AndreaGiulianini/lira/production/images/case-back.jpg

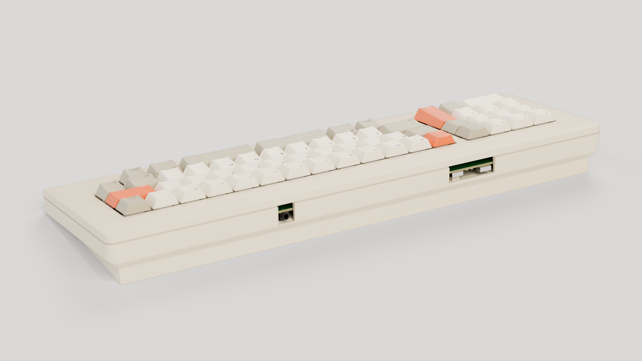
production/images/case-back.jpg
