AndreaGiulianini/lira/production/images/case-bottom.jpg

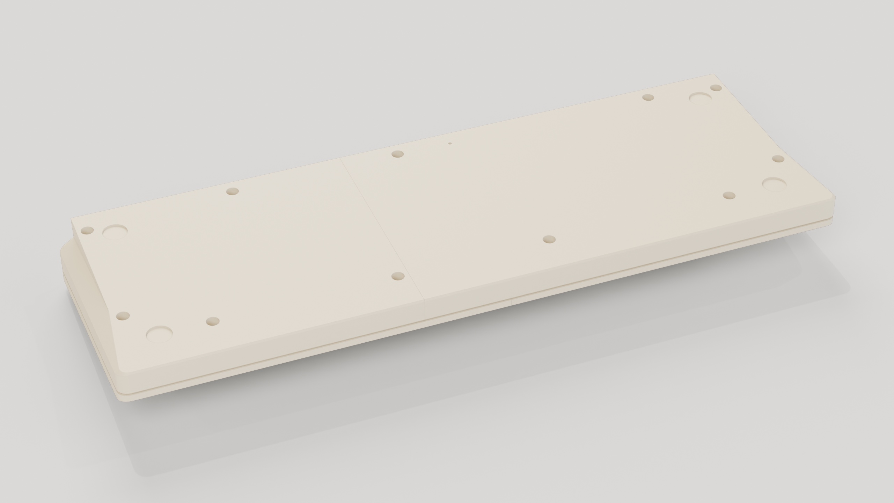
production/images/case-bottom.jpg
