AndreaGiulianini/lira/production/images/case-exploded.jpg

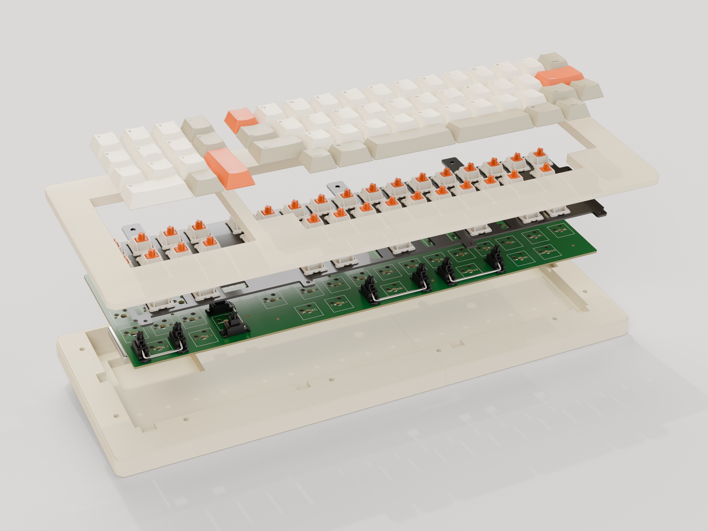
production/images/case-exploded.jpg
