AndreaGiulianini/lira/production/images/case-front.jpg

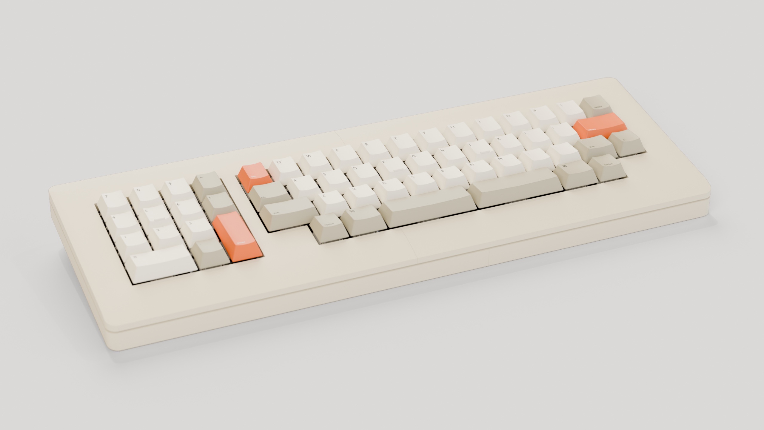
production/images/case-front.jpg
