AndreaGiulianini/lira/production/images/case-side.jpg

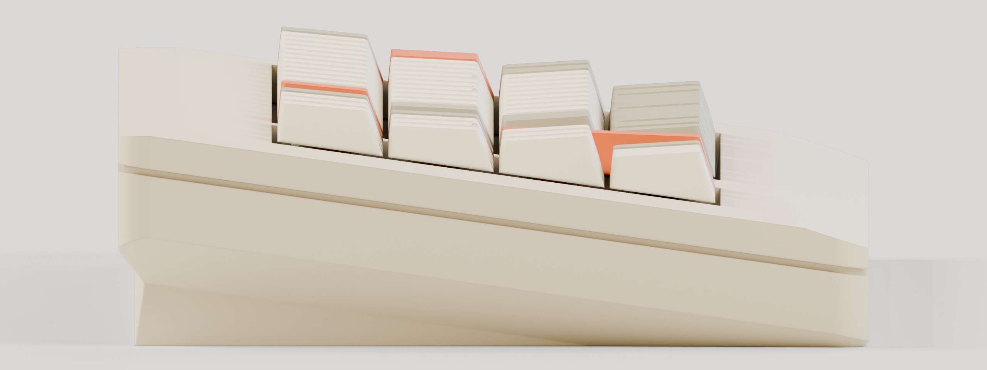
production/images/case-side.jpg
