AndreaGiulianini/lira/production/images/case-top.jpg

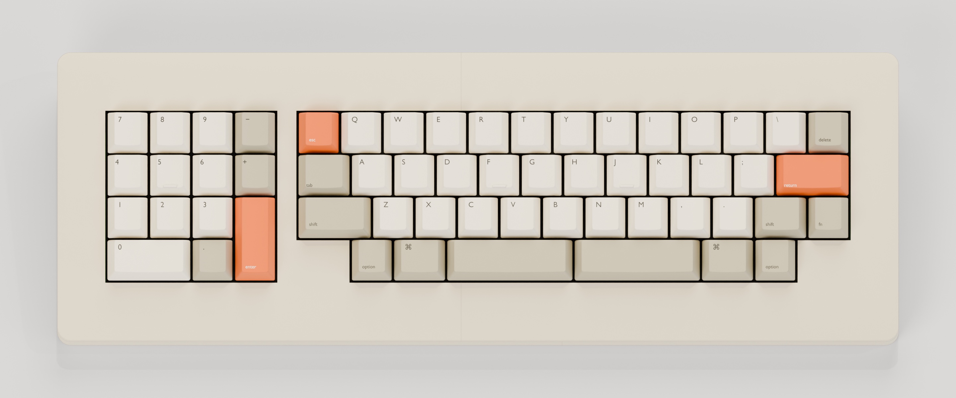
production/images/case-top.jpg
