AndreaGiulianini/lira/production/images/layout.png

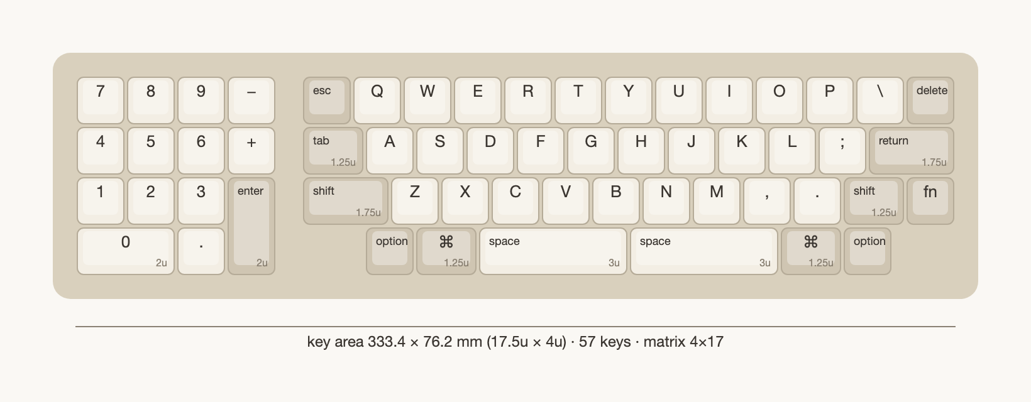
production/images/layout.png
