AndreaGiulianini/lira/production/images/pcb-bottom.jpg

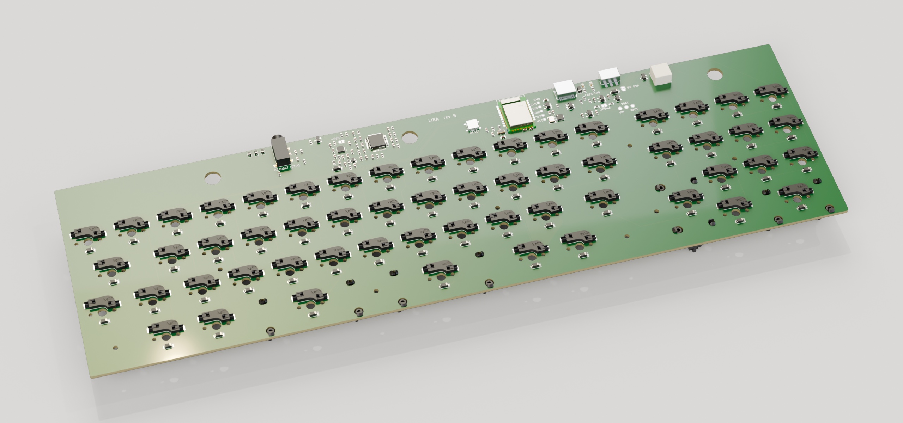
production/images/pcb-bottom.jpg
