AndreaGiulianini/lira/production/images/pcb-top.jpg

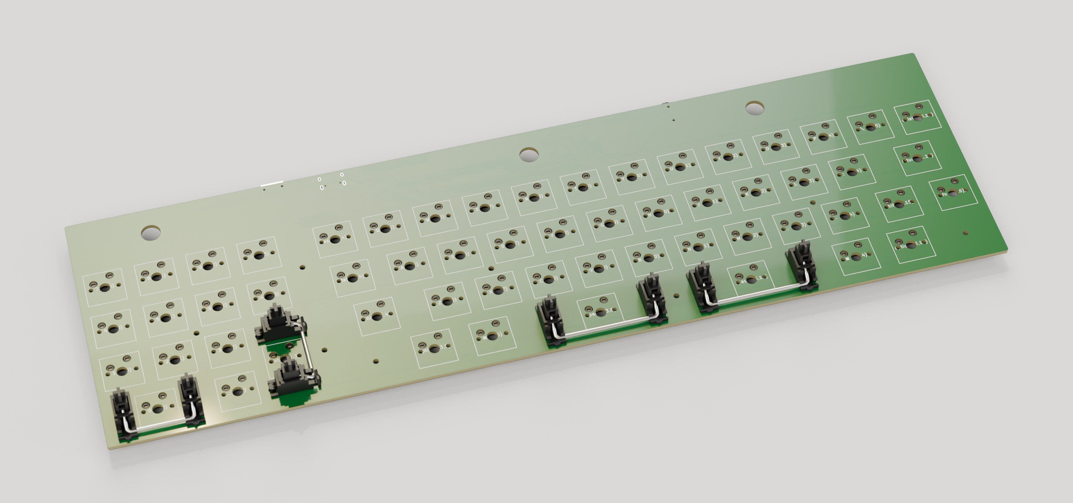
production/images/pcb-top.jpg
