AndreaGiulianini/lira/production/1-pcb-jlcpcb/bom.csv

Comment | Designator | Footprint | LCSC Part #
10uF | C101,C111,C113,C120,C121,C122 | C_0603_1608Metric | C19702
1uF | C102,C108,C110,C118,C123,C126,C129,C130,C135,C136 | C_0603_1608Metric | C15849
4.7uF | C103,C107,C116,C127 | C_0603_1608Metric | C19666
10nF | C104,C138,C139 | C_0603_1608Metric | C57112
18pF | C105,C106 | C_0603_1608Metric | C53084486
100nF | C109,C112,C114,C115,C117,C119,C137 | C_0603_1608Metric | C14663
100pF | C124,C125,C128 | C_0603_1608Metric | C14858
2.2uF | C133,C134 | C_0603_1608Metric | C23630
1N4148W | D1,D10,D11,D12,D13,D14,D15,D16,D17,D18,D19,D2,D20,D21,D22,D23,D24,D25,D26,D27,D28,D29,D3,D30,D31,D32,D33,D34,D35,D36,D37,D38,D39,D4,D40,D41,D42,D43,D44,D45,D46,D47,D48,D49,D5,D50,D51,D52,D53,D54,D55,D56,D57,D6,D7,D8,D9 | D_SOD-123 | C81598
B5819W | D101,D104 | D_SOD-123 | C8598
LED white | D102 | LED_0603_1608Metric | C2290
LED red | D103 | LED_0603_1608Metric | C2286
PESD5V0 | D105,D106,D107 | D_SOD-323 | C19224
SMF5.0A | D108 | D_SOD-123F | C193402
USB-C | J1 | USB_C_Receptacle_HRO_TYPE-C-31-M-12 | C165948
battery JST-PH | J2 | JST_PH_S2B-PH-SM4-TB_1x02-1MP_P2.00mm_Horizontal | C295747
PJ-320D-4A | J3 | Jack_3.5mm_KoreanHropartsElec_PJ-320D-4A_Horizontal | C95562
600R@100MHz | L101,L102,L103,L104 | L_0603_1608Metric | C1002
SI2301CDS | Q1,Q2 | SOT-23 | C10487
2N7002 | Q3 | SOT-23 | C8545
100k | R101,R112,R117,R125 | R_0603_1608Metric | C25803
1k | R102,R107,R116,R118 | R_0603_1608Metric | C21190
10k | R103,R104,R120,R121,R122,R123 | R_0603_1608Metric | C25804
10M | R105,R106 | R_0603_1608Metric | C7250
5.1k | R108,R109 | R_0603_1608Metric | C23186
22 | R110,R111 | R_0603_1608Metric | C23345
1M | R113 | R_0603_1608Metric | C22935
1.2k | R114 | R_0603_1608Metric | C22765
2.2k | R115 | R_0603_1608Metric | C4190
33k | R124 | R_0603_1608Metric | C4216
1 | R126 | R_0603_1608Metric | C22936
MX hot-swap socket (Kailh CPG151101S11 type) | S1,S10,S11,S12,S13,S14,S15,S16,S17,S18,S19,S2,S20,S21,S22,S23,S24,S25,S26,S27,S28,S29,S3,S30,S31,S32,S33,S34,S35,S36,S37,S38,S39,S4,S40,S41,S42,S43,S44,S45,S46,S47,S48,S49,S5,S50,S51,S52,S53,S54,S55,S56,S57,S6,S7,S8,S9 | Kailh_MX_Hotswap | C41430893
JS102011SAQN | SW101 | SW_SPDT_CK_JS102011SAQN | C221660
reset | SW102 | SW-SMD_4P-L5.1-W5.1-P3.70-LS6.5-TL_H1.5 | C318884
E73-2G4M08S1C | U1 | WIRELM-SMD_E73-2G4M08S1C | C356849
MCP73831 | U2 | SOT-23-5 | C424093
TPS7A0233 | U3,U9 | SOT-23-5 | C2887324
USBLC6-2SC6 | U4 | SOT-23-6 | C7519
CH334P | U5 | WCH_QFN-16-1EP_3x3mm_P0.5mm_EP1.8x1.8mm | C5373042
CM108B | U6 | LQFP-48_7x7mm_P0.5mm | C371347
TPA6132A2 | U7 | WQFN-16-1EP_3x3mm_P0.5mm_EP1.68x1.68mm | C69901
TPS22919 | U8 | SOT-363_SC-70-6 | C2149796
32.768kHz | Y1 | Crystal_SMD_3215-2Pin_3.2x1.5mm | C32346
12MHz | Y2 | Crystal_SMD_3225-4Pin_3.2x2.5mm | C9002
