AndreaGiulianini/lira/production/2-plate/3d-print/step/plate-left.step

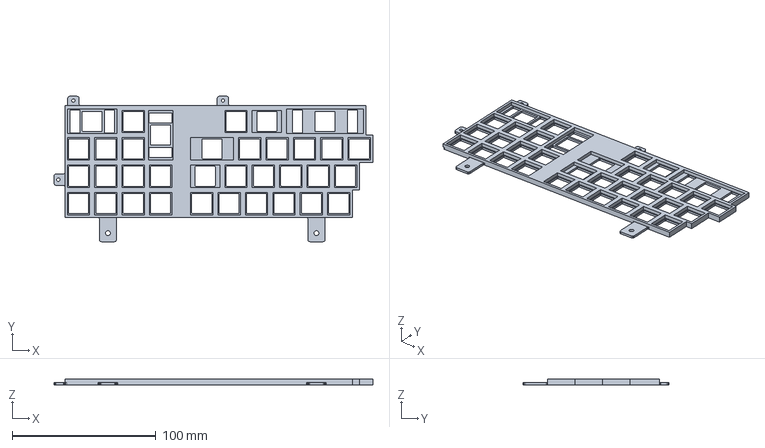
[picture p11: CAD file, 2026-10-17]
production/2-plate/3d-print/step/plate-left.step
221.8 x 101.2 x 4.00 mm
