AndreaGiulianini/lira/production/2-plate/laser-cut/plate.dxf

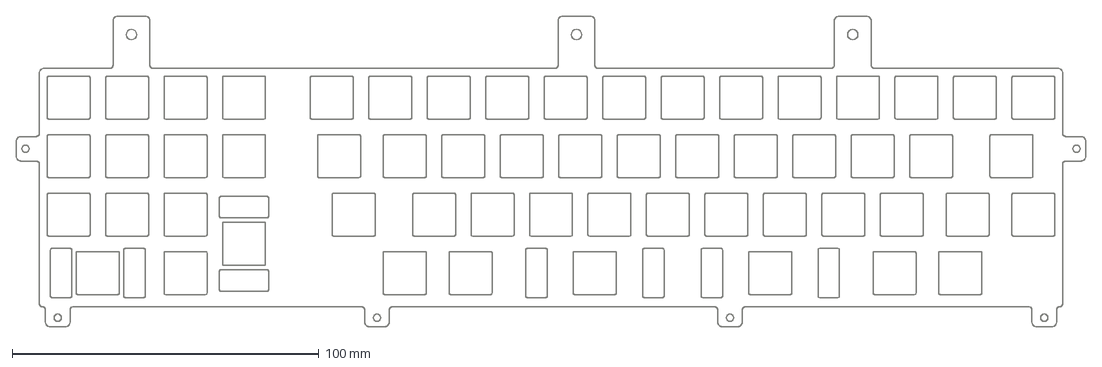
[picture p12: CAD file, 2026-10-17]
production/2-plate/laser-cut/plate.dxf
348.4 x 101.2 mm
