AndreaGiulianini/lira/production/3-case-3d-print/step/bottom-left.step

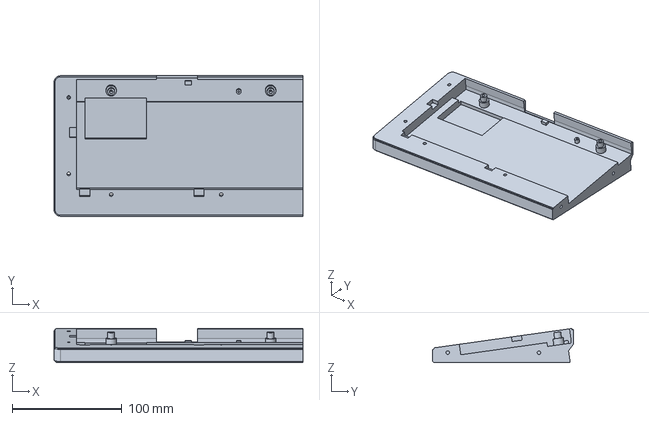
[picture p13: CAD file, 2026-10-17]
production/3-case-3d-print/step/bottom-left.step
226.4 x 127.8 x 31.0 mm
