AndreaGiulianini/lira/production/2-plate/3d-print/step/plate-right.step

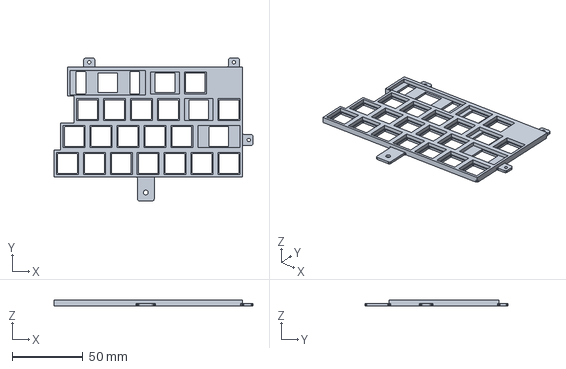
[picture p14: CAD file, 2026-10-17]
production/2-plate/3d-print/step/plate-right.step
140.8 x 101.2 x 4.00 mm
