AndreaGiulianini/lira/production/3-case-3d-print/step/top-right.step

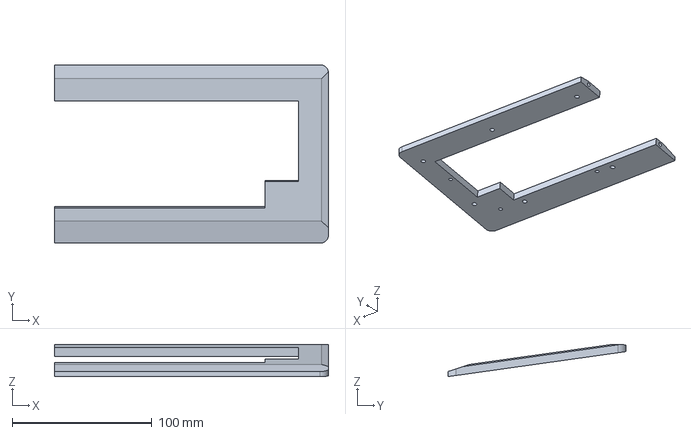
[picture p15: CAD file, 2026-10-17]
production/3-case-3d-print/step/top-right.step
196.2 x 127.8 x 23.1 mm
