AndreaGiulianini/lira/production/3-case-3d-print/step/bottom-right.step

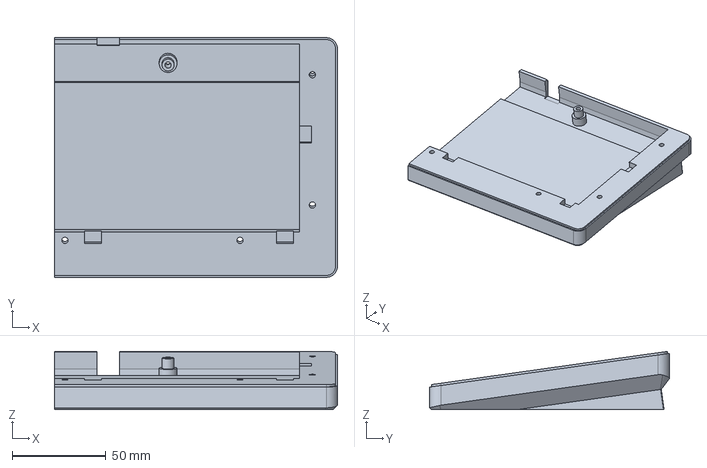
[picture p16: CAD file, 2026-10-17]
production/3-case-3d-print/step/bottom-right.step
150.9 x 127.8 x 31.0 mm
