AndreaGiulianini/lira/production/3-case-3d-print/step/top-left.step

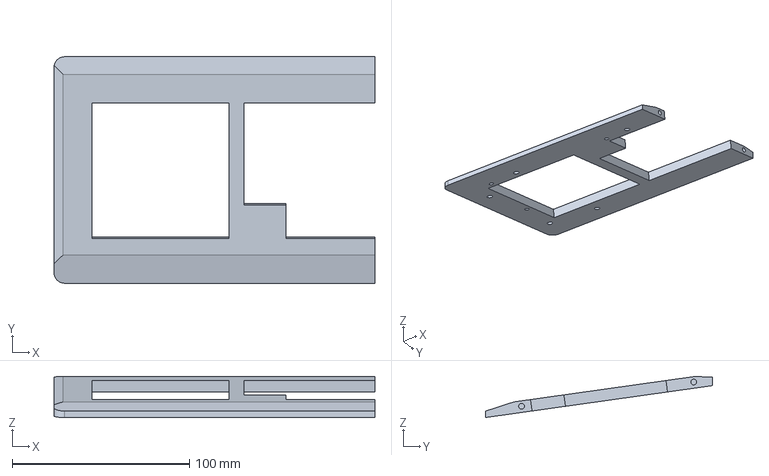
[picture p17: CAD file, 2026-10-17]
production/3-case-3d-print/step/top-left.step
181.1 x 127.8 x 23.1 mm
