AndreaGiulianini/lira/(list of files, cad)

Other CAD files:
production/2-plate/3d-print/plate-left.stl
production/2-plate/3d-print/plate-right.stl
production/3-case-3d-print/bottom-left.stl
production/3-case-3d-print/bottom-right.stl
production/3-case-3d-print/top-left.stl
production/3-case-3d-print/top-right.stl
