AndreaGiulianini/lira/production/kicad/lira.kicad_pcb

## KiCad design production/kicad/lira.kicad_pcb (2026-10-17)

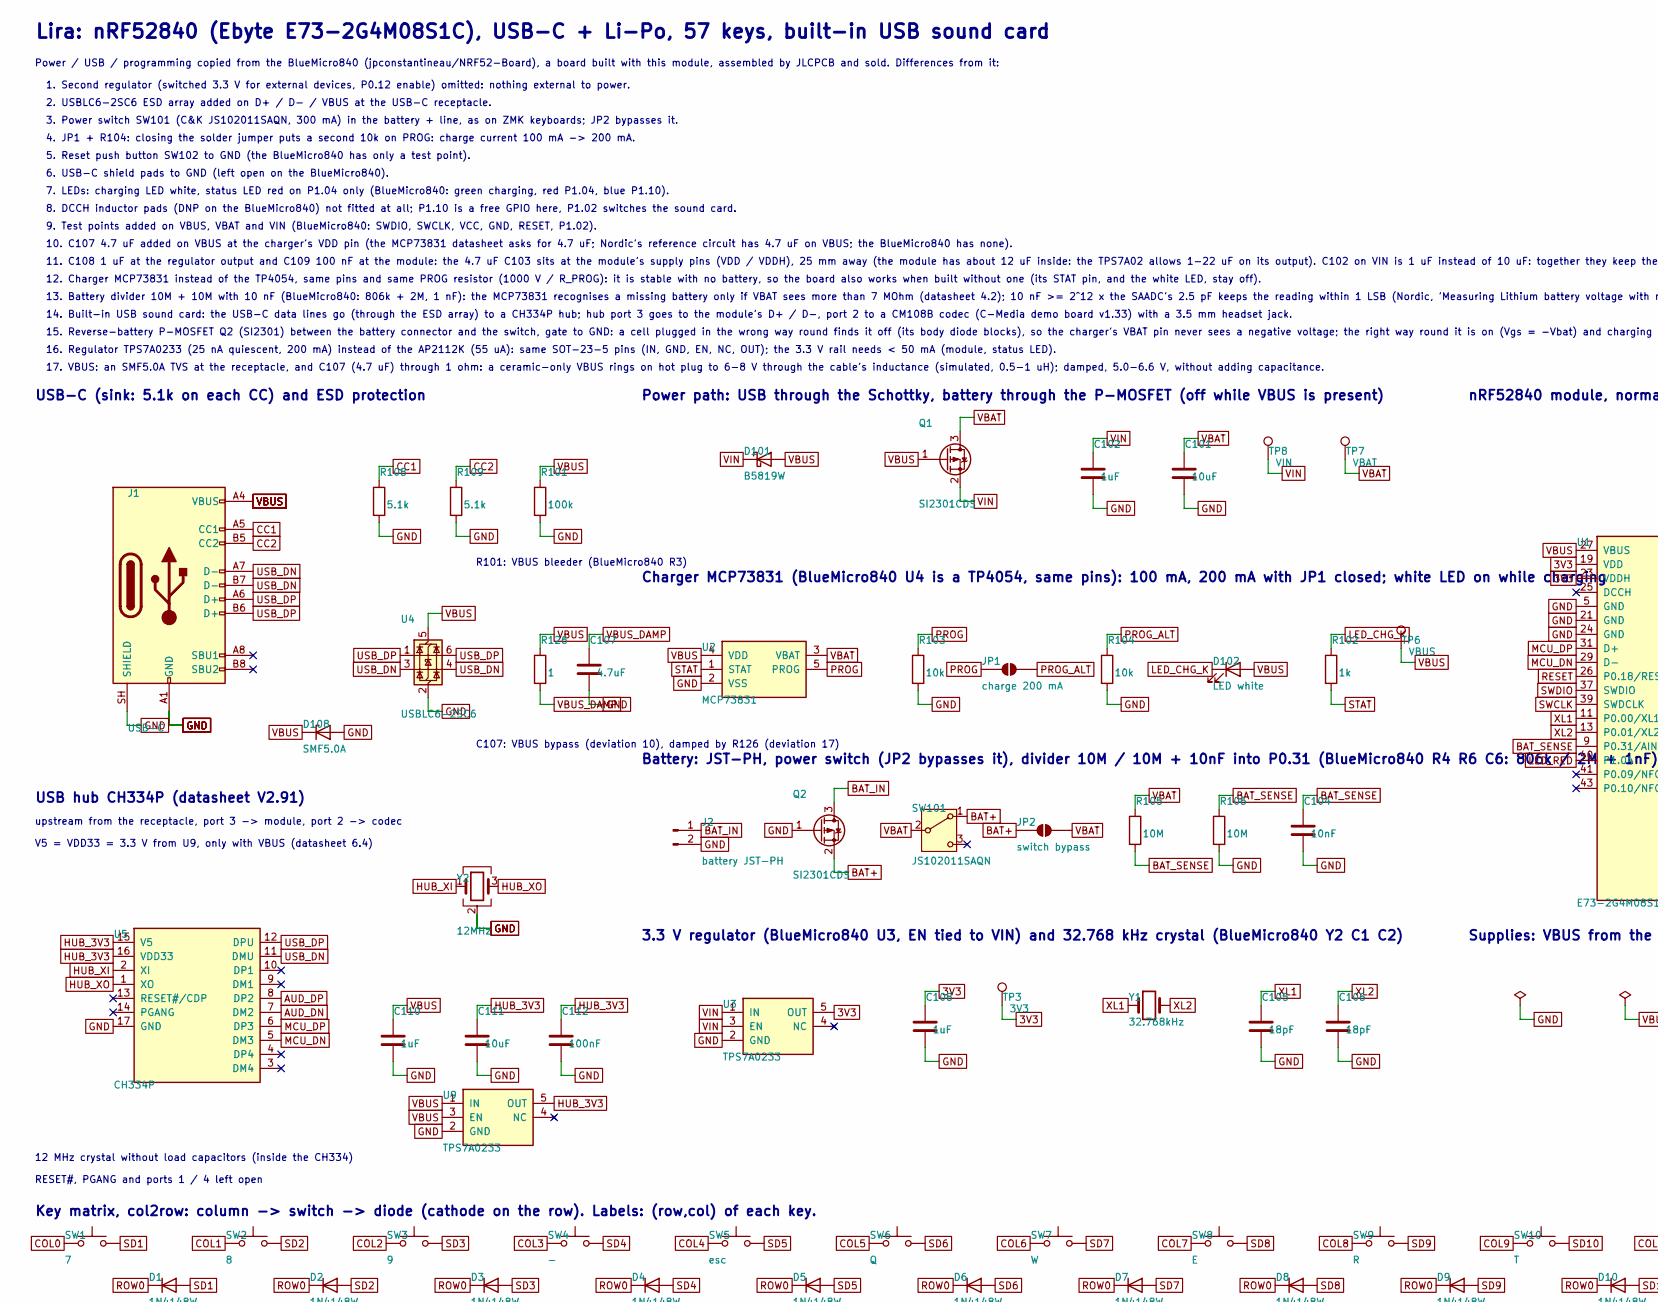
[picture p19: schematic lira.kicad_sch, part in row 1, column 1]

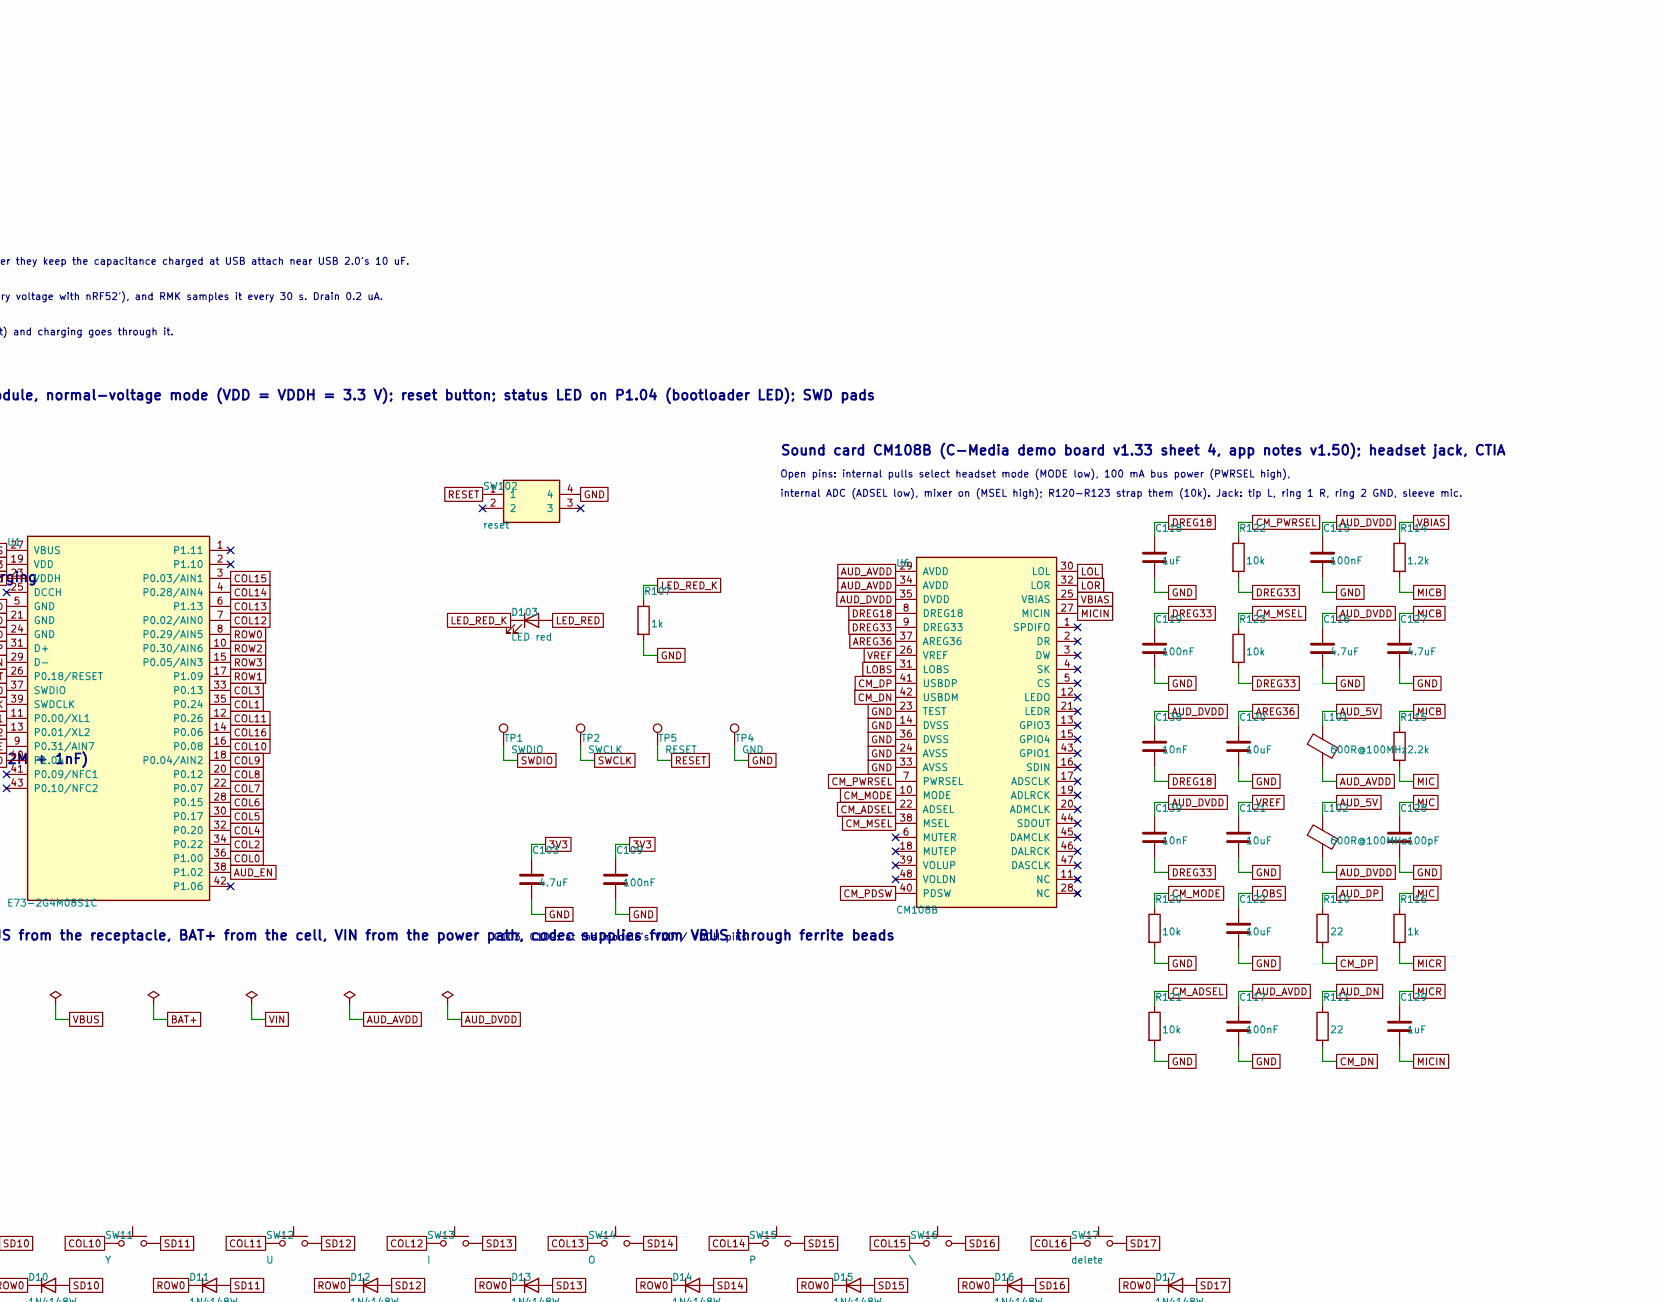
[picture p20: schematic lira.kicad_sch, part in row 1, column 2]

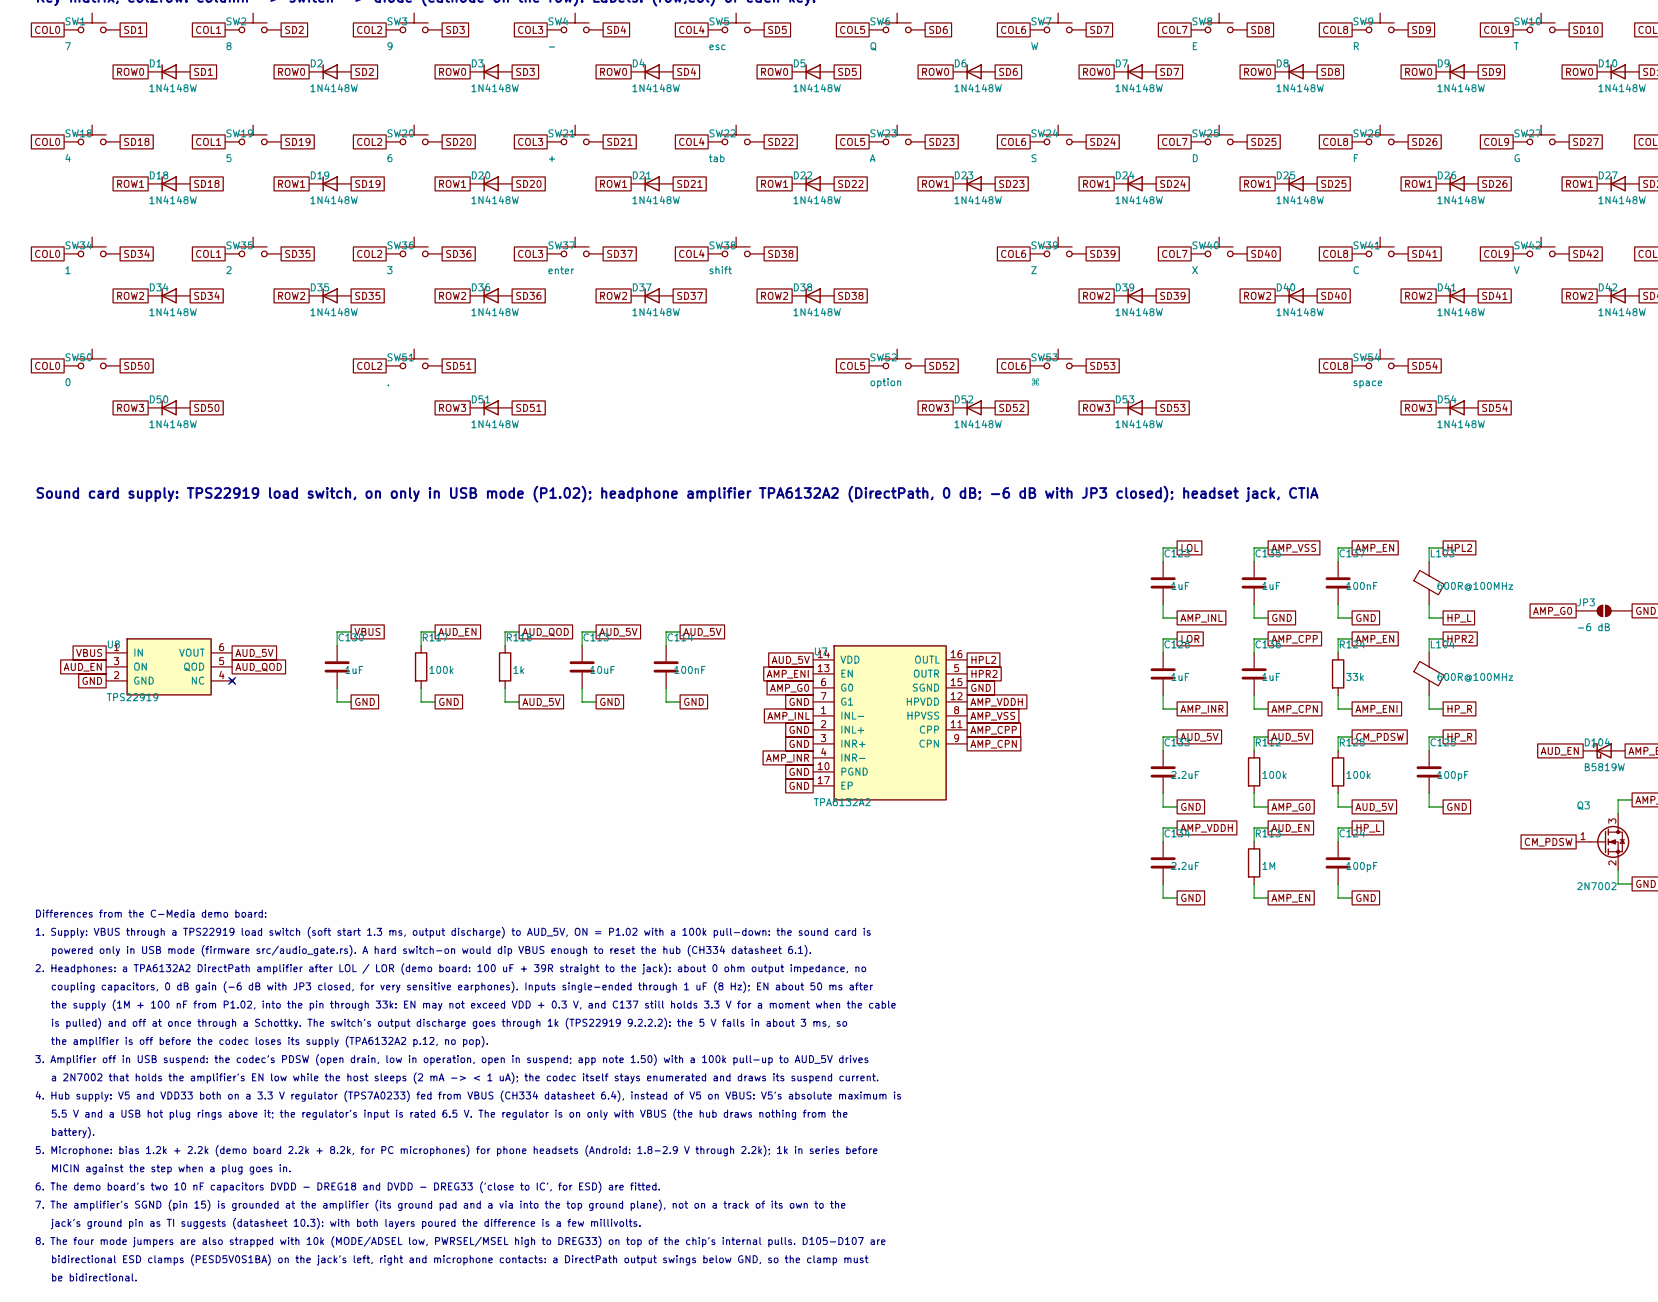
[picture p21: schematic lira.kicad_sch, part in row 2, column 1]

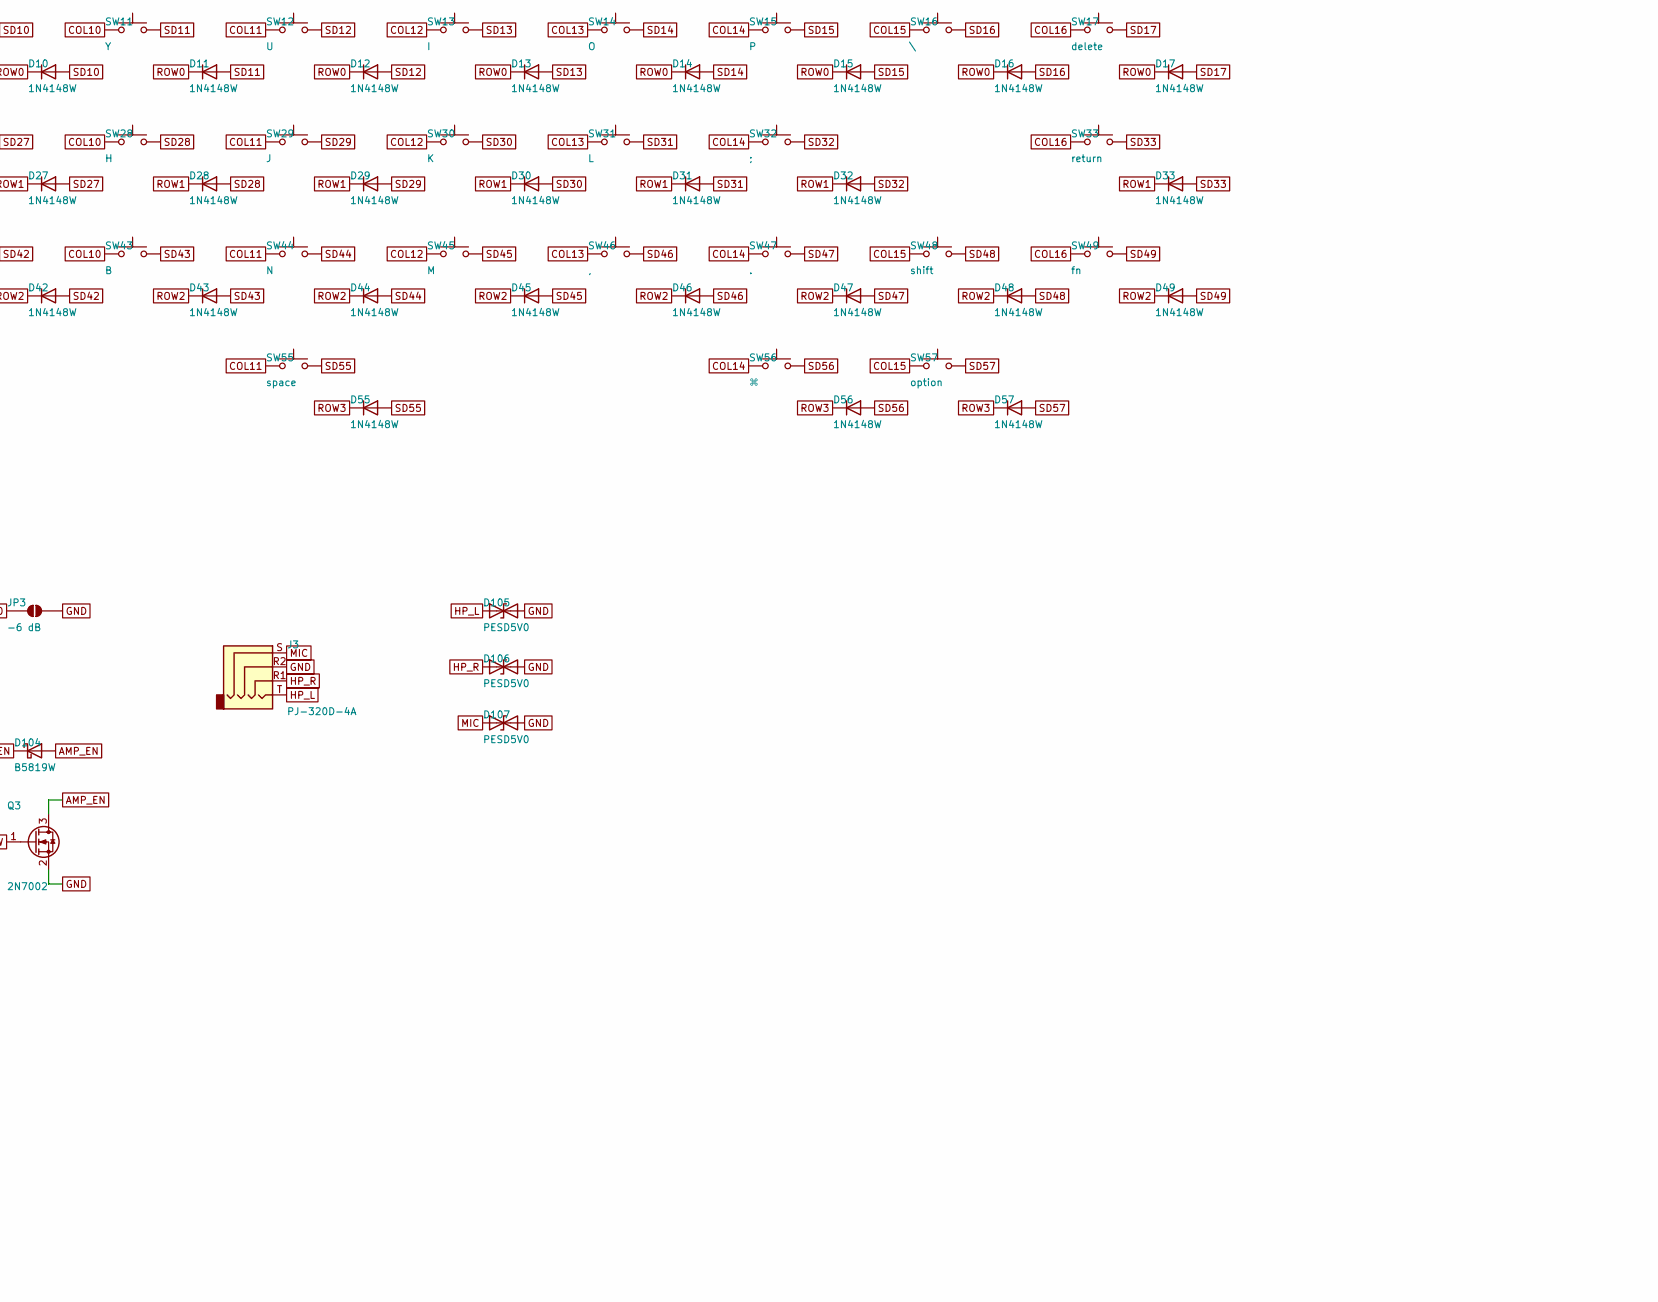
[picture p22: schematic lira.kicad_sch, part in row 2, column 2]

Parts:
C101, C111, C113, C120, C121, C122: 10uF; C_0603_1608Metric; LCSC C19702
C102, C108, C110, C118, C123, C126, C129, C130, C135, C136: 1uF; C_0603_1608Metric; LCSC C15849
C103, C107, C116, C127: 4.7uF; C_0603_1608Metric; LCSC C19666
C104, C138, C139: 10nF; C_0603_1608Metric; LCSC C57112
C105, C106: 18pF; C_0603_1608Metric; LCSC C53084486
C109, C112, C114, C115, C117, C119, C137: 100nF; C_0603_1608Metric; LCSC C14663
C124, C125, C128: 100pF; C_0603_1608Metric; LCSC C14858
C133, C134: 2.2uF; C_0603_1608Metric; LCSC C23630
D1, D2, D3, D4, D5, D6, D7, D8, D9, D10, D11, D12, D13, D14, D15, D16, D17, D18, D19, D20, D21, D22, D23, D24, D25, D26, D27, D28, D29, D30, D31, D32, D33, D34, D35, D36, D37, D38, D39, D40, D41, D42, D43, D44, D45, D46, D47, D48, D49, D50, D51, D52, D53, D54, D55, D56, D57: 1N4148W; D_SOD-123; LCSC C81598
D101, D104: B5819W; D_SOD-123; LCSC C8598
D102: LED white; LED_0603_1608Metric; LCSC C2290
D103: LED red; LED_0603_1608Metric; LCSC C2286
D105, D106, D107: PESD5V0; D_SOD-323; LCSC C19224
D108: SMF5.0A; D_SOD-123F; LCSC C193402
J1: USB-C; USB_C_Receptacle_HRO_TYPE-C-31-M-12; LCSC C165948
J2: battery JST-PH; JST_PH_S2B-PH-SM4-TB_1x02-1MP_P2.00mm_Horizontal; LCSC C295747
J3: PJ-320D-4A; Jack_3.5mm_KoreanHropartsElec_PJ-320D-4A_Horizontal; LCSC C95562
JP1: charge 200 mA; SolderJumper-2_P1.3mm_Open_RoundedPad1.0x1.5mm
JP2: switch bypass; SolderJumper-2_P1.3mm_Open_RoundedPad1.0x1.5mm
JP3: -6 dB; SolderJumper-2_P1.3mm_Open_RoundedPad1.0x1.5mm
L101, L102, L103, L104: 600R@100MHz; L_0603_1608Metric; LCSC C1002
Q1, Q2: SI2301CDS; SOT-23; LCSC C10487
Q3: 2N7002; SOT-23; LCSC C8545
R101, R112, R117, R125: 100k; R_0603_1608Metric; LCSC C25803
R102, R107, R116, R118: 1k; R_0603_1608Metric; LCSC C21190
R103, R104, R120, R121, R122, R123: 10k; R_0603_1608Metric; LCSC C25804
R105, R106: 10M; R_0603_1608Metric; LCSC C7250
R108, R109: 5.1k; R_0603_1608Metric; LCSC C23186
R110, R111: 22; R_0603_1608Metric; LCSC C23345
R113: 1M; R_0603_1608Metric; LCSC C22935
R114: 1.2k; R_0603_1608Metric; LCSC C22765
R115: 2.2k; R_0603_1608Metric; LCSC C4190
R124: 33k; R_0603_1608Metric; LCSC C4216
R126: 1; R_0603_1608Metric; LCSC C22936
SW1: 7; SW_Hotswap_Kailh_MX_1.00u; LCSC C41430893
SW2: 8; SW_Hotswap_Kailh_MX_1.00u; LCSC C41430893
SW3: 9; SW_Hotswap_Kailh_MX_1.00u; LCSC C41430893
SW4: −; SW_Hotswap_Kailh_MX_1.00u; LCSC C41430893
SW5: esc; SW_Hotswap_Kailh_MX_1.00u; LCSC C41430893
SW6: Q; SW_Hotswap_Kailh_MX_1.00u; LCSC C41430893
SW7: W; SW_Hotswap_Kailh_MX_1.00u; LCSC C41430893
SW8: E; SW_Hotswap_Kailh_MX_1.00u; LCSC C41430893
SW9: R; SW_Hotswap_Kailh_MX_1.00u; LCSC C41430893
SW10: T; SW_Hotswap_Kailh_MX_1.00u; LCSC C41430893
SW11: Y; SW_Hotswap_Kailh_MX_1.00u; LCSC C41430893
SW12: U; SW_Hotswap_Kailh_MX_1.00u; LCSC C41430893
SW13: I; SW_Hotswap_Kailh_MX_1.00u; LCSC C41430893
SW14: O; SW_Hotswap_Kailh_MX_1.00u; LCSC C41430893
SW15: P; SW_Hotswap_Kailh_MX_1.00u; LCSC C41430893
SW16: \; SW_Hotswap_Kailh_MX_1.00u; LCSC C41430893
SW17: delete; SW_Hotswap_Kailh_MX_1.00u; LCSC C41430893
SW18: 4; SW_Hotswap_Kailh_MX_1.00u; LCSC C41430893
SW19: 5; SW_Hotswap_Kailh_MX_1.00u; LCSC C41430893
SW20: 6; SW_Hotswap_Kailh_MX_1.00u; LCSC C41430893
SW21: +; SW_Hotswap_Kailh_MX_1.00u; LCSC C41430893
SW22: tab; SW_Hotswap_Kailh_MX_1.25u; LCSC C41430893
SW23: A; SW_Hotswap_Kailh_MX_1.00u; LCSC C41430893
SW24: S; SW_Hotswap_Kailh_MX_1.00u; LCSC C41430893
SW25: D; SW_Hotswap_Kailh_MX_1.00u; LCSC C41430893
SW26: F; SW_Hotswap_Kailh_MX_1.00u; LCSC C41430893
SW27: G; SW_Hotswap_Kailh_MX_1.00u; LCSC C41430893
SW28: H; SW_Hotswap_Kailh_MX_1.00u; LCSC C41430893
SW29: J; SW_Hotswap_Kailh_MX_1.00u; LCSC C41430893
SW30: K; SW_Hotswap_Kailh_MX_1.00u; LCSC C41430893
SW31: L; SW_Hotswap_Kailh_MX_1.00u; LCSC C41430893
SW32: ;; SW_Hotswap_Kailh_MX_1.00u; LCSC C41430893
SW33: return; SW_Hotswap_Kailh_MX_1.75u; LCSC C41430893
SW34: 1; SW_Hotswap_Kailh_MX_1.00u; LCSC C41430893
SW35: 2; SW_Hotswap_Kailh_MX_1.00u; LCSC C41430893
SW36: 3; SW_Hotswap_Kailh_MX_1.00u; LCSC C41430893
SW37: enter; SW_Hotswap_Kailh_MX_2.00u_90deg; LCSC C41430893
SW38: shift; SW_Hotswap_Kailh_MX_1.75u; LCSC C41430893
SW39: Z; SW_Hotswap_Kailh_MX_1.00u; LCSC C41430893
SW40: X; SW_Hotswap_Kailh_MX_1.00u; LCSC C41430893
SW41: C; SW_Hotswap_Kailh_MX_1.00u; LCSC C41430893
SW42: V; SW_Hotswap_Kailh_MX_1.00u; LCSC C41430893
SW43: B; SW_Hotswap_Kailh_MX_1.00u; LCSC C41430893
SW44: N; SW_Hotswap_Kailh_MX_1.00u; LCSC C41430893
SW45: M; SW_Hotswap_Kailh_MX_1.00u; LCSC C41430893
SW46: ,; SW_Hotswap_Kailh_MX_1.00u; LCSC C41430893
SW47, SW51: .; SW_Hotswap_Kailh_MX_1.00u; LCSC C41430893
SW48: shift; SW_Hotswap_Kailh_MX_1.25u; LCSC C41430893
SW49: fn; SW_Hotswap_Kailh_MX_1.00u; LCSC C41430893
SW50: 0; SW_Hotswap_Kailh_MX_2.00u; LCSC C41430893
SW52, SW57: option; SW_Hotswap_Kailh_MX_1.00u; LCSC C41430893
SW53, SW56: ⌘; SW_Hotswap_Kailh_MX_1.25u; LCSC C41430893
SW54, SW55: space; SW_Hotswap_Kailh_MX_3.00u; LCSC C41430893
SW101: JS102011SAQN; SW_SPDT_CK_JS102011SAQN; LCSC C221660
SW102: reset; SW-SMD_4P-L5.1-W5.1-P3.70-LS6.5-TL_H1.5; LCSC C318884
TP1: SWDIO; TestPoint_Pad_D1.0mm
TP2: SWCLK; TestPoint_Pad_D1.0mm
TP3: 3V3; TestPoint_Pad_D1.0mm
TP4: GND; TestPoint_Pad_D1.0mm
TP5: RESET; TestPoint_Pad_D1.0mm
TP6: VBUS; TestPoint_Pad_D1.5mm
TP7: VBAT; TestPoint_Pad_D1.5mm
TP8: VIN; TestPoint_Pad_D1.5mm
U1: E73-2G4M08S1C; WIRELM-SMD_E73-2G4M08S1C; LCSC C356849
U2: MCP73831; SOT-23-5; LCSC C424093
U3, U9: TPS7A0233; SOT-23-5; LCSC C2887324
U4: USBLC6-2SC6; SOT-23-6; LCSC C7519
U5: CH334P; WCH_QFN-16-1EP_3x3mm_P0.5mm_EP1.8x1.8mm; LCSC C5373042
U6: CM108B; LQFP-48_7x7mm_P0.5mm; LCSC C371347
U7: TPA6132A2; WQFN-16-1EP_3x3mm_P0.5mm_EP1.68x1.68mm; LCSC C69901
U8: TPS22919; SOT-363_SC-70-6; LCSC C2149796
Y1: 32.768kHz; Crystal_SMD_3215-2Pin_3.2x1.5mm; LCSC C32346
Y2: 12MHz; Crystal_SMD_3225-4Pin_3.2x2.5mm; LCSC C9002

Connections:
3V3: C103.1, C108.1, C109.1, TP3.1, U1.19 (VDD), U1.23 (VDDH), U3.5 (OUT)
AMP_CPN: C136.2, U7.9 (CPN)
AMP_CPP: C136.1, U7.11 (CPP)
AMP_EN: C137.1, D104.2 (A), Q3.3 (D), R113.2, R124.1
AMP_ENI: R124.2, U7.13 (EN)
AMP_G0: JP3.1 (A), R112.2, U7.6 (G0)
AMP_INL: C123.2, U7.1 (INL-)
AMP_INR: C126.2, U7.4 (INR-)
AMP_VDDH: C134.1, U7.12 (HPVDD)
AMP_VSS: C135.1, U7.8 (HPVSS)
AREG36: C120.1, U6.37 (AREG36)
AUD_5V: C113.1, C114.1, C133.1, L101.1, L102.1, R112.1, R118.2, R125.2, U7.14 (VDD), U8.6 (VOUT)
AUD_AVDD: C117.1, L101.2, U6.29 (AVDD), U6.34 (AVDD)
AUD_DN: R111.1, U5.7 (DM2)
AUD_DP: R110.1, U5.8 (DP2)
AUD_DVDD: C115.1, C116.1, C138.1, C139.1, L102.2, U6.35 (DVDD)
AUD_EN: D104.1 (K), R113.1, R117.1, U1.38 (P1.02), U8.3 (ON)
AUD_QOD: R118.1, U8.5 (QOD)
BAT+: JP2.1 (A), Q2.2 (S), SW101.1 (A)
BAT_IN: J2.1, Q2.3 (D)
BAT_SENSE: C104.1, R105.2, R106.1, U1.9 (P0.31/AIN7)
CC1: J1.A5 (CC1), R108.1
CC2: J1.B5 (CC2), R109.1
CM_ADSEL: R121.1, U6.22 (ADSEL)
CM_DN: R111.2, U6.42 (USBDM)
CM_DP: R110.2, U6.41 (USBDP)
CM_MODE: R120.1, U6.10 (MODE)
CM_MSEL: R123.1, U6.38 (MSEL)
CM_PDSW: Q3.1 (G), R125.1, U6.40 (PDSW)
CM_PWRSEL: R122.1, U6.7 (PWRSEL)
COL0: SW1.1, SW18.1, SW34.1, SW50.1, U1.36 (P1.00)
COL1: SW2.1, SW19.1, SW35.1, U1.35 (P0.24)
COL2: SW3.1, SW20.1, SW36.1, SW51.1, U1.34 (P0.22)
COL3: SW4.1, SW21.1, SW37.1, U1.33 (P0.13)
COL4: SW5.1, SW22.1, SW38.1, U1.32 (P0.20)
COL5: SW6.1, SW23.1, SW52.1, U1.30 (P0.17)
COL6: SW7.1, SW24.1, SW39.1, SW53.1, U1.28 (P0.15)
COL7: SW8.1, SW25.1, SW40.1, U1.22 (P0.07)
COL8: SW9.1, SW26.1, SW41.1, SW54.1, U1.20 (P0.12)
COL9: SW10.1, SW27.1, SW42.1, U1.18 (P0.04/AIN2)
COL10: SW11.1, SW28.1, SW43.1, U1.16 (P0.08)
COL11: SW12.1, SW29.1, SW44.1, SW55.1, U1.12 (P0.26)
COL12: SW13.1, SW30.1, SW45.1, U1.7 (P0.02/AIN0)
COL13: SW14.1, SW31.1, SW46.1, U1.6 (P1.13)
COL14: SW15.1, SW32.1, SW47.1, SW56.1, U1.4 (P0.28/AIN4)
COL15: SW16.1, SW48.1, SW57.1, U1.3 (P0.03/AIN1)
COL16: SW17.1, SW33.1, SW49.1, U1.14 (P0.06)
DREG18: C118.1, C138.2, U6.8 (DREG18)
DREG33: C119.1, C139.2, R122.2, R123.2, U6.9 (DREG33)
GND: C101.2, C102.2, C103.2, C104.2, C105.2, C106.2, C107.2, C108.2, C109.2, C110.2, C111.2, C112.2, C113.2, C114.2, C115.2, C116.2, C117.2, C118.2, C119.2, C120.2, C121.2, C122.2, C124.2, C125.2, C127.2, C128.2, C130.2, C133.2, C134.2, C135.2, C137.2, D105.2 (A2), D106.2 (A2), D107.2 (A2), D108.2 (A), J1.A1 (GND), J1.A12 (GND), J1.B1 (GND), J1.B12 (GND), J1.SH (SHIELD), J2.2, J3.R2, JP3.2 (B), Q2.1 (G), Q3.2 (S), R101.2, R103.2, R104.2, R106.2, R107.2, R108.2, R109.2, R117.2, R120.2, R121.2, SW102.4, TP4.1, U1.5 (GND), U1.21 (GND), U1.24 (GND), U2.2 (VSS), U3.2 (GND), U4.2 (GND), U5.17 (GND), U6.14 (DVSS), U6.23 (TEST), U6.24 (AVSS), U6.33 (AVSS), U6.36 (DVSS), U7.2 (INL+), U7.3 (INR+), U7.7 (G1), U7.10 (PGND), U7.15 (SGND), U7.17 (EP), U8.2 (GND), U9.2 (GND), Y2.2 (G), Y2.4 (G)
HPL2: L103.1, U7.16 (OUTL)
HPR2: L104.1, U7.5 (OUTR)
HP_L: C124.1, D105.1 (A1), J3.T, L103.2
HP_R: C125.1, D106.1 (A1), J3.R1, L104.2
HUB_3V3: C111.1, C112.1, U5.15 (V5), U5.16 (VDD33), U9.5 (OUT)
HUB_XI: U5.2 (XI), Y2.1
HUB_XO: U5.1 (XO), Y2.3
LED_CHG_K: D102.1 (K), R102.1
LED_RED: D103.2 (A), U1.40 (P1.04)
LED_RED_K: D103.1 (K), R107.1
LOBS: C122.1, U6.31 (LOBS)
LOL: C123.1, U6.30 (LOL)
LOR: C126.1, U6.32 (LOR)
MCU_DN: U1.29 (D-), U5.5 (DM3)
MCU_DP: U1.31 (D+), U5.6 (DP3)
MIC: C128.1, D107.1 (A1), J3.S, R115.2, R116.1
MICB: C127.1, R114.2, R115.1
MICIN: C129.2, U6.27 (MICIN)
MICR: C129.1, R116.2
PROG: JP1.1 (A), R103.1, U2.5 (PROG)
PROG_ALT: JP1.2 (B), R104.1
RESET: SW102.1, TP5.1, U1.26 (P0.18/RESET)
ROW0: D1.1 (K), D2.1 (K), D3.1 (K), D4.1 (K), D5.1 (K), D6.1 (K), D7.1 (K), D8.1 (K), D9.1 (K), D10.1 (K), D11.1 (K), D12.1 (K), D13.1 (K), D14.1 (K), D15.1 (K), D16.1 (K), D17.1 (K), U1.8 (P0.29/AIN5)
ROW1: D18.1 (K), D19.1 (K), D20.1 (K), D21.1 (K), D22.1 (K), D23.1 (K), D24.1 (K), D25.1 (K), D26.1 (K), D27.1 (K), D28.1 (K), D29.1 (K), D30.1 (K), D31.1 (K), D32.1 (K), D33.1 (K), U1.17 (P1.09)
ROW2: D34.1 (K), D35.1 (K), D36.1 (K), D37.1 (K), D38.1 (K), D39.1 (K), D40.1 (K), D41.1 (K), D42.1 (K), D43.1 (K), D44.1 (K), D45.1 (K), D46.1 (K), D47.1 (K), D48.1 (K), D49.1 (K), U1.10 (P0.30/AIN6)
ROW3: D50.1 (K), D51.1 (K), D52.1 (K), D53.1 (K), D54.1 (K), D55.1 (K), D56.1 (K), D57.1 (K), U1.15 (P0.05/AIN3)
SD1: D1.2 (A), SW1.2
SD2: D2.2 (A), SW2.2
SD3: D3.2 (A), SW3.2
SD4: D4.2 (A), SW4.2
SD5: D5.2 (A), SW5.2
SD6: D6.2 (A), SW6.2
SD7: D7.2 (A), SW7.2
SD8: D8.2 (A), SW8.2
SD9: D9.2 (A), SW9.2
SD10: D10.2 (A), SW10.2
SD11: D11.2 (A), SW11.2
SD12: D12.2 (A), SW12.2
SD13: D13.2 (A), SW13.2
SD14: D14.2 (A), SW14.2
SD15: D15.2 (A), SW15.2
SD16: D16.2 (A), SW16.2
SD17: D17.2 (A), SW17.2
SD18: D18.2 (A), SW18.2
SD19: D19.2 (A), SW19.2
SD20: D20.2 (A), SW20.2
SD21: D21.2 (A), SW21.2
SD22: D22.2 (A), SW22.2
SD23: D23.2 (A), SW23.2
SD24: D24.2 (A), SW24.2
SD25: D25.2 (A), SW25.2
SD26: D26.2 (A), SW26.2
SD27: D27.2 (A), SW27.2
SD28: D28.2 (A), SW28.2
SD29: D29.2 (A), SW29.2
SD30: D30.2 (A), SW30.2
SD31: D31.2 (A), SW31.2
SD32: D32.2 (A), SW32.2
SD33: D33.2 (A), SW33.2
SD34: D34.2 (A), SW34.2
SD35: D35.2 (A), SW35.2
SD36: D36.2 (A), SW36.2
SD37: D37.2 (A), SW37.2
SD38: D38.2 (A), SW38.2
SD39: D39.2 (A), SW39.2
SD40: D40.2 (A), SW40.2
SD41: D41.2 (A), SW41.2
SD42: D42.2 (A), SW42.2
SD43: D43.2 (A), SW43.2
SD44: D44.2 (A), SW44.2
SD45: D45.2 (A), SW45.2
SD46: D46.2 (A), SW46.2
SD47: D47.2 (A), SW47.2
SD48: D48.2 (A), SW48.2
SD49: D49.2 (A), SW49.2
SD50: D50.2 (A), SW50.2
SD51: D51.2 (A), SW51.2
SD52: D52.2 (A), SW52.2
SD53: D53.2 (A), SW53.2
SD54: D54.2 (A), SW54.2
SD55: D55.2 (A), SW55.2
SD56: D56.2 (A), SW56.2
SD57: D57.2 (A), SW57.2
STAT: R102.2, U2.1 (STAT)
SWCLK: TP2.1, U1.39 (SWDCLK)
SWDIO: TP1.1, U1.37 (SWDIO)
USB_DN: J1.A7 (D-), J1.B7 (D-), U4.3 (I/O2), U4.4 (I/O2), U5.11 (DMU)
USB_DP: J1.A6 (D+), J1.B6 (D+), U4.1 (I/O1), U4.6 (I/O1), U5.12 (DPU)
VBAT: C101.1, JP2.2 (B), Q1.3 (D), R105.1, SW101.2 (B), TP7.1, U2.3 (VBAT)
VBIAS: R114.1, U6.25 (VBIAS)
VBUS: C110.1, C130.1, D101.2 (A), D102.2 (A), D108.1 (K), J1.A4 (VBUS), J1.A9 (VBUS), J1.B4 (VBUS), J1.B9 (VBUS), Q1.1 (G), R101.1, R126.1, TP6.1, U1.27 (VBUS), U2.4 (VDD), U4.5 (VBUS), U8.1 (IN), U9.1 (IN), U9.3 (EN)
VBUS_DAMP: C107.1, R126.2
VIN: C102.1, D101.1 (K), Q1.2 (S), TP8.1, U3.1 (IN), U3.3 (EN)
VREF: C121.1, U6.26 (VREF)
XL1: C105.1, U1.11 (P0.00/XL1), Y1.1
XL2: C106.1, U1.13 (P0.01/XL2), Y1.2

Notes on the sheet:
Lira: nRF52840 (Ebyte E73-2G4M08S1C), USB-C + Li-Po, 57 keys, built-in USB sound card
Power / USB / programming copied from the BlueMicro840 (jpconstantineau/NRF52-Board), a board built with this module, assembled by JLCPCB and sold. Differences from it:
1. Second regulator (switched 3.3 V for external devices, P0.12 enable) omitted: nothing external to power.
2. USBLC6-2SC6 ESD array added on D+ / D- / VBUS at the USB-C receptacle.
3. Power switch SW101 (C&K JS102011SAQN, 300 mA) in the battery + line, as on ZMK keyboards; JP2 bypasses it.
4. JP1 + R104: closing the solder jumper puts a second 10k on PROG: charge current 100 mA -> 200 mA.
5. Reset push button SW102 to GND (the BlueMicro840 has only a test point).
6. USB-C shield pads to GND (left open on the BlueMicro840).
7. LEDs: charging LED white, status LED red on P1.04 only (BlueMicro840: green charging, red P1.04, blue P1.10).
8. DCCH inductor pads (DNP on the BlueMicro840) not fitted at all; P1.10 is a free GPIO here, P1.02 switches the sound card.
9. Test points added on VBUS, VBAT and VIN (BlueMicro840: SWDIO, SWCLK, VCC, GND, RESET, P1.02).
10. C107 4.7 uF added on VBUS at the charger's VDD pin (the MCP73831 datasheet asks for 4.7 uF; Nordic's reference circuit has 4.7 uF on VBUS; the BlueMicro840 has none).
11. C108 1 uF at the regulator output and C109 100 nF at the module: the 4.7 uF C103 sits at the module's supply pins (VDD / VDDH), 25 mm away (the module has about 12 uF inside: the TPS7A02 allows 1-22 uF on its output). C102 on VIN is 1 uF instead of 10 uF: together they keep the capacitance char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
12. Charger MCP73831 instead of the TP4054, same pins and same PROG resistor (1000 V / R_PROG): it is stable with no battery, so the board also works when built without one (its STAT pin, and the white LED, stay off).
13. Battery divider 10M + 10M with 10 nF (BlueMicro840: 806k + 2M, 1 nF): the MCP73831 recognises a missing battery only if VBAT sees more than 7 MOhm (datasheet 4.2); 10 nF >= 2^12 x the SAADC's 2.5 pF keeps the reading within 1 LSB (Nordic, 'Measuring Lithium battery voltage with nRF52'), and RMK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
14. Built-in USB sound card: the USB-C data lines go (through the ESD array) to a CH334P hub; hub port 3 goes to the module's D+ / D-, port 2 to a CM108B codec (C-Media demo board v1.33) with a 3.5 mm headset jack.
15. Reverse-battery P-MOSFET Q2 (SI2301) between the battery connector and the switch, gate to GND: a cell plugged in the wrong way round finds it off (its body diode blocks), so the charger's VBAT pin never sees a negative voltage; the right way round it is on (Vgs = -Vbat) and charging goes throu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
16. Regulator TPS7A0233 (25 nA quiescent, 200 mA) instead of the AP2112K (55 uA): same SOT-23-5 pins (IN, GND, EN, NC, OUT); the 3.3 V rail needs < 50 mA (module, status LED).
17. VBUS: an SMF5.0A TVS at the receptacle, and C107 (4.7 uF) through 1 ohm: a ceramic-only VBUS rings on hot plug to 6-8 V through the cable's inductance (simulated, 0.5-1 uH); damped, 5.0-6.6 V, without adding capacitance.
USB-C (sink: 5.1k on each CC) and ESD protection
C107: VBUS bypass (deviation 10), damped by R126 (deviation 17)
R101: VBUS bleeder (BlueMicro840 R3)
Power path: USB through the Schottky, battery through the P-MOSFET (off while VBUS is present)
Charger MCP73831 (BlueMicro840 U4 is a TP4054, same pins): 100 mA, 200 mA with JP1 closed; white LED on while charging
Battery: JST-PH, power switch (JP2 bypasses it), divider 10M / 10M + 10nF into P0.31 (BlueMicro840 R4 R6 C6: 806k / 2M + 1nF)
3.3 V regulator (BlueMicro840 U3, EN tied to VIN) and 32.768 kHz crystal (BlueMicro840 Y2 C1 C2)
nRF52840 module, normal-voltage mode (VDD = VDDH = 3.3 V); reset button; status LED on P1.04 (bootloader LED); SWD pads
C103, C109: at the module's VDD / VDDH pins
Supplies: VBUS from the receptacle, BAT+ from the cell, VIN from the power path, codec supplies from VBUS through ferrite beads
USB hub CH334P (datasheet V2.91)
upstream from the receptacle, port 3 -> module, port 2 -> codec
V5 = VDD33 = 3.3 V from U9, only with VBUS (datasheet 6.4)
12 MHz crystal without load capacitors (inside the CH334)
RESET#, PGANG and ports 1 / 4 left open
Sound card CM108B (C-Media demo board v1.33 sheet 4, app notes v1.50); headset jack, CTIA
Open pins: internal pulls select headset mode (MODE low), 100 mA bus power (PWRSEL high),
internal ADC (ADSEL low), mixer on (MSEL high); R120-R123 strap them (10k). Jack: tip L, ring 1 R, ring 2 GND, sleeve mic.
Sound card supply: TPS22919 load switch, on only in USB mode (P1.02); headphone amplifier TPA6132A2 (DirectPath, 0 dB; -6 dB with JP3 closed); headset jack, CTIA
Differences from the C-Media demo board:
1. Supply: VBUS through a TPS22919 load switch (soft start 1.3 ms, output discharge) to AUD_5V, ON = P1.02 with a 100k pull-down: the sound card is
powered only in USB mode (firmware src/audio_gate.rs). A hard switch-on would dip VBUS enough to reset the hub (CH334 datasheet 6.1).
2. Headphones: a TPA6132A2 DirectPath amplifier after LOL / LOR (demo board: 100 uF + 39R straight to the jack): about 0 ohm output impedance, no
coupling capacitors, 0 dB gain (-6 dB with JP3 closed, for very sensitive earphones). Inputs single-ended through 1 uF (8 Hz); EN about 50 ms after
the supply (1M + 100 nF from P1.02, into the pin through 33k: EN may not exceed VDD + 0.3 V, and C137 still holds 3.3 V for a moment when the cable
is pulled) and off at once through a Schottky. The switch's output discharge goes through 1k (TPS22919 9.2.2.2): the 5 V falls in about 3 ms, so
the amplifier is off before the codec loses its supply (TPA6132A2 p.12, no pop).
3. Amplifier off in USB suspend: the codec's PDSW (open drain, low in operation, open in suspend; app note 1.50) with a 100k pull-up to AUD_5V drives
a 2N7002 that holds the amplifier's EN low while the host sleeps (2 mA -> < 1 uA); the codec itself stays enumerated and draws its suspend current.
4. Hub supply: V5 and VDD33 both on a 3.3 V regulator (TPS7A0233) fed from VBUS (CH334 datasheet 6.4), instead of V5 on VBUS: V5's absolute maximum is
5.5 V and a USB hot plug rings above it; the regulator's input is rated 6.5 V. The regulator is on only with VBUS (the hub draws nothing from the
battery).
5. Microphone: bias 1.2k + 2.2k (demo board 2.2k + 8.2k, for PC microphones) for phone headsets (Android: 1.8-2.9 V through 2.2k); 1k in series before
MICIN against the step when a plug goes in.
6. The demo board's two 10 nF capacitors DVDD - DREG18 and DVDD - DREG33 ('close to IC', for ESD) are fitted.
7. The amplifier's SGND (pin 15) is grounded at the amplifier (its ground pad and a via into the top ground plane), not on a track of its own to the
jack's ground pin as TI suggests (datasheet 10.3): with both layers poured the difference is a few millivolts.
8. The four mode jumpers are also strapped with 10k (MODE/ADSEL low, PWRSEL/MSEL high to DREG33) on top of the chip's internal pulls. D105-D107 are
bidirectional ESD clamps (PESD5V0S1BA) on the jack's left, right and microphone contacts: a DirectPath output swings below GND, so the clamp must
be bidirectional.
Key matrix, col2row: column -> switch -> diode (cathode on the row). Labels: (row,col) of each key.

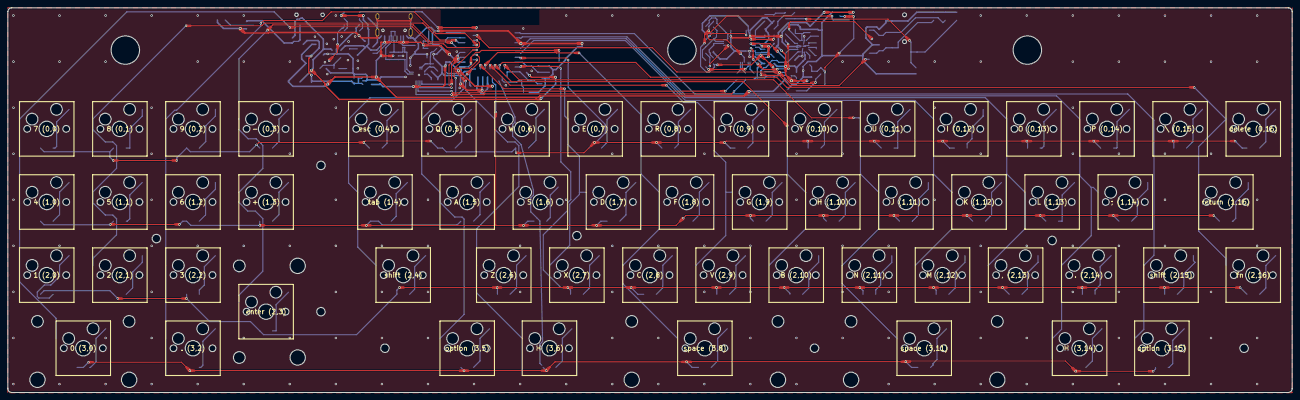
[picture p23: board lira.kicad_pcb from above]

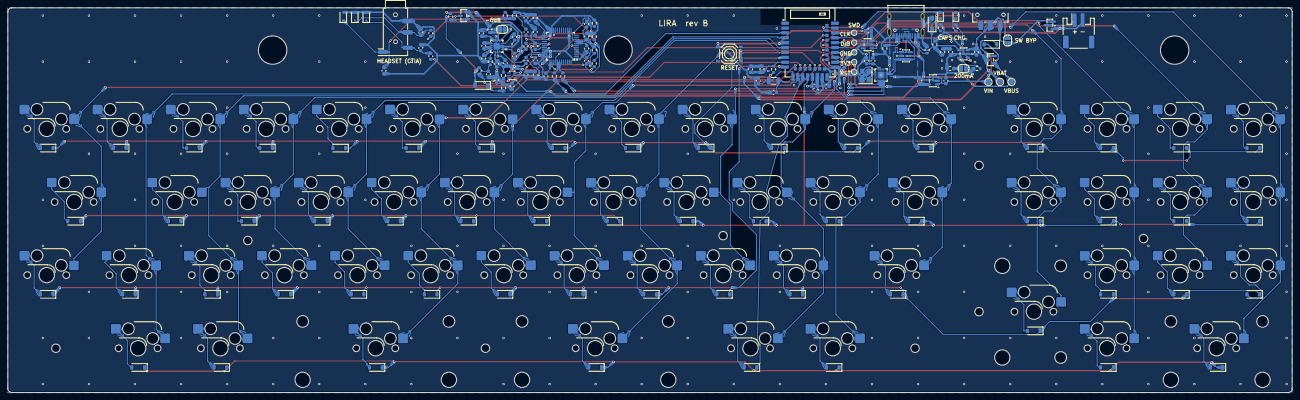
[picture p24: board lira.kicad_pcb from below]

Board: 2 copper layers, 334.6 x 100.2 mm, 233 parts (161 on the bottom side), 146 nets.

Other parts of the board:
H1, H2, H3, H4, H5, H6, H7, H8: M2; MountingHole_2.2mm_M2
HB1, HB2, HB3: case bolt; MountingHole_3.2mm_M3
ST37, ST50: stab 2u; Stabilizer_Cherry_MX_2.00u
ST54, ST55: stab 3u; Stabilizer_Cherry_MX_3.00u
