AndreaGiulianini/lira/source/pcb/check_circuit.py

#!/usr/bin/env python3
"""check_circuit.py - independent electrical rule check for the Lira netlists.

Usage:  python3 check_circuit.py netlist.json [another.json ...]
Exit status is 1 if any check FAILs (WARN and SKIP do not change the exit status).

Standard library only.  Every rule is derived from the component datasheets
(file names below refer to the datasheets/ folder of the review inputs) or from the
USB Type-C specification (CC pull-downs for a sink).  Parts are located by their
value / LCSC code / footprint / pin names, never by reference designator, so the
same checks run unchanged on the BlueMicro840 reference netlist.

Also covered: MCP73831 charger (C01-C06, replacing the TP4054 checks; the
TP4054 is still recognised for the VBAT role, D01 and P04), USB through a CH334P hub (M04, U02, U03,
H01-H03), CM108B USB codec (A01-A06), TPA6132A2 headphone amplifier (A11-A14), TPS22919 audio
load switch and its GPIO enable (S01-S03), PJ-320D-4A CTIA headset jack (J01).

Netlist format:
  {"parts": {REF: {"value", "footprint", "lcsc", "dnp", "note",
                   "pins": {PIN: {"name", "net"}}}},
   "nets": {NET: [[REF, PIN], ...]},
   "matrix": {...}, "gpio": {...}}          (matrix / gpio are optional)
A pin with "net": null is unconnected.

Result levels:
  PASS  requirement met
  FAIL  a datasheet requirement or a wiring rule is violated (exit status 1)
  WARN  a datasheet recommendation is not followed, or something that depends on
        layout / firmware / assembly and cannot be proven from the netlist
  SKIP  the check does not apply to this netlist (part not present)
"""

import json
import math
import re
import sys
from collections import defaultdict, deque

PASS, FAIL, WARN, SKIP = "PASS", "FAIL", "WARN", "SKIP"

# ----------------------------------------------------------------------------
# Datasheet sources (file in datasheets/, PDF page, section)
# ----------------------------------------------------------------------------
SRC = {
    "E73_pins": "E73-2G4M08S1C_C356849.pdf p.7 (ch.3 pin table, nRF52840 ball per pin)",
    "E73_limits": "E73-2G4M08S1C_C356849.pdf p.5 (2.1 abs max 0-5.5 V; 2.2 supply 1.7-5.5 V, "
                  ">=3.3 V for rated TX power, 3.3 V I/O level)",
    "E73_5V": "E73-2G4M08S1C_C356849.pdf p.9 (5.1: 5 V level signals need a 1k-5.1k series resistor, "
              "not recommended)",
    "PS_supply": "nrf52840_ps_a.pdf 5.3.1 p.61 (normal voltage mode = VDD shorted to VDDH), "
                 "5.3.8 p.80 (VDD 1.7-3.6 V), 9 p.612 Table 173 (VDD abs max 3.9 V)",
    "PS_dcdc": "nrf52840_ps_a.pdf 5.3.1.1 p.61-62 (LC filter needed only when a DC/DC regulator "
               "is enabled; Fig.13 normal voltage mode, LDO only), 7.3 p.583-590 (reference circuits)",
    "PS_usb": "nrf52840_ps_a.pdf 5.3.2 p.66 (5 V on VBUS for USB), 8 p.611 (VBUS 4.35-5.5 V), "
              "9 p.612 (VBUS abs max 5.8 V), 7.1 p.577 (AD2 VBUS, AD4 D-, AD6 D+), "
              "7.3 p.583 (series resistor on VBUS recommended for new designs)",
    "PS_swd": "nrf52840_ps_a.pdf 4.8.1 p.51 (SWDIO internal pull-up, SWDCLK internal pull-down), "
              "p.53 (Rpull 13 kOhm), 7.1 p.577 (AA24 SWDCLK, AC24 SWDIO)",
    "PS_reset": "nrf52840_ps_a.pdf 5.3.6.2 p.69 (pin reset), 7.1 p.577 (AC13 P0.18 configurable as "
                "nRESET), p.81 (tPINR vs capacitance on the reset pin); "
                "bluemicro_nrf52840_board.h (BUTTON_DFU = P0.18, BUTTON_PULL = PULLUP)",
    "PS_lfxo": "nrf52840_ps_a.pdf 5.4.2.4 p.86-87 (Fig.23: C1/C2 from XL1/XL2 to GND, equal values, "
               "CL per crystal datasheet), 5.4.4.3 p.97 (CL 12.5 pF, C0 <=2 pF, ESR <=100 kOhm, "
               "drive 0.5 uW, Cpin 4 pF); C32346.pdf p.1 (Epson FC-135 Q13FC13500004: CL 12.5 pF, "
               "ESR 70 kOhm max, C0 1 pF, drive level 0.5 uW max)",
    "PS_nfc": "nrf52840_ps_a.pdf 6.14.3 p.209 (NFC1/NFC2 shared with P0.09/P0.10, UICR NFCPINS "
              "selects GPIO use), 7.1 p.576 (L24 P0.09/NFC1, J24 P0.10/NFC2)",
    "PS_gpio": "nrf52840_ps_a.pdf 6.9.3.1 p.156 (IOH/IOL standard drive 1-4 mA, high drive 6-15 mA), "
               "9 p.612 (VI/O max VDD+0.3 V)",
    "PS_saadc": "nrf52840_ps_a.pdf 6.23 p.376 (inputs AIN0-AIN7), 6.23.1.1 p.377-378 Fig.147 (the SAADC connects a "
                "sample capacitor to the input for TACQ) and Table 95 (max source resistance per TACQ, 800 kOhm at 40 us, "
                "for a resistive source), 6.23.2 p.379 (gain 1/6 + 0.6 V reference = 3.6 V range, AIN <= VDD), "
                "6.23.10 p.397 (CSAMPLE 2.5 pF at maximum gain = the largest, RINPUT > 1 MOhm, tACQ table), p.398 "
                "(RLADDER 160 kOhm); Nordic DevZone blog 'Measuring Lithium battery voltage with nRF52' (O. Bauck, "
                "2016-05-23: reservoir Cext = Csample x 2^12 ~ 10 nF, R1 4M / R2 10M, TACQ 3 us, SAADC input seen "
                "as 1/(fsample Csample))",
    # TP4054 (BlueMicro840 reference only: still recognised as the charger for the VBAT role,
    # for D01's CHRG sink and for P04; its C01-C05 checks were replaced by the MCP73831 ones)
    "TP_limits": "C32574.pdf (TP4054) p.2 (abs max: VCC 10 V, BAT 7 V, CHRG 10 V, BAT pin 800 mA, "
                 "PROG pin 800 uA; BAT -> VCC reverse current blocked), p.3 (VCC 4.0-9.0 V, VFLOAT 4.2 V +-1 %)",
    "TP_chrg": "C32574.pdf (TP4054) p.6-7 (CHRG open drain: ~10 mA pull-down while charging, "
               "20 uA weak pull-down when done, Hi-Z in UVLO), p.11 (sinks up to 10 mA for a LED), "
               "p.3 (VOL 0.3 V typ, 0.5 V max at 5 mA)",
    # MCP73831T-2ACI/OT (LCSC C424093), MCP73831_C424093.pdf = Microchip DS20001984H (PDF page = printed page)
    "MCP_pins": "MCP73831_C424093.pdf p.1 (Package Types, SOT-23-5: 1 STAT, 2 VSS, 3 VBAT, 4 VDD, 5 PROG), "
                "p.11 Table 3-1 (pin functions), p.3 (abs max VDD 7.0 V, all other pins -0.3..VDD+0.3 V; "
                "VDD 3.75-6 V; VREG 4.168/4.20/4.232 V for MCP7383X-2), p.11 3.1 ([VREG+0.3 V] to 6 V "
                "recommended), p.26 (product ID: -2ACI = 4.20 V, option AC: IPREG 10 %, VPTH 66.5 %, ITERM 7.5 %, "
                "VRTH 96.5 %)",
    "MCP_vdd": "MCP73831_C424093.pdf p.11 3.1 (VDD: bypass to VSS with a minimum of 4.7 uF), p.18 6.1.1.2 "
               "(input overvoltage protection must be used with hot-pluggable sources, USB cables included: "
               "a transzorb from V+ to 0 V), p.17 Fig.6-1 (SMAJ5.0A); usblc6.pdf p.2 (VBUS-GND breakdown "
               ">= 6 V at 1 mA)",
    "MCP_prog": "MCP73831_C424093.pdf p.15 5.1.2 (IREG [mA] = 1000 V / RPROG [kOhm]), p.4 (RPROG charge "
                "range 2-67 kOhm, shutdown impedance 70-200 kOhm), p.3 (IREG 90-110 mA at 10k, 450-550 mA at 2k), "
                "p.13 4.3 / p.15 5.2.2 (PROG open = charger disabled), p.18 6.1.1.3 (P = (VDDMAX - VPTHMIN) * "
                "IREGMAX), p.5 (SOT-23-5 theta-JA 230 C/W), p.14 Fig.4-2 (thermal regulation); C221660.pdf p.1 "
                "(slide switch 0.3 A)",
    "MCP_stat": "MCP73831_C424093.pdf p.15 5.2.1 Table 5-1 (STAT: shutdown Hi-Z, no battery Hi-Z, "
                "preconditioning / fast charge / constant voltage L, charge complete H on the MCP73831), "
                "p.4 (STAT sink <= 25 mA, VOL 0.4 V typ / 1 V max at 4 mA; source <= 35 mA, VOH VDD-0.4 V typ / "
                "VDD-1 V min at 4 mA; Hi-Z leakage <= 1 uA), p.11 3.3 (LED or pull-up to a host MCU), "
                "p.13 Fig.4-1",
    "MCP_vbat": "MCP73831_C424093.pdf p.11 3.2 (VBAT: bypass to VSS with a minimum of 4.7 uF to ensure "
                "loop stability when the battery is disconnected), p.18 6.1.1.4 (stable with or without "
                "battery; 4.7 uF at the output usually sufficient up to 500 mA, any ESR)",
    "MCP_det": "MCP73831_C424093.pdf p.13 4.2 (battery detection: 6 uA typ sourced by VBAT; VBAT >= VREG + "
               "100 mV -> no battery; 'in order to correctly detect a battery insertion, the impedance seen by "
               "the VBAT pin before the battery is connected must be greater than 7 MOhm due to the minimum "
               "battery detection current of 0.6 uA'), p.4 (IBAT_DET 0.6 uA min / 6 uA typ; ZNO_BAT 7 MOhm min; "
               "charge-complete output current -5.5 uA typ), p.5 (tTERM 0.4-3.2 ms), p.15 Table 5-1 (no battery: "
               "STAT Hi-Z), p.26 (option AC: recharge at 96.5 % of VREG)",
    # WCH CH334P (LCSC C5373042), CH334_C5373042.pdf = CH334/CH335 datasheet V2.91 (Chinese)
    "CH_pins": "CH334_C5373042.pdf p.2 Fig.1-1 / CH334_C5373042-p2-pinout.png (CH334P QFN-16: 1 XO, 2 XI, "
               "3 DM4, 4 DP4, 5 DM3, 6 DP3, 7 DM2, 8 DP2, 9 DM1, 10 DP1, 11 DMU, 12 DPU, 13 RESET#/CDP, "
               "14 PGANG, 15 V5, 16 VDD33, 0 = exposed pad = GND), p.3 Table 1-1 (CH334P: no over-current / "
               "power-switch pins), p.4-5 Table 1-3 (pin functions)",
    "CH_power": "CH334_C5373042.pdf p.4 Table 1-3 (V5: 5 V or 3.3 V input, 1 uF or more; VDD33: LDO output "
                "and 3.3 V input, 0.1 uF + 10 uF or 1 uF; GND pad), p.19 4.1 (abs max V5 5.5 V, VDD33 4.0 V), "
                "p.19 4.2 (V5 4.5-5.0-5.25 V with the internal LDO, 3.15-3.5 V without; LDO external load "
                "<= 20 mA), p.26 6.1 (bus-powered application: V5 from the upstream VBUS, C1 1 uF, "
                "C2 0.1 uF + C8 10 uF on VDD33), p.28 6.4 (embedded hub: V5 = VDD33 = on-board 3.3 V suggested)",
    "CH_xtal": "CH334_C5373042.pdf p.1 (crystal oscillator with built-in capacitors), p.4 Table 1-3 (XI/XO: "
               "12 MHz crystal, 24 MHz only on the CH334X), p.26 6.1 (XI and XO have ~16 pF built in: no "
               "external load capacitors), p.27 6.2 (crystal-free option only on parts ordered with it: "
               "XO open and XI to GND)",
    "CH_cfg": "CH334_C5373042.pdf p.4 Table 1-3 (RESET#/CDP: internal pull-up, active low, leave fully "
              "floating when no reset is needed), p.10-11 3.2 (internal power-on reset; ~25 kOhm pull-up; "
              "Table 3-2: low = reset, driven high at power-up = CDP on and low-power sleep off, open = default), "
              "p.5 (PGANG: internal pull-up configuration input during reset, status output afterwards; pull-"
              "down only through a resistor)",
    "CH_usb": "CH334_C5373042.pdf p.1 (USB 2.0 hub: upstream HS/FS with a built-in 1.5 kOhm pull-up, "
              "downstream ports with built-in host pull-downs), p.4 Table 1-3 (DPU/DMU upstream D+/D-, DPn/DMn "
              "downstream port n), p.19 4.1 (USB pins -0.4..VDD33+0.4 V), p.29 6.5 (ESD protection advised on "
              "every USB signal); nrf52840_ps_a.pdf 7.3 p.585 Fig.210 (D+/D- wired straight to the USB "
              "connector, no series parts); CM108B_appnotes_v1.50.pdf p.9 3.5 (series resistors for PHY "
              "impedance matching, 39 Ohm in the figure) and C-Media demo board v1.33 sheet 4 (R4/R66 22 Ohm, "
              "C1/C2 100 pF)",
    # C-Media CM108B (LCSC C371347): CM108B_datasheet_v1.41.pdf (= CM108B_C371347.pdf), application notes v1.50,
    # demo board CM108B/CM119B v1.33 sheet 4 (reference/CM108B_CM119B_demoboard_v133_sheet4.png + .txt)
    "CM_pins": "CM108B_datasheet_v1.41.pdf p.6 4.1-4.2 (LQFP-48 pin assignment), p.7-8 4.3 (pin descriptions)",
    "CM_power": "CM108B_datasheet_v1.41.pdf p.4 (DVdd = AVdd = 5 V), p.7 (29/34 AVDD 5 V, 35 DVDD 5 V, "
                "8 DREG18 1.8 V / 9 DREG33 3.3 V (40 mA) / 37 AREG36 3.6 V regulator outputs, 14/36 DVSS, "
                "24/33 AVSS), p.20 8.1-8.2 (supplies 4.5-5.0-5.5 V, abs max 6 V; 37.25 mA; 0-70 C); "
                "CM108B_appnotes_v1.50.pdf p.8 3.4 (1 uF on DREG18, 0.1 uF on DREG33), p.25 (AVDD36: 10 uF to "
                "AGND); demo board v1.33 sheet 4 (L2/L3 beads USB5V -> DVDD/AVDD, DVDD 4.7 uF + 0.1 uF, AVDD "
                "0.1 uF, AVDD36 10 uF, C23/C24 10 nF DVDD -> REGV/DVDD18 'close to IC')",
    "CM_ref": "CM108B_datasheet_v1.41.pdf p.7-8 (26 VREF: decoupling capacitor for the bandgap, 1.75 V; "
              "31 LOBS: 1.75 V DC line-out bias; 25 VBIAS: microphone bias 3 V, 'small driving capability'), "
              "p.20 (analog pins -0.3..3.96 V); demo board v1.33 sheet 4 (VREF C14 10 uF, LOBS C10 10 uF, "
              "cap-less option L10/R18 not fitted); CM108B_appnotes_v1.50.pdf p.7 3.2 (cap-less = LOBS as "
              "the headphone return)",
    "CM_cfg": "CM108B_datasheet_v1.41.pdf p.7-8 (MODE PD: L = headset = playback + recording, H = speaker = "
              "playback only; PWRSEL PU; MSEL PU; ADSEL PD: L = internal ADC; TEST PD: L = normal operation; "
              "'H: push up to 3.3V' i.e. to REGV/DREG33; MUTER/MUTEP/VOLUP/VOLDN PU), p.15 7.2 (mode table), "
              "p.12 (headset configuration: bus powered, 100 mA)",
    "CM_usb": "CM108B_datasheet_v1.41.pdf p.8 (41 USBDP, 42 USBDM), p.20 (analog pins -0.3..3.96 V); "
              "CM108B_appnotes_v1.50.pdf p.9 3.5 (R1/R2 series resistors for PHY impedance matching; no "
              "pull-up on USBDP, it is inside the PHY), p.23 5.3; demo board v1.33 sheet 4 (R4/R66 22 Ohm "
              "in USBDP/USBDM)",
    "CM_audio": "CM108B_datasheet_v1.41.pdf p.7 (25 VBIAS 3 V 'small driving capability', 27 MICIN 10 kOhm "
                "input, 30 LOL / 32 LOR line out, 31 LOBS 1.75 V DC), p.21 (DAC output 0.94 Vrms into 10 kOhm), "
                "p.20 (analog pins -0.3..3.96 V); CM108B_appnotes_v1.50.pdf p.23 5.4 (R + C in series in the "
                "MIC path); demo board v1.33 sheet 4 (VBIAS - R13 2k2 - C15 4.7 uF - R14 8k2 - MIC; MIC - "
                "R10 0 R - C12 1 uF - MICIN; C16 100 pF on MIC; LOL/LOR via C9/C8 100 uF)",
    # TI TPA6132A2RTER (LCSC C69901), TPA6132A2_C69901.pdf = SLOS597B
    "TPA_pins": "TPA6132A2_C69901.pdf p.3 (RTE pinout and pin functions: 1 INL-, 2 INL+, 3 INR+, 4 INR-, "
                "5 OUTR, 6 G0, 7 G1, 8 HPVSS, 9 CPN, 10 PGND, 11 CPP, 12 HPVDD, 13 EN, 14 VDD, 15 SGND, "
                "16 OUTL; thermal pad to ground or floating), p.18 10.1 (pad: same ground as PGND or floating, "
                "never VDD), p.18 10.3 (SGND must go to the headphone ground pin, within +-0.3 V), p.4 "
                "(VDD 2.3-5.5 V, abs max 6 V)",
    "TPA_cp": "TPA6132A2_C69901.pdf p.3 (HPVSS: 1 uF to GND; 1 uF between CPP and CPN; HPVDD: 2.2 uF, do not "
              "connect to VDD), p.4 (HPVDD abs max 1.9 V, never an external supply), p.15 8.2.1.2.2 (HPVSS "
              "cap >= flying cap, 1-2.2 uF typical, >= 0.47 uF), p.17 9 / 9.1 (2.2 uF X5R at VDD within "
              "5 mm; HPVDD only to a 2.2 uF capacitor; boxed warning: HPVDD to VDD can damage the device)",
    "TPA_in": "TPA6132A2_C69901.pdf p.1 + p.3 (single-ended inputs: INL+ and INR+ to ground, signal into "
              "INL-/INR-), p.16 Fig.27 (1 uF in series with each single-ended input), p.15 8.2.1.2.1 (input "
              "capacitors block the DC of the source; fc = 1 / (2 pi RIN CIN)), p.5 (RIN 26.4 / 19.8 / 16.5 / "
              "13.2 kOhm at -6 / 0 / 3 / 6 dB), p.4 (input voltage 0..HPVDD+0.3 V), p.12 7.3.2",
    "TPA_ctl": "TPA6132A2_C69901.pdf p.4 (EN/G0/G1: VIH >= 1.3 V, VIL <= 0.6 V, abs max -0.3..VDD+0.3 V), "
               "p.5 (EN/G0/G1 input current <= 1 uA; gain -0.5/-1.0/-1.41/-2.0 V/V), p.13 7.4.1 (G0/G1 <= "
               "0.5 V or >= 1.3 V: -6 / 0 / 3 / 6 dB), p.12 7.3.2 (activate after the audio sources have "
               "settled, deactivate before the sources; tON 5 ms); C8598.pdf (B5819W) p.1; nrf52840_ps_a.pdf p.156 "
               "(IOL >= 1 mA standard / >= 6 mA high drive at 0.4 V); CM108B_datasheet_v1.41.pdf p.20 (37.25 mA); "
               "TPS22919_C2149796.pdf p.5 (tON, tOFF, RPD,QOD), p.13 8.3.3",
    # TI TPS22919DCKR (LCSC C2149796), TPS22919_C2149796.pdf = SLVSEN5B
    "TPS_pins": "TPS22919_C2149796.pdf p.3 (DCK SC-70-6: 1 IN, 2 GND, 3 ON 'do not leave floating', 4 NC "
                "'leave floating', 5 QOD, 6 VOUT), p.4 (abs max VIN/VOUT/VON/VQOD 6 V; VIN 1.6-5.5 V; IMAX "
                "1.5 A), p.5 (RON 89 mOhm at 5 V; tON 1.95 ms and 3.2 mV/us at 5 V), p.17 10 (CIN 1 uF usually "
                "sufficient)",
    "TPS_on": "TPS22919_C2149796.pdf p.3 (ON: active high, do not leave floating), p.4 (ON VIH >= 1 V, "
              "VIL <= 0.35 V, abs max 6 V), p.5 (ON leakage <= 100 nA; smart pull-down 530 kOhm while ON <= "
              "VIL), p.13 8.3.1 (the smart pull-down exists only once VIN is applied); nrf52840_ps_a.pdf 6.9.3.1 "
              "p.156 (GPIO drive) and 9 p.612 (VI/O max VDD + 0.3 V); reference/bluemicro_nrf52840_board.h "
              "(pins the bootloader drives)",
    "TPS_qod": "TPS22919_C2149796.pdf p.3 (QOD: resistor to VOUT, tied to VOUT, or floating = no discharge), "
               "p.13-14 8.3.3 + Table 2 (ON low: VOUT to GND through RPD,QOD (24 Ohm) + RQOD; tFALL = 2.2 * "
               "(RDIS || RL) * CL), p.5 (RPD,QOD 24 Ohm), p.6 (tFALL 0.4 ms with 10 uF)",
    # Hroparts PJ-320D-4A (LCSC C95562): drawing only
    "JACK": "PJ-320D-4A_C95562.pdf p.1 / PJ-320D-4A_C95562-p1.png (PJ-320D-A schematic: pin 1 = the long "
            "contact reaching the jack opening = sleeve; pins 4 / 3 / 2 = contacts at 3.20 / 6.20 / 10.20 mm "
            "from the front face = ring 2 / ring 1 / tip; pad 1 at 11.30 mm on the other side; 0.5 A 30 V); "
            "KiCad footprint Jack_3.5mm_KoreanHropartsElec_PJ-320D-4A_Horizontal: pads R2 / R1 / T / S sit "
            "on the drawing's pads 4 / 3 / 2 / 1; CTIA headset plug (tip L, ring 1 R, ring 2 GND, sleeve MIC) "
            "- convention, not in the datasheet set; TPA6132A2_C69901.pdf p.3 / p.18 10.3",
    "AP_pins": "C51118.pdf (AP2112) p.2 (SOT25 pins: 1 VIN, 2 GND, 3 EN, 4 NC, 5 VOUT; typical "
               "application CIN = COUT = 1 uF), p.1 (stable with 1.0 uF ceramic)",
    "AP_limits": "C51118.pdf (AP2112) p.3 (abs max VCC 6.5 V, recommended VIN 2.5-6.0 V), "
                 "p.8 (AP2112-3.3: VOUT 3.3 V +-1.5 %, dropout 250 mV typ at 600 mA, "
                 "VEN high >= 1.5 V, low <= 0.4 V, EN pull-down 3 MOhm)",
    "SI_pins": "C10487.pdf (Si2301CDS) p.1 (SOT-23: 1 G, 2 S, 3 D; VDS -20 V, VGS +-8 V), "
               "p.2 (VGS(th) -0.4..-1 V, body diode VSD -0.8 V), p.7 (AN807: pin 1 gate, "
               "pin 2 source, pin 3 drain)",
    "TPS_ldo": "tps7a02.pdf (TI SBVS277C) p.3 Table 5-1 (DBV: 1 IN, 2 GND, 3 EN, 4 NC, 5 OUT), p.4 6.1 (abs max "
               "IN 6.5 V) and 6.3 (VIN 1.5-6.0 V; CIN 1 uF; COUT 1-22 uF, >= 0.5 uF effective), p.6 (accuracy "
               "+-1.5 % for VOUT >= 1.5 V), p.7 (VEN(HI) >= 1.1 V, VEN(LOW) <= 0.3 V), p.19 7.3.2 (smart enable "
               "pull-down; active output discharge when disabled); E73-2G4M08S1C_C356849.pdf p.7 (module "
               "schematic: 4.7 uF on VDD, 4.7 uF on VDDH and 3 x 100 nF inside the module)",
    "REV_fet": "C10487.pdf (Si2301CDS) p.1 (SOT-23: 1 G, 2 S, 3 D; VDS -20 V, VGS +-8 V; PD 0.86 W at 25 C), "
               "p.2 (VGS(th) -0.4..-1 V; RDS(on) 0.112 Ohm max at VGS -4.5 V, 0.142 Ohm at -2.5 V; body diode "
               "VSD -0.8 V); MCP73831_C424093.pdf p.3 (inputs and outputs -0.3..VDD+0.3 V), p.4 (preconditioning "
               "below VPTH), p.26 (option AC: preconditioning 10 %, VPTH 66.5 %)",
    "VBUS_prot": "MCP73831_C424093.pdf p.18 6.1.1.2 and p.17 Fig.6-1 (hot-pluggable inputs: a transzorb, SMAJ5.0A, "
                 "from V+ to 0 V); SMF5.0A (LCSC C193402 listing): unidirectional, VRWM 5.0 V, VC 9.2 V at 21.7 A, "
                 "200 W 10/1000 us; nrf52840_ps_a.pdf 9 p.612 (VBUS abs max 5.8 V); TPS22919_C2149796.pdf p.4 "
                 "(VIN abs max 6 V); tps7a02.pdf p.4 (IN abs max 6.5 V); MCP73831_C424093.pdf p.3 (VDD abs max "
                 "7.0 V); USB 2.0 spec 7.2.4.1 (at most 10 uF across VBUS at attach)",
    "CM_pdsw": "CM108B_datasheet_v1.41.pdf p.8 (pin 40 PDSW: DO, 4 mA, open drain; 0 = normal operation, "
               "1 = power-down / suspend mode); CM108B_appnotes_v1.50.pdf p.8 (PDSW power control supports DC "
               "1.8-5 V; operation: drive low, suspend: open); 2N7002 (LCSC C8545 listing): VDS 60 V, VGS +-20 V, "
               "VGS(th) <= 2.5 V; TPA6132A2_C69901.pdf p.4 (EN VIL <= 0.6 V), p.1 (shutdown current < 1 uA)",
    "B58_pins": "C8598.pdf (B5819W) p.1 (marking bar = cathode; IO 1 A, VRRM 40 V, VF 0.6 V at 1 A)",
    "USBC": "C165948.pdf (HRO TYPE-C-31-M-12) p.1 pin table (A1/B1/A12/B12 GND, A4/A9/B4/B9 VBUS, "
            "A5 CC1, B5 CC2, A6/B6 DP, A7/B7 DN, A8/B8 SBU; 5 A / 20 V rating); "
            "USB Type-C specification (sink: Rd = 5.1 kOhm +-10 % on each CC) - not in the datasheet set",
    "USBLC6": "usblc6.pdf p.1 Fig.1 (SOT23-6L: 1 I/O1, 2 GND, 3 I/O2, 4 I/O2, 5 VBUS, 6 I/O1), "
              "p.2 (VBR VBUS-GND 6 V min, leakage 150 nA at 5.25 V), p.5-6 (place next to the "
              "connector, short tracks), p.9 Fig.18 (100 nF on VBUS)",
    "LED_red": "C2286.pdf (KT-0603R) p.3 (IF max 25 mA, VF 1.8-2.4 V at 20 mA, VR 5 V), "
               "p.4 (VF bins 1.9-2.0 V)",
    "LED_white": "C2290.pdf (KT-0603W) p.3 (IF max 30 mA, VF 2.6-3.1 V at 5 mA)",
    "D4148": "C81598.pdf (1N4148W) p.1 (PINNING: 1 cathode, 2 anode; VR 75 V, IF(AV) 150 mA, "
             "VF <= 0.715 V at 1 mA)",
    "TACT": "C318884.pdf (TS-1187A) p.1 (circuit diagram: A-B and C-D joined internally, contact "
            "between the two pairs; 50 mA 12 VDC)",
    "SLIDE": "C221660.pdf (C&K JS series) p.1 (contact rating 6 VDC at 0.3 A), p.4 (JS102011SAQN "
             "SPDT circuit diagram: C = common = centre terminal 2)",
    "JST": "C295747.pdf (JST PH) p.1 (2 A rating; 'Circuit No.1' marking on the SM4 footprint)",
    "EC11": "C470754.pdf (Alps EC11) p.1 (rating 10 mA 5 V DC; A/B two-phase output), "
            "p.3 (terminals A C B, C common; separate push-switch terminals)",
    "HOTSWAP": "C2803348.pdf (Kailh hotswap socket; replaced by C41430893, HanElectricity CPG151101S11-16, same drawing): two terminals, no polarity",
    "BOOT": "reference/bluemicro_nrf52840_board.h (LED_PRIMARY_PIN P1.04, LED_SECONDARY_PIN P1.10, "
            "LED_STATE_ON 1, BUTTON_DFU P0.18 = RESET, BUTTON_DFU_OTA P1.01 not on the module)",
    "NETLIST": "netlist structure (no datasheet needed)",
}

# ----------------------------------------------------------------------------
# E73-2G4M08S1C pin table (E73 datasheet p.7).  pin -> (function, nRF52840 aQFN73 ball)
# The ball names were cross-checked with nrf52840_ps_a.pdf 7.1 p.575-578.
# ----------------------------------------------------------------------------
E73_PINS = {
    1: ("P1.11", "B19"), 2: ("P1.10", "A20"), 3: ("P0.03/AIN1", "B13"), 4: ("P0.28/AIN4", "B11"),
    5: ("GND", "-"), 6: ("P1.13", "A16"), 7: ("P0.02/AIN0", "A12"), 8: ("P0.29/AIN5", "A10"),
    9: ("P0.31/AIN7", "A8"), 10: ("P0.30/AIN6", "B9"), 11: ("P0.00/XL1", "D2"), 12: ("P0.26", "G1"),
    13: ("P0.01/XL2", "F2"), 14: ("P0.06", "L1"), 15: ("P0.05/AIN3", "K2"), 16: ("P0.08", "N1"),
    17: ("P1.09", "R1"), 18: ("P0.04/AIN2", "J1"), 19: ("VDD", "-"), 20: ("P0.12", "U1"),
    21: ("GND", "-"), 22: ("P0.07", "M2"), 23: ("VDDH", "-"), 24: ("GND", "-"), 25: ("DCCH", "AB2"),
    26: ("P0.18/RESET", "AC13"), 27: ("VBUS", "AD2"), 28: ("P0.15", "AD10"), 29: ("D-", "AD4"),
    30: ("P0.17", "AD12"), 31: ("D+", "AD6"), 32: ("P0.20", "AD16"), 33: ("P0.13", "AD8"),
    34: ("P0.22", "AD18"), 35: ("P0.24", "AD20"), 36: ("P1.00", "AD22"), 37: ("SWDIO", "AC24"),
    38: ("P1.02", "-"), 39: ("SWDCLK", "AA24"), 40: ("P1.04", "U24"), 41: ("P0.09/NFC1", "L24"),
    42: ("P1.06", "R24"), 43: ("P0.10/NFC2", "J24"),
}
E73_GND = (5, 21, 24)
E73_VDD, E73_VDDH, E73_DCCH, E73_RESET, E73_VBUS = 19, 23, 25, 26, 27
E73_DN, E73_DP, E73_SWDIO, E73_SWDCLK = 29, 31, 37, 39
E73_XL1, E73_XL2, E73_NFC1, E73_NFC2 = 11, 13, 41, 43
E73_FIXED = set(E73_GND) | {E73_VDD, E73_VDDH, E73_DCCH, E73_VBUS, E73_DN, E73_DP, E73_SWDIO, E73_SWDCLK}
# Every pin that can be a GPIO (XL1/XL2, NFC and RESET included: they are P0.xx pins too)
E73_GPIO = {p for p in E73_PINS if p not in E73_FIXED}
E73_AIN = {p for p, (n, _) in E73_PINS.items() if "/AIN" in n}
E73_P1_04, E73_P1_10 = 40, 2  # bootloader LED pins


def e73_pin_by_name(name):
    """'P0_05' / 'P0.05' / 'P1.04' -> module pin number, or None."""
    n = name.strip().upper().replace("_", ".")
    for pin, (fn, _) in E73_PINS.items():
        if fn.split("/")[0].upper() == n:
            return pin
    return None


# Other fixed pinouts (datasheets)
USBC_ROLE = {"A1": "GND", "A4": "VBUS", "A5": "CC1", "A6": "D+", "A7": "D-", "A8": "SBU", "A9": "VBUS",
             "A12": "GND", "B1": "GND", "B4": "VBUS", "B5": "CC2", "B6": "D+", "B7": "D-", "B8": "SBU",
             "B9": "VBUS", "B12": "GND"}
USBLC6_ROLE = {"1": "IO1", "2": "GND", "3": "IO2", "4": "IO2", "5": "VBUS", "6": "IO1"}
AP2112_ROLE = {"1": "VIN", "2": "GND", "3": "EN", "4": "NC", "5": "VOUT"}
# the 3.3 V regulators: both SOT-23-5 with the same functions per pin (AP2112K names them VIN/VOUT, the TPS7A02
# IN/OUT); input range, enable threshold, capacitors and output accuracy per datasheet
LDO_MODELS = {
    "AP2112K": dict(names=AP2112_ROLE, vin=(2.5, 6.0), abs_max=6.5, en_hi=1.5, cout_max=None, acc=0.015,
                    src="AP_pins", iq="55 uA"),
    "TPS7A02": dict(names={"1": "IN", "2": "GND", "3": "EN", "4": "NC", "5": "OUT"}, vin=(1.5, 6.0), abs_max=6.5,
                    en_hi=1.1, cout_max=22e-6, acc=0.015, src="TPS_ldo", iq="25 nA"),
}
E73_INTERNAL_VDD_CAP = 9.7e-6  # inside the module on VDD / VDDH: 4.7 + 4.7 uF + 3 x 100 nF (Ebyte datasheet p.7)


def ldo_model(nl, ref):
    vu, lcsc = nl.value(ref).upper(), (nl.parts[ref].get("lcsc") or "").upper()
    return "TPS7A02" if ("TPS7A02" in vu or lcsc == "C2887324") else "AP2112K"


def ldo_vout(nl, ref):
    """Nominal output voltage from the part's value (AP2112K-3.3, TPS7A0233), None if unreadable."""
    vu = nl.value(ref).upper()
    m = re.search(r"-(\d)\.(\d)\b", vu) or re.search(r"TPS7A02(\d)(\d)", vu)
    return float("%s.%s" % m.groups()) if m else None
SOT23_PMOS_ROLE = {"1": "G", "2": "S", "3": "D"}

# Single-cell Li-ion chargers in SOT-23-5.  Both models put the same functions on the same pins
# (TP4054: C32574.pdf p.6; MCP73831: MCP73831_C424093.pdf p.1 / p.11 Table 3-1); the roles are generic,
# "aliases" are the names each datasheet (or a KiCad symbol) uses for the pin.
CHARGER_ROLE = {"1": "STAT", "2": "GND", "3": "BAT", "4": "VDD", "5": "PROG"}
CHARGER_ALIASES = {"STAT": {"STAT", "CHRG", "/CHRG", "STAT1"}, "GND": {"GND", "VSS"},
                   "BAT": {"BAT", "BATT", "VBAT"}, "VDD": {"VDD", "VCC", "VIN"}, "PROG": {"PROG"}}
CHARGER_MODELS = {
    # model: STAT output type, VOL typ at the LED current, sink / source limits (mA), VDD bypass minimum,
    #        VBAT capacitor minimum (None = only recommended), source key
    "TP4054": {"stat": "open-drain", "vol": 0.3, "sink_mA": 10.0, "source_mA": 0.0, "vdd_cap": 1e-6,
               "vbat_cap": None, "src": "TP_chrg", "lcsc": "C32574"},
    "MCP73831": {"stat": "tri-state", "vol": 0.4, "sink_mA": 25.0, "source_mA": 35.0, "voh_drop": 0.4,
                 "vdd_cap": 4.7e-6, "vbat_cap": 4.7e-6, "src": "MCP_stat", "lcsc": "C424093"},
    "MCP73832": {"stat": "open-drain", "vol": 0.4, "sink_mA": 25.0, "source_mA": 0.0,
                 "vdd_cap": 4.7e-6, "vbat_cap": 4.7e-6, "src": "MCP_stat", "lcsc": ""},
}
# MCP7383X-n regulation voltage (MCP73831_C424093.pdf p.3 / p.26) and the option-AC thresholds (p.26)
MCP_VREG = {"2": 4.20, "3": 4.35, "4": 4.40, "5": 4.50}
MCP_OPT_AC = {"ipreg": 0.10, "vpth": 0.665, "vpth_min": 0.64, "iterm": 0.075, "vrth": 0.965}
MCP_LCSC_PART = {"C424093": "MCP73831T-2ACI/OT"}   # PARTS.txt
MCP_THETA_JA = 230.0          # SOT-23-5, C/W (p.5)
MCP_RPROG = (2e3, 67e3)       # charge-current range (p.4)
MCP_ZNOBAT = 7e6              # minimum VBAT impedance for battery-insertion detection (p.4, p.13)
MCP_IDET_MIN = 0.6e-6         # minimum battery detection current (p.4, p.13)

# WCH CH334P QFN-16 (CH334_C5373042-p2-pinout.png); the exposed pad is "pin 0" in the drawing.
CH334P_PINS = {"1": "XO", "2": "XI", "3": "DM4", "4": "DP4", "5": "DM3", "6": "DP3", "7": "DM2", "8": "DP2",
               "9": "DM1", "10": "DP1", "11": "DMU", "12": "DPU", "13": "RESET#/CDP", "14": "PGANG",
               "15": "V5", "16": "VDD33"}
# C-Media CM108B LQFP-48 (CM108B_datasheet_v1.41.pdf p.6-8)
CM108B_PINS = {"1": "SPDIFO", "2": "DR", "3": "DW", "4": "SK", "5": "CS", "6": "MUTER", "7": "PWRSEL",
               "8": "DREG18", "9": "DREG33", "10": "MODE", "11": "NC", "12": "LEDO", "13": "GPIO3",
               "14": "DVSS", "15": "GPIO4", "16": "SDIN", "17": "ADSCLK", "18": "MUTEP", "19": "ADLRCK",
               "20": "ADMCLK", "21": "LEDR", "22": "ADSEL", "23": "TEST", "24": "AVSS", "25": "VBIAS",
               "26": "VREF", "27": "MICIN", "28": "NC", "29": "AVDD", "30": "LOL", "31": "LOBS", "32": "LOR",
               "33": "AVSS", "34": "AVDD", "35": "DVDD", "36": "DVSS", "37": "AREG36", "38": "MSEL",
               "39": "VOLUP", "40": "PDSW", "41": "USBDP", "42": "USBDM", "43": "GPIO1", "44": "SDOUT",
               "45": "DAMCLK", "46": "DALRCK", "47": "DASCLK", "48": "VOLDN"}
CM108B_FLOAT_OK = {  # pins that may stay open: internal pull-up / pull-down or outputs (p.7-8), N.C.
    "SPDIFO", "DR", "DW", "SK", "CS", "MUTER", "PWRSEL", "MODE", "NC", "LEDO", "GPIO3", "GPIO4", "SDIN",
    "ADSCLK", "MUTEP", "ADLRCK", "ADMCLK", "LEDR", "ADSEL", "TEST", "MSEL", "VOLUP", "PDSW", "GPIO1",
    "SDOUT", "DAMCLK", "DALRCK", "DASCLK", "VOLDN"}
CM108B_JUMPERS = {"PWRSEL": "PU", "MODE": "PD", "MSEL": "PU", "ADSEL": "PD", "TEST": "PD"}
# TI TPA6132A2 RTE (TPA6132A2_C69901.pdf p.3); thermal pad separate
TPA6132_PINS = {"1": "INL-", "2": "INL+", "3": "INR+", "4": "INR-", "5": "OUTR", "6": "G0", "7": "G1",
                "8": "HPVSS", "9": "CPN", "10": "PGND", "11": "CPP", "12": "HPVDD", "13": "EN", "14": "VDD",
                "15": "SGND", "16": "OUTL"}
TPA_RIN = {"-6": 26.4e3, "0": 19.8e3, "3": 16.5e3, "6": 13.2e3}   # p.5, per input pin
TPA_GAIN = {(0, 0): "-6", (1, 0): "0", (0, 1): "3", (1, 1): "6"}  # (G0, G1) -> dB, p.13
# TI TPS22919 DCK (TPS22919_C2149796.pdf p.3)
TPS22919_PINS = {"1": "IN", "2": "GND", "3": "ON", "4": "NC", "5": "QOD", "6": "VOUT"}
TPS_RQOD = 24.0               # internal quick-output-discharge resistance (p.5)
TPS_SR = 3.2e3                # turn-on slew rate at VIN = 5 V, V/s (p.5)
# Hroparts PJ-320D-4A: contact per drawing pin number and per KiCad footprint pad name (see SRC["JACK"])
JACK_CONTACT = {"1": "sleeve", "2": "tip", "3": "ring1", "4": "ring2",
                "S": "sleeve", "T": "tip", "R1": "ring1", "R2": "ring2"}
JACK_CTIA = {"tip": "left", "ring1": "right", "ring2": "ground", "sleeve": "mic"}

# Nominal / maximum voltages used for current and level estimates
V_VBUS_NOM, V_VBUS_MAX = 5.0, 5.5          # USB
V_VBAT_MAX = 4.2                           # 4.2 V Li-ion float voltage (TP4054 / MCP73831-2)
V_VDD = 3.3                                # AP2112K-3.3
V_SCHOTTKY = 0.35                          # B5819W at ~100 mA (VF 0.6 V at 1 A)
SAADC_CSAMPLE = 2.5e-12                    # nrf52840 PS p.397, at maximum gain (the largest value)
SAADC_FS_1_6 = 3.6                         # gain 1/6 with the 0.6 V internal reference (PS p.379)
SAADC_TACQ = [(10e3, 3), (40e3, 5), (100e3, 10), (200e3, 15), (400e3, 20), (800e3, 40)]   # Table 95
LED_DATA = {  # key -> (Vf typical, Vf min, IF max mA, source)
    "C2286": (2.0, 1.8, 25.0, "LED_red"),
    "C2290": (2.85, 2.6, 30.0, "LED_white"),
}
CRYSTAL_FC135 = {"CL": 12.5e-12, "ESR": 70e3, "C0": 1e-12, "drive": 0.5e-6}
NRF_LFXO = {"CL": 12.5e-12, "ESR_max": 100e3, "C0_max": 2e-12, "drive_max": 0.5e-6, "Cpin": 4e-12}


# ----------------------------------------------------------------------------
# Value parsing
# ----------------------------------------------------------------------------
_SI = {"p": 1e-12, "n": 1e-9, "u": 1e-6, "µ": 1e-6, "m": 1e-3, "k": 1e3, "K": 1e3, "M": 1e6,
       "R": 1.0, "r": 1.0, "": 1.0}


def parse_number(text, unit):
    """Parse '10k', '5k1', '4R7', '806k', '2M', '10uF', '22pF', '1nF'.  unit: 'R' or 'F'."""
    if text is None:
        return None
    s = text.strip()
    m = re.fullmatch(r"(\d+)([pnuµmkKMRr])(\d+)", s)
    if m:
        return (float(m.group(1)) + float(m.group(3)) / 10 ** len(m.group(3))) * _SI[m.group(2)]
    m = re.fullmatch(r"(\d+(?:[.,]\d+)?)\s*([pnuµmkKM]?)\s*(?:F|f|Ω|[Oo]hms?|R)?", s)
    if m:
        mult = m.group(2)
        if unit == "R" and mult == "m":
            return None  # milliohm resistors are not plausible here; refuse to guess
        return float(m.group(1).replace(",", ".")) * _SI[mult]
    return None


def fmt_r(r):
    if r is None:
        return "?"
    if r >= 1e6:
        return "%gM" % (r / 1e6)
    if r >= 1e3:
        return "%gk" % (r / 1e3)
    return "%g" % r


def fmt_c(c):
    if c is None:
        return "?"
    if c >= 1e-6:
        return "%guF" % (c / 1e-6)
    if c >= 1e-9:
        return "%gnF" % (c / 1e-9)
    return "%gpF" % (c / 1e-12)


# ----------------------------------------------------------------------------
# Part classification (never by reference designator)
# ----------------------------------------------------------------------------
def charger_model(p):
    """'TP4054' / 'MCP73831' / 'MCP73832' from LCSC code or value (never from a free-text note), else None."""
    vu = (p.get("value") or "").upper()
    lcsc = (p.get("lcsc") or "").upper()
    if "TP4054" in vu or lcsc == "C32574":
        return "TP4054"
    if lcsc in MCP_LCSC_PART or "MCP73831" in vu:
        return "MCP73831"
    if "MCP73832" in vu:
        return "MCP73832"
    return None


def mcp_vreg(p):
    """Regulation voltage of an MCP7383X from its LCSC code or ordering code in value/note, else None."""
    lcsc = (p.get("lcsc") or "").upper()
    txt = MCP_LCSC_PART.get(lcsc, "") + " " + (p.get("value") or "") + " " + (p.get("note") or "")
    m = re.search(r"MCP7383[12]T?-(\d)", txt.upper())
    return MCP_VREG.get(m.group(1)) if m else None


def norm_pin_name(s):
    """Pin-name comparison key: case, spaces, dots, underscores and '#' ignored ('N.C.' == 'NC')."""
    return re.sub(r"[\s._#~]", "", (s or "").upper())


def classify(p):
    v = (p.get("value") or "")
    vu = v.upper()
    fp = (p.get("footprint") or "").upper()
    lcsc = (p.get("lcsc") or "").upper()
    pins = p.get("pins", {})
    pin_names = {str(k): (d.get("name") or "").upper() for k, d in pins.items()}
    n = len(pins)
    if lcsc == "C356849" or "E73-2G4M08S1C" in vu or ("E73" in fp and n >= 40):
        return "module"
    if lcsc == "C165948" or "TYPE-C" in fp or "USB_C" in fp or "USB-C" in fp or "USB-C" in vu \
            or ("A5" in pins and "B5" in pins and "A4" in pins):
        return "usbc"
    if "USBLC6" in vu or lcsc == "C7519":
        return "esd"
    if charger_model(p):
        return "charger"
    if lcsc == "C5373042" or re.search(r"\bCH33[45]", vu):
        return "hub"
    if lcsc == "C371347" or re.search(r"CM10[89]B?|CM119", vu):
        return "codec"
    if lcsc == "C69901" or "TPA6132" in vu:
        return "hpamp"
    if lcsc == "C2149796" or "TPS22919" in vu:
        return "loadsw"
    if lcsc == "C95562" or "PJ-320D" in vu or "PJ-320D" in fp:
        return "jack"
    if "AP2112" in vu or lcsc == "C51118" or "TPS7A02" in vu or lcsc == "C2887324":
        return "ldo"
    if lcsc == "C8545" or re.search(r"2N7002|BSS138", vu):
        return "nmos"
    if lcsc == "C193402" or re.search(r"^SM[FAB]J?\d", vu):
        return "tvs"
    if lcsc == "C10487" or re.search(r"SI2301|AO3407|AO3401|DMG2301|DMG3415", vu):
        return "pmos"
    if lcsc == "C8598" or re.search(r"B58(17|18|19)W|1N5819|SS1[24]|MBR0520", vu):
        return "schottky"
    if lcsc == "C81598" or "1N4148" in vu:
        return "mdiode"
    if lcsc == "C32346" or "CRYSTAL" in fp or re.search(r"32[.,]?768", vu):
        return "xtal"
    if lcsc in ("C2286", "C2290", "C72043", "C72041") or "LED" in fp or "LED" in vu \
            or vu.startswith("KT-0603") or vu.startswith("19-217"):
        return "led"
    if lcsc in ("C2803348", "C41430893", "C49352235") or "HOTSWAP" in fp or "SWITCH_KEYBOARD" in fp:
        return "key"
    if lcsc == "C470754" or "EC11" in vu or "ROTARYENCODER" in fp:
        return "enc"
    if lcsc == "C221660" or "JS102011" in vu or "SW_SPDT" in fp:
        return "slide"
    if lcsc == "C318884" or "SW-SMD_4P" in fp or "SW_PUSH" in fp or "TACT" in fp or "TS-1187" in vu \
            or (vu == "RESET" and n == 4):
        return "tact"
    if "JUMPER" in fp or "SOLDERJUMPER" in vu or "JUMPER" in vu:
        return "jumper"
    if "TESTPOINT" in fp or "TESTPOINT" in vu or "TEST_POINT" in fp:
        return "tp"
    if re.search(r"RESISTOR|(^|:)R_\d{4}", fp) or (n == 2 and not fp and parse_number(v, "R") is not None
                                                   and not re.search(r"F$", v)):
        return "res"
    if re.search(r"CAPACITOR|(^|:)C_\d{4}", fp) or re.fullmatch(r"\d+(?:[.,]\d+)?\s*[pnuµ]F?", v):
        return "cap"
    if re.search(r"INDUCTOR|(^|:)L_\d{4}", fp):
        return "ind"
    if lcsc == "C295747" or "JST" in fp or "BATTERY" in vu or "CONN" in vu or "PINHEADER" in fp \
            or "CONNECTOR" in fp or "PRO_MICRO" in fp or "PROMICRO" in vu:
        return "conn"
    return "other"


def led_params(p):
    """(Vf typ, Vf min, IF max, source) for a LED part; generic assumption when unknown."""
    lcsc = (p.get("lcsc") or "").upper()
    vu = (p.get("value") or "").upper()
    if lcsc in LED_DATA:
        return LED_DATA[lcsc] + (False,)
    if "KT-0603R" in vu or "RED" in vu:
        return LED_DATA["C2286"] + (True,)
    if "KT-0603W" in vu or "WHITE" in vu:
        return LED_DATA["C2290"] + (True,)
    if "BHC" in vu or "BLUE" in vu:
        return (2.8, 2.5, 20.0, "LED_white", True)   # blue: assumed similar to white
    if "GHC" in vu or "GREEN" in vu:
        return (2.1, 1.8, 20.0, "LED_red", True)     # green: assumed ~2.1 V
    return (2.0, 1.8, 20.0, "LED_red", True)


# ----------------------------------------------------------------------------
# Netlist model
# ----------------------------------------------------------------------------
class Netlist:
    def __init__(self, data):
        self.data = data
        self.parts = data["parts"]
        self.nets = data["nets"]
        self.kind = {ref: classify(p) for ref, p in self.parts.items()}
        self.members = defaultdict(list)       # net -> [(ref, pin)] fitted parts only
        self.members_all = defaultdict(list)   # including DNP parts
        for ref, p in self.parts.items():
            for pin, pd in p["pins"].items():
                net = pd.get("net")
                if net is None:
                    continue
                self.members_all[net].append((ref, str(pin)))
                if not p.get("dnp"):
                    self.members[net].append((ref, str(pin)))
        self.module = self.first("module")
        self.labels = {}
        self._roles()

    # --- basic access ------------------------------------------------------
    def refs(self, kind):
        return [r for r, k in self.kind.items() if k == kind]

    def first(self, kind):
        lst = self.refs(kind)
        return lst[0] if lst else None

    def dnp(self, ref):
        return bool(self.parts[ref].get("dnp"))

    def value(self, ref):
        return self.parts[ref].get("value") or ""

    def net(self, ref, pin):
        pd = self.parts[ref]["pins"].get(str(pin))
        return pd.get("net") if pd else None

    def pin_name(self, ref, pin):
        pd = self.parts[ref]["pins"].get(str(pin))
        return (pd.get("name") or "") if pd else ""

    def pins_of(self, ref):
        return list(self.parts[ref]["pins"].keys())

    def modpin(self, pin):
        return self.net(self.module, pin) if self.module else None

    def desc(self, ref):
        p = self.parts[ref]
        return "%s (%s%s)" % (ref, p.get("value") or "?", ", DNP" if p.get("dnp") else "")

    def label(self, net):
        if net is None:
            return "<unconnected>"
        role = self.labels.get(net)
        return "%s[=%s]" % (net, role) if role and role != net else net

    def mems(self, net, exclude=None):
        return [(r, p) for r, p in self.members.get(net, []) if r != exclude]

    def module_pins_on(self, net):
        if not self.module:
            return []
        return [int(p) for r, p in self.members.get(net, []) if r == self.module]

    def pin_by_role(self, ref, roles, want):
        """pin number of part ref whose datasheet role is `want` (roles: pin -> role)."""
        for pin, role in roles.items():
            if role == want and pin in self.parts[ref]["pins"]:
                return pin
        return None

    def other_end(self, ref, pin):
        """For a 2-pin part: (other pin, other net)."""
        pins = self.pins_of(ref)
        if len(pins) != 2:
            return None, None
        o = pins[0] if pins[1] == str(pin) else pins[1]
        return o, self.net(ref, o)

    def two_pin_parts_on(self, net, kinds, exclude=None):
        """[(ref, pin, other_net)] for fitted 2-pin parts of the given kinds touching `net`."""
        out = []
        for ref, pin in self.members.get(net, []):
            if ref == exclude or self.kind[ref] not in kinds or len(self.pins_of(ref)) != 2:
                continue
            o, onet = self.other_end(ref, pin)
            out.append((ref, pin, onet))
        return out

    def resistors_between(self, a, b):
        return [(ref, parse_number(self.value(ref), "R"))
                for ref, pin, onet in self.two_pin_parts_on(a, ("res",)) if onet == b]

    def caps_between(self, a, b):
        return [(ref, parse_number(self.value(ref), "F"))
                for ref, pin, onet in self.two_pin_parts_on(a, ("cap",)) if onet == b]

    # --- diode / LED polarity helpers ----------------------------------------
    def diode_ak(self, ref):
        """(anode pin, cathode pin, assumed) using pin names K/A, else SOD-123/LED convention 1=K 2=A."""
        pins = self.pins_of(ref)
        names = {p: self.pin_name(ref, p).upper() for p in pins}
        a = [p for p, n in names.items() if n in ("A", "ANODE", "+")]
        k = [p for p, n in names.items() if n in ("K", "C", "CATHODE", "-")]
        if len(a) == 1 and len(k) == 1:
            return a[0], k[0], False
        if "1" in pins and "2" in pins:
            return "2", "1", True
        return None, None, True

    # --- role nets -----------------------------------------------------------
    def _roles(self):
        self.gnd = self.vbus = self.vdd = self.vddh = None
        self.vin = self.vbat = self.batp = None
        self.batin = self.revfet = None  # the connector's + before a reverse-battery P-MOSFET, and that FET
        self.revfet_swapped = False  # that FET fitted with source and drain the wrong way round
        self.ldo_main = None
        u = self.first("usbc")
        if self.module:
            self.gnd = self.modpin(E73_GND[0])
            self.vbus = self.modpin(E73_VBUS)
            self.vdd = self.modpin(E73_VDD)
            self.vddh = self.modpin(E73_VDDH)
        # the receptacle defines VBUS and GND when present (the module pins are then checked against it)
        if u:
            vbus_pads = [p for p, r in USBC_ROLE.items() if r == "VBUS" and p in self.parts[u]["pins"]]
            gnd_pads = [p for p, r in USBC_ROLE.items() if r == "GND" and p in self.parts[u]["pins"]]
            if vbus_pads and self.net(u, vbus_pads[0]) is not None:
                self.vbus = self.net(u, vbus_pads[0])
            if gnd_pads and self.net(u, gnd_pads[0]) is not None and self.gnd is None:
                self.gnd = self.net(u, gnd_pads[0])
        for ldo in self.refs("ldo"):
            if self.net(ldo, "5") == self.vdd and self.vdd is not None:
                self.ldo_main = ldo
                self.vin = self.net(ldo, "1")
        # charger (TP4054 or MCP73831/2: same SOT-23-5 functions, BAT = pin 3)
        chs = [r for r in self.refs("charger") if not self.dnp(r)]
        self.charger = chs[0] if chs else None
        self.chg_model = charger_model(self.parts[self.charger]) if self.charger else None
        if self.charger:
            self.vbat = self.net(self.charger, self.pin_by_role(self.charger, CHARGER_ROLE, "BAT"))
        # switched audio rail: output of a TPS22919 whose input is VBUS
        self.vaud = None
        for sw in self.refs("loadsw"):
            if not self.dnp(sw) and self.net(sw, "1") == self.vbus and self.vbus is not None \
                    and self.net(sw, "6") not in (None, self.vbus, self.gnd):
                self.vaud = self.net(sw, "6")
                break
        # battery connector: 2 signal pins, one on GND; the other one is BAT+
        self.batconn = None
        for ref in self.refs("conn"):
            sig = [p for p in self.pins_of(ref) if self.pin_name(ref, p).upper() not in ("MP", "SHIELD", "S1")
                   and not p.upper().startswith("MP")]
            if len(sig) != 2:
                continue
            nets = [self.net(ref, p) for p in sig]
            if self.gnd in nets and any(n and n != self.gnd for n in nets):
                other = [n for n in nets if n != self.gnd][0]
                if other == self.vbat or self._reaches_vbat(other):
                    self.batconn = ref
                    self.batp = other
                    break
                # a reverse-battery P-MOSFET between the connector and the rest: drain on the connector, gate on
                # GND, source on the battery side (BAT+)
                for q in self.refs("pmos"):
                    g, s, dr = self.net(q, "1"), self.net(q, "2"), self.net(q, "3")
                    for conn_side, load in ((dr, s), (s, dr)):  # (the second: fitted the wrong way round)
                        if conn_side == other and load and (load == self.vbat or self._reaches_vbat(load)):
                            self.batconn, self.batin, self.revfet, self.batp = ref, other, q, load
                            self.revfet_swapped = conn_side == s
                            break
                    if self.batconn:
                        break
                if self.batconn:
                    break
        for net, role in ((self.gnd, "GND"), (self.vbus, "VBUS"), (self.vdd, "VDD"), (self.vin, "VIN"),
                          (self.vbat, "VBAT"), (self.batp, "BAT+"), (self.batin, "BAT_IN"), (self.vaud, "VAUD")):
            if net is not None and net not in self.labels:
                self.labels[net] = role

    def _reaches_vbat(self, net):
        """True if `net` is tied to VBAT through a slide switch or a jumper (power switch in series)."""
        if self.vbat is None:
            return False
        for ref, pin in self.members_all.get(net, []):
            if self.kind[ref] in ("slide", "jumper"):
                for p in self.pins_of(ref):
                    if self.net(ref, p) == self.vbat:
                        return True
        return False

    def power_nets(self):
        return {n: r for n, r in ((self.gnd, "GND"), (self.vbus, "VBUS"), (self.vdd, "VDD"),
                                  (self.vin, "VIN"), (self.vbat, "VBAT"), (self.batp, "BAT+"),
                                  (self.batin, "BAT_IN"), (self.vaud, "VAUD")) if n}

    # --- helpers for the IC checks ---------------------------------------------
    def fitted(self, kind):
        return [r for r in self.refs(kind) if not self.dnp(r)]

    def extra_pins(self, ref, table):
        """Pins of `ref` that are not in the datasheet pin table (exposed pad, mounting pads)."""
        return [p for p in self.pins_of(ref) if p not in table]

    def name_mismatches(self, ref, table, aliases=None):
        """['pin p named X, datasheet Y', ...] for named pins that disagree with the datasheet table."""
        out = []
        aliases = aliases or {}
        for p, want in table.items():
            if p not in self.parts[ref]["pins"]:
                out.append("pin %s missing from the symbol (datasheet: %s)" % (p, want))
                continue
            got = self.pin_name(ref, p)
            if not got or got in ("~",):
                continue
            ok = {norm_pin_name(want)} | {norm_pin_name(a) for a in aliases.get(want, ())}
            if norm_pin_name(got) not in ok:
                out.append("pin %s is named '%s' in the netlist but the datasheet has %s" % (p, got, want))
        return out

    def cap_list(self, net, other=None):
        """[(ref, farad)] capacitors from `net` to `other` (default GND)."""
        if net is None:
            return []
        return self.caps_between(net, self.gnd if other is None else other)

    def cap_total(self, net, other=None):
        return sum(c for _, c in self.cap_list(net, other) if c)

    def non_cap_members(self, net, exclude=()):
        """Members of `net` other than capacitors to GND and the parts in `exclude`."""
        out = []
        for r, p in self.mems(net):
            if r in exclude:
                continue
            if self.kind[r] == "cap" and len(self.pins_of(r)) == 2 and self.other_end(r, p)[1] == self.gnd:
                continue
            out.append((r, p))
        return out

    def through_series(self, net, kinds=("ind",), max_ohm=None, depth=2, exclude=(), no_enter=()):
        """Nets reachable from `net` through 2-pin parts of `kinds` (resistors only if <= max_ohm), never
        entering the nets in `no_enter`: {net: [refs on the way]} including `net` itself."""
        seen = {net: []}
        frontier = [net]
        for _ in range(depth):
            nxt = []
            for n in frontier:
                for ref, pin, onet in self.two_pin_parts_on(n, kinds):
                    if ref in exclude or onet is None or onet in seen or onet in no_enter:
                        continue
                    if self.kind[ref] == "res" and max_ohm is not None:
                        v = parse_number(self.value(ref), "R")
                        if v is None or v > max_ohm:
                            continue
                    seen[onet] = seen[n] + [ref]
                    nxt.append(onet)
            frontier = nxt
        return seen

    def resistance_to_rails(self, start, rails, skip_kinds=()):
        """DC resistance from `start` to the set of `rails` (all at 0 V) through resistors only
        (nodal analysis on the resistor network reachable from `start`).  Returns (ohms or None if no
        path, [resistor refs used])."""
        nodes, used, q = {start}, set(), [start]
        while q:
            n = q.pop()
            if n in rails:
                continue
            for ref, pin, onet in self.two_pin_parts_on(n, ("res",)):
                if onet is None or self.kind[ref] in skip_kinds:
                    continue
                if parse_number(self.value(ref), "R") is None:
                    continue
                used.add(ref)
                if onet not in nodes:
                    nodes.add(onet)
                    q.append(onet)
        if not (nodes & set(rails)):
            return None, sorted(used)
        inner = sorted(n for n in nodes if n not in rails and n != start)
        idx = {n: i for i, n in enumerate(inner)}
        size = len(inner)
        a = [[0.0] * (size + 1) for _ in range(size)]   # G * v = b, start held at 1 V, rails at 0 V
        for ref in used:
            p1, p2 = self.pins_of(ref)
            n1, n2 = self.net(ref, p1), self.net(ref, p2)
            g = 1.0 / parse_number(self.value(ref), "R")
            for x, y in ((n1, n2), (n2, n1)):
                if x in idx:
                    a[idx[x]][idx[x]] += g
                    if y in idx:
                        a[idx[x]][idx[y]] -= g
                    elif y == start:
                        a[idx[x]][size] += g * 1.0
        for i in range(size):                            # Gaussian elimination
            piv = max(range(i, size), key=lambda r: abs(a[r][i]))
            a[i], a[piv] = a[piv], a[i]
            if abs(a[i][i]) < 1e-30:
                continue
            for r in range(size):
                if r != i and a[r][i]:
                    f = a[r][i] / a[i][i]
                    a[r] = [x - f * y for x, y in zip(a[r], a[i])]
        v = {n: (a[idx[n]][size] / a[idx[n]][idx[n]] if abs(a[idx[n]][idx[n]]) > 1e-30 else 0.0) for n in inner}
        v[start] = 1.0
        current = 0.0
        for ref in used:
            p1, p2 = self.pins_of(ref)
            n1, n2 = self.net(ref, p1), self.net(ref, p2)
            g = 1.0 / parse_number(self.value(ref), "R")
            if n1 == start and n2 != start:
                current += g * (1.0 - v.get(n2, 0.0))
            elif n2 == start and n1 != start:
                current += g * (1.0 - v.get(n1, 0.0))
        return (1.0 / current if current > 0 else None), sorted(used)

    def net_voltage_max(self, net):
        """Worst-case (highest) DC voltage on a power net, None if not a power net."""
        if net is None:
            return None
        if net == self.gnd:
            return 0.0
        if net in (self.vbus, self.vaud):
            return V_VBUS_MAX
        if net == self.vin:
            return V_VBUS_MAX - 0.3
        if net in (self.vbat, self.batp, self.batin):
            return V_VBAT_MAX
        if net == self.vdd:
            return V_VDD
        return None

    def net_voltage_nom(self, net):
        if net is None:
            return None
        if net == self.gnd:
            return 0.0
        if net in (self.vbus, self.vaud):
            return V_VBUS_NOM
        if net == self.vin:
            return V_VBUS_NOM - V_SCHOTTKY
        if net in (self.vbat, self.batp, self.batin):
            return 3.8
        if net == self.vdd:
            return V_VDD
        return None


# ----------------------------------------------------------------------------
# Report
# ----------------------------------------------------------------------------
class Report:
    def __init__(self):
        self.items = []

    def add(self, code, name, status, source_key, details=None):
        src = SRC.get(source_key, source_key)
        self.items.append((code, name, status, src, list(details or [])))

    def print(self, title):
        print("=" * 100)
        print("check_circuit.py - %s" % title)
        print("=" * 100)
        for code, name, status, src, details in self.items:
            print("[%s] %s  %s" % (status, code, name))
            print("       source: %s" % src)
            for d in details:
                print("       - %s" % d)
        counts = {s: sum(1 for i in self.items if i[2] == s) for s in (PASS, FAIL, WARN, SKIP)}
        print("-" * 100)
        print("SUMMARY: %d PASS, %d FAIL, %d WARN, %d SKIP" % (counts[PASS], counts[FAIL], counts[WARN], counts[SKIP]))
        for s in (FAIL, WARN):
            lst = [i for i in self.items if i[2] == s]
            if lst:
                print("%s:" % s)
                for code, name, status, src, details in lst:
                    print("  %s %s" % (code, name))
        print()
        return counts[FAIL] == 0


# ----------------------------------------------------------------------------
# Checks
# ----------------------------------------------------------------------------
def check_consistency(nl, rep):
    """N00: parts[].pins[].net and nets{} describe the same connectivity."""
    bad = []
    seen = set()
    for net, conns in nl.nets.items():
        for ref, pin in conns:
            seen.add((ref, str(pin)))
            if ref not in nl.parts:
                bad.append("net %s lists unknown part %s" % (net, ref))
            elif nl.net(ref, pin) != net:
                bad.append("net %s lists %s.%s but that pin says net %s" % (net, ref, pin, nl.net(ref, pin)))
    for ref, p in nl.parts.items():
        for pin, pd in p["pins"].items():
            if pd.get("net") is not None and (ref, str(pin)) not in seen:
                bad.append("%s.%s says net %s but the net does not list it" % (ref, pin, pd["net"]))
            if pd.get("net") is not None and pd["net"] not in nl.nets:
                bad.append("%s.%s refers to undefined net %s" % (ref, pin, pd["net"]))
    rep.add("N00", "netlist self-consistency (parts vs nets tables)", FAIL if bad else PASS, "NETLIST",
            bad[:20] or ["%d parts, %d nets" % (len(nl.parts), len(nl.nets))])


def check_module_gnd(nl, rep):
    if not nl.module:
        rep.add("M01", "E73 ground pads", SKIP, "E73_pins", ["no E73-2G4M08S1C module found"])
        return
    nets = {p: nl.modpin(p) for p in E73_GND}
    d = ["pin %d -> %s" % (p, nl.label(n)) for p, n in nets.items()]
    ok = len(set(nets.values())) == 1 and None not in nets.values()
    if ok:
        g = nl.gnd
        u = nl.first("usbc")
        if u and nl.net(u, "A1") not in (None, g):
            ok = False
            d.append("USB-C GND pad A1 is on %s, not on the module ground net" % nl.label(nl.net(u, "A1")))
        if len(nl.mems(g)) < 5:
            ok = False
            d.append("ground net has only %d connections" % len(nl.mems(g)))
    rep.add("M01", "E73 ground pads 5/21/24 all on the single ground net", PASS if ok else FAIL, "E73_pins", d)


def check_module_supply(nl, rep):
    if not nl.module:
        rep.add("M02", "E73 VDD/VDDH supply", SKIP, "PS_supply", [])
        return
    vdd, vddh = nl.modpin(E73_VDD), nl.modpin(E73_VDDH)
    d = ["VDD (pin 19) -> %s ; VDDH (pin 23) -> %s" % (nl.label(vdd), nl.label(vddh))]
    status = PASS
    if vdd is None or vddh is None:
        status = FAIL
        d.append("VDD and VDDH must both be connected")
    elif vdd != vddh:
        # high-voltage mode: VDDH supplied, VDD must then be an output (decoupled only)
        status = WARN
        d.append("VDD and VDDH on different nets: high-voltage mode (VDDH 2.5-5.5 V, VDD becomes the REG0 "
                 "output); Lira intends normal-voltage mode, so this is unexpected")
    else:
        d.append("same net -> normal voltage mode (allowed: PS 5.3.1 'pin VDD shorted to pin VDDH'); "
                 "VDD operating range 1.7-3.6 V, abs max 3.9 V")
        ldo = nl.ldo_main
        if ldo:
            vout = ldo_vout(nl, ldo)
            if vout is None:
                status = WARN
                d.append("LDO %s feeding VDD: output voltage not recognisable from value '%s'" % (ldo, nl.value(ldo)))
            else:
                hi = vout * (1 + LDO_MODELS[ldo_model(nl, ldo)]["acc"])
                d.append("rail from %s: %.2f V +-1.5 %% -> max %.3f V (<= 3.6 V operating, < 3.9 V abs max)"
                         % (nl.desc(ldo), vout, hi))
                if hi > 3.6:
                    status = FAIL
                d.append("E73 datasheet: >= 3.3 V supply guarantees the rated output power (p.5)")
        else:
            sources = [(r, p) for r, p in nl.mems(vdd) if nl.kind[r] in ("ldo", "pmos", "conn", "jumper", "ind", "res", "other")]
            if sources:
                status = WARN
                d.append("no LDO drives the VDD net; possible sources %s - rail voltage not verified" % sources)
            else:
                status = FAIL
                d.append("the VDD net has no supply at all (only module pins, capacitors, test points)")
        # VDD rail decoupling / bulk capacitor
        caps = [c for c in nl.caps_between(vdd, nl.gnd)]
        tot = sum(c for _, c in caps if c)
        d.append("capacitance VDD-GND on the board: %s (%s)" % (fmt_c(tot) if caps else "none",
                                                                 ", ".join(r for r, _ in caps) or "-"))
        if tot < 1e-6:
            status = FAIL if status == PASS else status
            d.append("at least the LDO output capacitor (>= 1 uF) must sit on this rail")
    rep.add("M02", "E73 VDD and VDDH tied together on the 3.3 V rail (normal voltage mode)", status, "PS_supply", d)


def check_module_vbus(nl, rep):
    if not nl.module:
        rep.add("M03", "E73 VBUS pin", SKIP, "PS_usb", [])
        return
    vbus = nl.modpin(E73_VBUS)
    d = ["VBUS (pin 27) -> %s" % nl.label(vbus)]
    status = PASS
    u = nl.first("usbc")
    if vbus is None:
        status = FAIL
        d.append("VBUS must be connected to the USB 5 V for USB operation")
    elif u:
        pads = [p for p, r in USBC_ROLE.items() if r == "VBUS" and p in nl.parts[u]["pins"]]
        bad = [p for p in pads if nl.net(u, p) != vbus]
        if bad:
            status = FAIL
            d.append("USB-C VBUS pads %s are on %s, not on the module VBUS pin net (the module must see the raw "
                     "USB 5 V, 4.35-5.5 V, not the post-diode VIN or another rail)" % (bad, nl.label(nl.vbus)))
        else:
            d.append("USB-C VBUS pads %s on the same net; USB 5 V is within 4.35-5.5 V operating, 5.8 V abs max" % pads)
    # series resistor recommendation (PS 7.3 p.583)
    direct = any(r == u for r, p in nl.mems(vbus)) if u else False
    if direct:
        d.append("note: the nRF52840 reference circuits (bare chip) put an optional 4R7 series resistor between the "
                 "USB supply and the VBUS pin, 'recommended for new designs' against connection transients; "
                 "none here (the BlueMicro840 has none either) - low risk with the module's internal decoupling")
        status = WARN if status == PASS else status
    rep.add("M03", "E73 VBUS pin on the USB-C VBUS (5 V) net", status, "PS_usb", d)


def check_module_swd(nl, rep):
    if not nl.module:
        rep.add("M05", "SWDIO/SWDCLK", SKIP, "PS_swd", [])
        return
    status = PASS
    d = []
    for pin, nm in ((E73_SWDIO, "SWDIO"), (E73_SWDCLK, "SWDCLK")):
        net = nl.modpin(pin)
        if net is None:
            status = FAIL
            d.append("%s (pin %d) unconnected: no way to flash the bootloader" % (nm, pin))
            continue
        others = nl.mems(net, exclude=nl.module)
        kinds = sorted(set(nl.kind[r] for r, _ in others))
        d.append("%s (pin %d) -> %s : %s" % (nm, pin, nl.label(net), others or "nothing else"))
        if not others:
            status = FAIL
            d.append("%s has no test point / header: programming impossible" % nm)
        if any(k not in ("tp", "conn", "res") for k in kinds):
            status = FAIL
            d.append("%s is loaded by %s - only test points / debug header (and series R) allowed" % (nm, kinds))
        if net in nl.power_nets():
            status = FAIL
            d.append("%s is shorted to %s" % (nm, nl.labels[net]))
    d.append("no external pull resistors needed: SWDIO has an internal pull-up, SWDCLK an internal pull-down (13 kOhm)")
    # programmer also needs GND and VDD (target reference voltage)
    tp_nets = {nl.net(r, p) for r in nl.refs("tp") for p in nl.pins_of(r)}
    for net, nm in ((nl.gnd, "GND"), (nl.vdd, "VDD")):
        if net not in tp_nets and not any(nl.kind[r] == "conn" for r, _ in nl.mems(net)):
            status = WARN if status == PASS else status
            d.append("no test point or header on %s for the programmer" % nm)
    rep.add("M05", "SWDIO/SWDCLK reach a test point or header, nothing else on them", status, "PS_swd", d)


def check_module_reset(nl, rep):
    if not nl.module:
        rep.add("M06", "RESET pin", SKIP, "PS_reset", [])
        return
    net = nl.modpin(E73_RESET)
    d = ["P0.18/RESET (pin 26) -> %s" % nl.label(net)]
    status = PASS
    if net is None:
        status = WARN
        d.append("reset pin unconnected: no hardware reset / DFU entry (double reset) possible")
    else:
        if net in nl.power_nets():
            status = FAIL
            d.append("RESET tied to %s - the chip would be held in reset or the pin shorted" % nl.labels[net])
        others = nl.mems(net, exclude=nl.module)
        d.append("other connections: %s" % (others or "none"))
        for r, p in others:
            k = nl.kind[r]
            if k in ("tp", "conn"):
                continue
            if k == "tact":
                o = [q for q in nl.pins_of(r) if nl.net(r, q) not in (None, net)]
                onets = {nl.net(r, q) for q in o}
                if onets == {nl.gnd}:
                    d.append("%s: push button between RESET and GND (active-low reset, DFU by double tap)" % r)
                elif onets:
                    status = FAIL
                    d.append("%s: button other side on %s, must be GND" % (r, [nl.label(n) for n in onets]))
                continue
            if k == "res":
                _, onet = nl.other_end(r, p)
                if onet == nl.vdd:
                    d.append("%s: external pull-up to VDD (not required: pin has an internal pull-up when used as reset)" % r)
                else:
                    status = FAIL
                    d.append("%s resistor from RESET to %s" % (r, nl.label(onet)))
                continue
            if k == "cap":
                d.append("%s: capacitor on RESET lengthens tPINR (PS p.81) - allowed" % r)
                continue
            status = FAIL
            d.append("%s (%s) must not be connected to RESET" % (r, k))
        d.append("the bootloader maps BUTTON_DFU to P0.18 with pull-up: no external resistor required")
    rep.add("M06", "RESET pin: only button-to-GND / test point / header, never tied to a rail", status, "PS_reset", d)


def check_crystal(nl, rep):
    if not nl.module:
        rep.add("M07", "32.768 kHz crystal and load capacitors", SKIP, "PS_lfxo", [])
        return
    xl1, xl2 = nl.modpin(E73_XL1), nl.modpin(E73_XL2)
    d = ["XL1 (pin 11) -> %s ; XL2 (pin 13) -> %s" % (nl.label(xl1), nl.label(xl2))]
    # the crystal whose pins touch XL1/XL2 (other crystals, e.g. the 12 MHz USB-hub one, are checked elsewhere)
    xt = [r for r in nl.refs("xtal") if not nl.dnp(r)
          and {nl.net(r, p) for p in nl.pins_of(r)} & ({xl1, xl2} - {None})]
    if not xt or xl1 is None or xl2 is None:
        rep.add("M07", "32.768 kHz crystal and load capacitors", FAIL, "PS_lfxo",
                d + ["no crystal between XL1 and XL2 - the E73 module has no 32.768 kHz crystal inside "
                     "(E73 p.6: '32.768KHz crystal must be external'); the bootloader/firmware expect the LFXO"])
        return
    status = PASS
    y = xt[0]
    ynets = {nl.net(y, p) for p in nl.pins_of(y)}
    if ynets != {xl1, xl2}:
        status = FAIL
        d.append("%s pins on %s, expected exactly XL1 and XL2" % (y, [nl.label(n) for n in ynets]))
    else:
        d.append("%s between XL1 and XL2" % nl.desc(y))
    lcsc = (nl.parts[y].get("lcsc") or "").upper()
    if lcsc == "C32346" or "FC-135" in nl.value(y).upper():
        cl = CRYSTAL_FC135["CL"]
        d.append("crystal FC-135: CL 12.5 pF (= PS CL_LFXO 12.5 pF), ESR 70k <= 100k, C0 1 pF <= 2 pF, "
                 "drive 0.5 uW <= 0.5 uW -> all within the nRF52840 LFXO limits")
    else:
        cl = NRF_LFXO["CL"]
        status = WARN if status == PASS else status
        d.append("crystal '%s' not identified; assuming CL = 12.5 pF (PS 5.4.4.3) for the load-cap check" % nl.value(y))
    # load capacitors: C1 = C2 ~ 2*CL - Cpin - Cstray(1-2 pF)
    target = 2 * cl - NRF_LFXO["Cpin"]
    lo, hi = target - 6e-12, target + 2e-12
    vals = {}
    for net, nm in ((xl1, "XL1"), (xl2, "XL2")):
        caps = nl.caps_between(net, nl.gnd)
        extra = [(r, p) for r, p in nl.mems(net) if r not in (nl.module, y) and nl.kind[r] != "cap"]
        if extra:
            status = FAIL
            d.append("%s also connects %s - crystal pins must carry nothing else" % (nm, extra))
        if len(caps) != 1:
            status = FAIL
            d.append("%s: expected exactly one load capacitor to GND, found %s" % (nm, caps))
            continue
        ref, c = caps[0]
        vals[nm] = c
        d.append("%s load capacitor %s = %s" % (nm, ref, fmt_c(c)))
        if c is None or not (lo <= c <= hi):
            status = FAIL if status != FAIL else status
            d.append("%s: C should be about 2*CL - Cpin - Cstray = %s - stray (accepted %s..%s)"
                     % (nm, fmt_c(target), fmt_c(lo), fmt_c(hi)))
    if len(vals) == 2 and vals["XL1"] != vals["XL2"]:
        status = FAIL
        d.append("C1 and C2 must have the same value (PS p.87)")
    rep.add("M07", "32.768 kHz crystal on XL1/XL2 with matched load capacitors (2*CL - Cpin)", status, "PS_lfxo", d)


def check_nfc(nl, rep):
    if not nl.module:
        rep.add("M08", "NFC pins", SKIP, "PS_nfc", [])
        return
    status = PASS
    d = []
    for pin in (E73_NFC1, E73_NFC2):
        net = nl.modpin(pin)
        if net is None:
            d.append("pin %d %s unconnected (fine)" % (pin, E73_PINS[pin][0]))
            continue
        others = nl.mems(net, exclude=nl.module)
        d.append("pin %d %s -> %s : %s" % (pin, E73_PINS[pin][0], nl.label(net), others))
        if net in nl.power_nets():
            status = FAIL
            d.append("NFC pin tied to %s" % nl.labels[net])
        elif others:
            status = WARN if status == PASS else status
            d.append("used as GPIO: UICR NFCPINS.PROTECT must be set to 'Disabled' by the firmware/bootloader, "
                     "and the two pins have higher capacitance / mutual leakage")
    rep.add("M08", "NFC1/NFC2 (P0.09/P0.10) free, or used as GPIO with NFCPINS disabled", status, "PS_nfc", d)


def check_dcch(nl, rep):
    if not nl.module:
        rep.add("M09", "DCCH pin", SKIP, "PS_dcdc", [])
        return
    net = nl.modpin(E73_DCCH)
    d = ["DCCH (pin 25) -> %s" % nl.label(net)]
    status = PASS
    if net is not None:
        fitted = nl.mems(net, exclude=nl.module)
        allm = [(r, p) for r, p in nl.members_all.get(net, []) if r != nl.module]
        if not fitted:
            d.append("only unfitted parts on this net (%s): electrically open -> LDO-only operation" % allm)
        else:
            inds = [(r, p) for r, p in fitted if nl.kind[r] == "ind"]
            if len(fitted) == len(inds) == 1 and nl.other_end(inds[0][0], inds[0][1])[1] == nl.vdd:
                status = WARN
                d.append("inductor %s from DCCH to VDD: DC/DC REG1 configuration (needs the PS LC values, "
                         "firmware may enable DCDCEN only with the inductor fitted)" % inds[0][0])
            else:
                status = FAIL
                d.append("DCCH may only carry the DC/DC inductor to VDD, found %s" % fitted)
    else:
        d.append("unconnected: correct when the internal DC/DC converter is not used (LDO only, PS Fig.13)")
    rep.add("M09", "DCCH open (no DC/DC inductor) or inductor to VDD only", status, "PS_dcdc", d)


def check_gpio_nets(nl, rep):
    if not nl.module:
        rep.add("M10", "GPIO nets", SKIP, "E73_pins", [])
        return
    status = PASS
    d = []
    pn = nl.power_nets()
    seen = {}
    for pin in sorted(E73_GPIO):
        net = nl.modpin(pin)
        if net is None:
            continue
        if net in pn:
            status = FAIL
            d.append("pin %d %s is on %s" % (pin, E73_PINS[pin][0], nl.labels[net]))
        if net in seen:
            status = FAIL
            d.append("pins %d and %d (%s, %s) are shorted on net %s" % (seen[net], pin, E73_PINS[seen[net]][0],
                                                                        E73_PINS[pin][0], net))
        seen[net] = pin
    # fixed pins must not share nets with GPIO either
    for pin in (E73_VBUS, E73_DP, E73_DN, E73_SWDIO, E73_SWDCLK):
        net = nl.modpin(pin)
        if net in seen:
            status = FAIL
            d.append("fixed pin %d %s shares net %s with GPIO pin %d" % (pin, E73_PINS[pin][0], net, seen[net]))
    used = sorted(seen.values())
    d.append("%d GPIO-capable pins connected (incl. XL1/XL2, RESET, AIN): %s"
             % (len(used), [E73_PINS[p][0].split("/")[0] for p in used]))
    rep.add("M10", "no GPIO tied to a power rail, no two module pins shorted together", status, "E73_pins", d)


def check_gpio_overvoltage(nl, rep):
    """M11: nothing pulls a module GPIO above VDD (CHRG-style pull-up to 5 V, LED from VBUS, ...)."""
    if not nl.module:
        rep.add("M11", "GPIO over-voltage", SKIP, "PS_gpio", [])
        return
    status = PASS
    d = []
    hi_nets = {n for n in (nl.vbus, nl.vin, nl.vbat, nl.batp, nl.vaud) if n}
    for pin in sorted(E73_GPIO):
        net = nl.modpin(pin)
        if net is None:
            continue
        name = E73_PINS[pin][0]
        for ref, p, onet in nl.two_pin_parts_on(net, ("res", "ind", "jumper", "led", "schottky", "mdiode")):
            if onet not in hi_nets:
                continue
            k = nl.kind[ref]
            vmax = nl.net_voltage_max(onet)
            if k == "res":
                rtop = parse_number(nl.value(ref), "R")
                rbot = [v for _, v in nl.resistors_between(net, nl.gnd)]
                if not rbot or rtop is None or any(v is None for v in rbot):
                    status = FAIL
                    d.append("pin %d %s pulled to %s through %s with no divider to GND -> %.1f V on a 3.3 V I/O"
                             % (pin, name, nl.labels[onet], ref, vmax))
                    continue
                rb = 1 / sum(1 / v for v in rbot)
                v = vmax * rb / (rtop + rb)
                d.append("pin %d %s: divider %s / %s from %s -> %.2f V max (limit VDD+0.3 = %.1f V)"
                         % (pin, name, fmt_r(rtop), fmt_r(rb), nl.labels[onet], v, V_VDD + 0.3))
                if v > V_VDD + 0.3:
                    status = FAIL
            elif k == "led":
                vf_typ, vf_min, _, _, _ = led_params(nl.parts[ref])
                v = vmax - vf_min
                a, kk, _ = nl.diode_ak(ref)
                if nl.net(ref, a) == onet:
                    d.append("pin %d %s: LED %s from %s to the pin -> up to %.2f V when the pin is high-Z"
                             % (pin, name, ref, nl.labels[onet], v))
                    if v > V_VDD + 0.3:
                        status = WARN if status == PASS else status
                        d.append("exceeds VI/O max VDD+0.3 V: use a LED with higher VF or drive from VDD")
            else:
                status = FAIL
                d.append("pin %d %s directly bridged to %s by %s" % (pin, name, nl.labels[onet], ref))
    if not d:
        d.append("no resistor / LED / jumper from a GPIO net to VBUS, VIN, VBAT or the switched 5 V (VAUD)")
    d.append("E73 I/O level is 3.3 V; 5 V signals would need 1k-5.1k series resistors (E73 p.9) - none present")
    rep.add("M11", "no pull-up above VDD into a GPIO (divider/LED analysis vs VI/O max VDD+0.3 V)", status, "PS_gpio", d)


def check_module_pin_names(nl, rep):
    if not nl.module:
        rep.add("M12", "module symbol pin names", SKIP, "E73_pins", [])
        return
    status = PASS
    d = []
    pins = nl.parts[nl.module]["pins"]
    missing = [p for p in E73_PINS if str(p) not in pins]
    if missing:
        status = FAIL
        d.append("module symbol lacks pins %s" % missing)
    named = 0
    for p, (fn, ball) in E73_PINS.items():
        nm = nl.pin_name(nl.module, p).upper().replace("USB_", "")
        if not nm:
            continue
        named += 1
        exp = fn.upper()
        if nm.split("/")[0] != exp.split("/")[0] and nm != exp:
            status = FAIL
            d.append("pin %d is named '%s' in the netlist but the datasheet says %s (ball %s)" % (p, nm, fn, ball))
    d.append("%d of 43 pins carry a name in the netlist; all compared names match the datasheet" % named
             if status == PASS else "%d pins named" % named)
    rep.add("M12", "E73 symbol pin numbers/names agree with the datasheet pin table", status, "E73_pins", d)


# ---------------------------------------------------------------- charger ---
# The charger is a Microchip MCP73831T-2ACI/OT (MCP73831_C424093.pdf).  The TP4054 is still
# recognised (VBAT role, D01 CHRG sink, P04) so the BlueMicro840 reference keeps its power-path checks, but
# the C-series below are MCP73831 checks and SKIP on a TP4054 board.
def mcp_charger(nl, rep, code, title, src):
    """The MCP73831/2 ref, or None after adding a SKIP line for `code`."""
    if nl.charger and nl.chg_model in ("MCP73831", "MCP73832"):
        return nl.charger
    if nl.charger:
        why = "charger is a %s: the MCP73831 checks do not apply (the TP4054 is still used for the VBAT " \
              "role, D01 and P04)" % nl.chg_model
    else:
        why = "no MCP73831 charger in this netlist"
    rep.add(code, title, SKIP, src, [why])
    return None


def chg_pin(nl, ch, role):
    return nl.pin_by_role(ch, CHARGER_ROLE, role)


def chg_net(nl, ch, role):
    p = chg_pin(nl, ch, role)
    return nl.net(ch, p) if p else None


def mcp_ireg_mA(r_ohm):
    """IREG [mA] = 1000 V / RPROG [kOhm] (MCP73831_C424093.pdf p.15)."""
    return 1000.0 / (r_ohm / 1e3)


def check_charger_pins(nl, rep):
    title = "MCP73831: pinout, VDD on VBUS (3.75-6 V, abs max 7 V), VSS on GND, VBAT on the battery net, 4.20 V option"
    ch = mcp_charger(nl, rep, "C01", title, "MCP_pins")
    if not ch:
        return
    status = PASS
    d = []
    n = {role: chg_net(nl, ch, role) for role in ("STAT", "GND", "BAT", "VDD", "PROG")}
    d.append("%s: STAT(1) %s | VSS(2) %s | VBAT(3) %s | VDD(4) %s | PROG(5) %s"
             % (nl.desc(ch), nl.label(n["STAT"]), nl.label(n["GND"]), nl.label(n["BAT"]), nl.label(n["VDD"]),
                nl.label(n["PROG"])))
    for p, role in CHARGER_ROLE.items():
        nm = nl.pin_name(ch, p).upper()
        if p not in nl.parts[ch]["pins"]:
            status = FAIL
            d.append("pin %s (%s) missing from the symbol" % (p, role))
        elif nm and nm not in CHARGER_ALIASES[role]:
            status = FAIL
            d.append("pin %s is named '%s' but SOT-23-5 pin %s is %s (Table 3-1, p.11)" % (p, nm, p, role))
    if n["VDD"] is None or n["VDD"] != nl.vbus:
        status = FAIL
        d.append("VDD must be the USB VBUS net (the charger input); found %s" % nl.label(n["VDD"]))
    else:
        d.append("VDD on VBUS: USB 4.75-%.1f V inside 3.75-6 V (p.3) and above VREG + 0.3 V = 4.5 V "
                 "(recommended, p.11 3.1); abs max 7.0 V" % V_VBUS_MAX)
    if n["GND"] is None or n["GND"] != nl.gnd:
        status = FAIL
        d.append("VSS must be on ground")
    if n["BAT"] is None or n["BAT"] in (nl.gnd, nl.vbus, nl.vin, nl.vdd, nl.vaud):
        status = FAIL
        d.append("VBAT must be the battery net, found %s" % nl.label(n["BAT"]))
    elif nl.batconn:
        d.append("VBAT -> %s -> battery connector %s" % (
            "power switch / bypass jumper" if nl.batp != n["BAT"] else "directly", nl.desc(nl.batconn)))
    else:
        status = WARN if status == PASS else status
        d.append("no 2-pin battery connector reaches VBAT (board without battery?)")
    if n["PROG"] is None:
        status = FAIL
        d.append("PROG unconnected: the charger is disabled (p.13 4.3) - see C03")
    if n["STAT"] is None:
        d.append("STAT unconnected (allowed: status output only)")
    vreg = mcp_vreg(nl.parts[ch])
    if vreg is None:
        status = WARN if status == PASS else status
        d.append("regulation-voltage option (-2/-3/-4/-5) not identifiable from LCSC code, value or note")
    elif abs(vreg - 4.20) > 0.005:
        status = FAIL
        d.append("MCP7383X option VREG = %.2f V: a standard 4.2 V Li-ion/Li-Po cell would be overcharged "
                 "(the rest of the design, P06, assumes 4.2 V)" % vreg)
    else:
        d.append("%s: VREG 4.20 V +-0.75 %% (4.168-4.232 V, p.3); option AC: precondition 10 %%, VPTH 66.5 %%, "
                 "termination 7.5 %%, recharge at 96.5 %% (p.26)"
                 % MCP_LCSC_PART.get((nl.parts[ch].get("lcsc") or "").upper(), "MCP73831-2"))
    rep.add("C01", title, status, "MCP_pins", d)


def check_charger_bypass(nl, rep):
    title = "MCP73831 VDD: bypass >= 4.7 uF and a transient clamp on the hot-pluggable USB input"
    ch = mcp_charger(nl, rep, "C02", title, "MCP_vdd")
    if not ch:
        return
    vdd = chg_net(nl, ch, "VDD")
    caps = nl.cap_list(vdd)
    damped = damped_caps(nl, vdd)
    tot = sum(c for _, c in caps if c) + sum(c for _, _, _, c in damped if c)
    need = CHARGER_MODELS[nl.chg_model]["vdd_cap"]
    d = ["capacitors %s-GND: %s = %s" % (nl.label(vdd), [(r, fmt_c(c)) for r, c in caps] or "none",
                                        fmt_c(sum(c for _, c in caps if c)) if caps else "0")]
    for rr, rv, cr, cv in damped:
        d.append("and %s through %s %s (hot-plug damping, see U04): %s of bypass with %s of added series "
                 "resistance, like a tantalum's ESR (the datasheet sets no ESR limit for the VDD bypass)"
                 % (cr, rr, fmt_ohm(rv), fmt_c(cv), fmt_ohm(rv)))
    status = PASS
    if tot < need * 0.999:
        status = FAIL
        d.append("p.11 3.1: 'Bypass to VSS with a minimum of 4.7 uF' - the VDD net has only %s" % fmt_c(tot))
    else:
        d.append(">= 4.7 uF (p.11 3.1); nominal values: 0603 X5R parts lose capacitance under 5 V bias, keep the "
                 "largest one next to pin 4 (layout)")
    tvs = [r for r in nl.fitted("tvs") if tvs_on(nl, r) == (vdd, nl.gnd)]
    if tvs:
        d.append("transient clamp: %s, a 5 V TVS from %s to GND = the 'transzorb from V+ to 0 V' of p.18, the "
                 "same class as the SMAJ5.0A of Fig.6-1" % (tvs, nl.label(vdd)))
    clamps = [(r, p) for r, p in nl.mems(vdd) if nl.kind[r] == "esd" and USBLC6_ROLE.get(p) == "VBUS"]
    if tvs:
        pass
    elif not clamps:
        status = FAIL
        d.append("p.18 6.1.1.2: input over-voltage protection 'must be used' when the source is hot-pluggable "
                 "(USB cables included): no transient clamp (TVS / ESD array VBUS pin) on %s" % nl.label(vdd))
    else:
        d.append("transient clamp: %s pin 5 clamps %s to GND (VBR >= 6 V at 1 mA, usblc6.pdf p.2) = the "
                 "'transzorb from V+ to 0 V' of p.18; an ESD-class clamp, smaller than the SMAJ5.0A of Fig.6-1"
                 % (clamps[0][0], nl.label(vdd)))
    rep.add("C02", title, status, "MCP_vdd", d)


def check_charger_prog(nl, rep):
    title = "MCP73831 PROG: RPROG to GND within 2-67 kOhm -> charge current, jumper options, switch rating, heat"
    ch = mcp_charger(nl, rep, "C03", title, "MCP_prog")
    if not ch:
        return
    prog = chg_net(nl, ch, "PROG")
    d = ["PROG(5) -> %s" % nl.label(prog)]
    status = PASS
    if prog is None:
        rep.add("C03", title, FAIL, "MCP_prog", d + ["PROG floating = charger disabled (p.13 4.3, p.15 5.2.2)"])
        return
    fixed, unknown = [], []
    for ref, pin, onet in nl.two_pin_parts_on(prog, ("res",)):
        if onet == nl.gnd:
            v = parse_number(nl.value(ref), "R")
            (fixed if v else unknown).append((ref, v))
        else:
            status = FAIL
            d.append("%s from PROG to %s - RPROG goes from PROG to VSS (p.15 5.1.2)" % (ref, nl.label(onet)))
    caps = nl.caps_between(prog, nl.gnd)
    if caps:
        status = WARN if status == PASS else status
        d.append("capacitor on PROG %s: not part of the datasheet circuit (p.17 Fig.6-1)" % caps)
    for r, p in nl.mems(prog, exclude=ch):
        if nl.kind[r] in ("res", "jumper", "cap"):
            continue
        if r == nl.module:
            d.append("module pin %s reads PROG (allowed: the pin is an analog voltage)" % p)
        else:
            status = FAIL
            d.append("%s (%s) must not be on PROG" % (r, nl.kind[r]))
    if unknown:
        status = WARN if status == PASS else status
        d.append("resistor(s) with non-numeric value on PROG: %s" % [r for r, _ in unknown])
    if not fixed:
        if not unknown:
            status = FAIL
            d.append("no RPROG to GND: PROG floats and the charger is disabled (p.13 4.3)")
        rep.add("C03", title, status, "MCP_prog", d)
        return
    r_fixed = 1 / sum(1 / v for _, v in fixed)
    options = [("fitted", r_fixed, [r for r, _ in fixed])]
    for ref, pin, onet in nl.two_pin_parts_on(prog, ("jumper",)):
        alt = [(r, parse_number(nl.value(r), "R")) for r, p, o in nl.two_pin_parts_on(onet, ("res",)) if o == nl.gnd]
        alt = [(r, v) for r, v in alt if v]
        if alt:
            options.append(("jumper %s closed" % ref, 1 / (1 / r_fixed + sum(1 / v for _, v in alt)),
                            [r for r, _ in fixed] + [r for r, _ in alt]))
    lo, hi = MCP_RPROG
    imax = 0.0
    for label, r, refs in options:
        i = mcp_ireg_mA(r)
        imax = max(imax, i)
        d.append("%s: RPROG = %s (%s) -> IREG = 1000 V / %.2f kOhm = %.0f mA (+-10 %%: p.3 gives 90-110 mA at 10k, "
                 "450-550 mA at 2k)" % (label, fmt_r(r), "||".join(refs), r / 1e3, i))
        if r > 200e3:
            status = FAIL
            d.append("  RPROG above the 70-200 kOhm shutdown impedance: charger disabled (p.4)")
        elif not (lo * 0.999 <= r <= hi * 1.001):
            status = FAIL
            d.append("  outside the 2-67 kOhm charge-current range (p.4): %.0f mA is not a specified setting" % i)
    for sw in nl.refs("slide"):
        if nl.vbat in {nl.net(sw, p) for p in nl.pins_of(sw)}:
            d.append("charge current flows through power switch %s rated 0.3 A (C221660.pdf p.1): max %.0f mA x 1.1 "
                     "= %.0f mA %s" % (sw, imax, imax * 1.1, "OK" if imax * 1.1 <= 300 else "EXCEEDS the rating"))
            if imax * 1.1 > 300:
                status = FAIL
    vpth_min = MCP_OPT_AC["vpth_min"] * 4.2
    for label, r, refs in options:
        i = mcp_ireg_mA(r) * 1.1 / 1000
        p = (V_VBUS_MAX - vpth_min) * i
        d.append("%s: worst-case dissipation (VDD %.1f V, VBAT at VPTH min %.2f V, IREG +10 %%) = %.2f W -> "
                 "+%.0f C on a minimum-copper SOT-23-5 (230 C/W, p.5; 130 C/W with large copper)"
                 % (label, V_VBUS_MAX, vpth_min, p, p * MCP_THETA_JA))
    d.append("above ~80 C die temperature the charger trims its current itself (thermal regulation, p.14 "
             "Fig.4-2; p.18 6.1.1.3) - expected behaviour at the higher setting, not a fault")
    rep.add("C03", title, status, "MCP_prog", d)


def check_charger_stat(nl, rep):
    title = "MCP73831 STAT tri-state output: LED wiring and current in the L / H / Hi-Z states, no 5 V into a GPIO"
    ch = mcp_charger(nl, rep, "C04", title, "MCP_stat")
    if not ch:
        return
    md = CHARGER_MODELS[nl.chg_model]
    stat = chg_net(nl, ch, "STAT")
    vdd = chg_net(nl, ch, "VDD")
    d = ["STAT(1) -> %s ; output type %s (Table 5-1, p.15)" % (nl.label(stat), md["stat"])]
    status = PASS
    if stat is None:
        rep.add("C04", title, WARN, "MCP_stat", d + ["unused (allowed by p.11 3.3, but no charge indication)"])
        return
    if stat in nl.power_nets():
        rep.add("C04", title, FAIL, "MCP_stat", d + ["STAT is a driven output and must not sit on %s"
                                                    % nl.labels[stat]])
        return
    vdd_nom = nl.net_voltage_nom(vdd) or V_VBUS_NOM
    vdd_max = nl.net_voltage_max(vdd) or V_VBUS_MAX
    gp = [p for r, p in nl.mems(stat) if r == nl.module]
    if gp:
        if md["stat"] == "tri-state":
            status = FAIL
            d.append("module pin %s directly on STAT: in charge complete STAT drives HIGH to VDD = %.1f V "
                     "(VOH = VDD - 0.4 V, p.4) into a 3.3 V I/O (VI/O max VDD + 0.3 V, nrf52840 PS p.612); "
                     "use a divider or the open-drain MCP73832" % (gp, vdd_max))
        else:
            d.append("module pin %s reads the open-drain STAT (pull-up to VDD only)" % gp)
    lit = []
    for ref, pin, onet in nl.two_pin_parts_on(stat, ("res",)):
        r = parse_number(nl.value(ref), "R")
        if r is None:
            status = WARN if status == PASS else status
            d.append("%s on STAT has no numeric value" % ref)
            continue
        if onet in nl.power_nets():
            vo = nl.net_voltage_max(onet) or 0.0
            if onet == nl.gnd:
                i = (vdd_max - md.get("voh_drop", 0.4)) / r * 1e3
                d.append("%s %s pull-down: %.1f mA sourced when STAT is H (max %.0f mA)" % (ref, fmt_r(r), i, md["source_mA"]))
                if md["stat"] != "tri-state" or i > md["source_mA"]:
                    status = FAIL
            else:
                i = (vo - md["vol"]) / r * 1e3
                d.append("%s %s pull-up to %s: %.1f mA sunk when STAT is L (max %.0f mA)" % (ref, fmt_r(r), nl.labels[onet], i, md["sink_mA"]))
                if i > md["sink_mA"]:
                    status = FAIL
            continue
        leds = nl.two_pin_parts_on(onet, ("led",), exclude=ref)
        if not leds:
            status = WARN if status == PASS else status
            d.append("%s from STAT to %s: unknown load" % (ref, nl.label(onet)))
            continue
        for l, lp, lo in leds:
            a, k, assumed = nl.diode_ak(l)
            vf, vfmin, ifmax, src, generic = led_params(nl.parts[l])
            if nl.net(l, k) == onet:            # LED -> R -> STAT: lit while STAT sinks (L = charging)
                sup = nl.net(l, a)
                vs = nl.net_voltage_nom(sup)
                if vs is None:
                    status = FAIL
                    d.append("LED %s anode on %s, which is not a supply" % (l, nl.label(sup)))
                    continue
                i = (vs - vf - md["vol"]) / r * 1e3
                d.append("LED %s (%s): %s -> LED -> %s %s -> STAT: charging (STAT L, VOL %.1f V typ) -> %.2f mA "
                         "(STAT sinks <= %.0f mA, LED IF max %.0f mA)"
                         % (l, nl.value(l), nl.labels[sup], ref, fmt_r(r), md["vol"], i, md["sink_mA"], ifmax))
                if i <= 0 or i > md["sink_mA"] or i > ifmax:
                    status = FAIL
                    d.append("  current outside the STAT sink / LED limits")
                if md["stat"] == "tri-state":
                    vmax_s = nl.net_voltage_max(sup) or vs
                    across = vmax_s - (vdd_max - 1.0)      # VOH min = VDD - 1 V
                    if sup == vdd:
                        d.append("  charge complete (STAT H = VDD - 0.4 V typ, >= VDD - 1 V): at most 1 V across "
                                 "LED + resistor < VF min %.1f V -> off" % vfmin)
                    elif across >= vfmin:
                        status = FAIL
                        d.append("  charge complete: STAT H only reaches VDD - 1 V; %s can still drive %.1f V "
                                 "across the LED -> it would not turn off" % (nl.labels[sup], across))
                    else:
                        d.append("  charge complete: STAT H above the LED anode -> reverse biased, off")
                lit.append(l)
            elif nl.net(l, a) == onet:          # STAT -> R -> LED -> GND: lit while STAT sources (H)
                if md["stat"] != "tri-state":
                    status = FAIL
                    d.append("LED %s anode faces an open-drain STAT: it can never light" % l)
                    continue
                cat = nl.net(l, k)
                if cat != nl.gnd:
                    status = FAIL
                    d.append("LED %s cathode on %s, expected GND" % (l, nl.label(cat)))
                    continue
                i = (vdd_nom - md.get("voh_drop", 0.4) - vf) / r * 1e3
                d.append("LED %s: STAT -> %s %s -> LED -> GND: lit on charge complete (STAT H) at %.2f mA "
                         "(source <= %.0f mA, LED IF max %.0f mA)" % (l, ref, fmt_r(r), i, md["source_mA"], ifmax))
                if i <= 0 or i > md["source_mA"] or i > ifmax:
                    status = FAIL
                lit.append(l)
    direct = nl.two_pin_parts_on(stat, ("led",))
    if direct:
        status = FAIL
        d.append("LED %s directly on STAT without a series resistor" % [l for l, _, _ in direct])
    if lit:
        d.append("shutdown (USB absent / VDD < UVLO / PROG open) and no battery: STAT Hi-Z (leakage <= 1 uA) -> "
                 "LED off; the no-battery state needs the battery detection to work, see C06")
    rep.add("C04", title, status, "MCP_stat", d)


def check_charger_outcap(nl, rep):
    title = "MCP73831 VBAT capacitor >= 4.7 uF (loop stability with the battery disconnected)"
    ch = mcp_charger(nl, rep, "C05", title, "MCP_vbat")
    if not ch:
        return
    bat = chg_net(nl, ch, "BAT")
    caps = nl.cap_list(bat)
    tot = sum(c for _, c in caps if c)
    need = CHARGER_MODELS[nl.chg_model]["vbat_cap"]
    d = ["capacitors on %s: %s" % (nl.label(bat), [(r, fmt_c(c)) for r, c in caps] or "none")]
    if tot < need * 0.999:
        status = FAIL
        d.append("p.11 3.2: 'Bypass to VSS with a minimum of 4.7 uF to ensure loop stability when the battery is "
                 "disconnected' - only %s here" % fmt_c(tot))
    else:
        status = PASS
        d.append("%s >= 4.7 uF; any capacitor type / ESR is fine (p.18 6.1.1.4) - no series resistor needed "
                 "(unlike the TP4054)" % fmt_c(tot))
    rep.add("C05", title, status, "MCP_vbat", d)


def check_charger_detect(nl, rep):
    title = "MCP73831 battery detection: > 7 MOhm on VBAT with the cell disconnected (STAT Hi-Z, LED off)"
    ch = mcp_charger(nl, rep, "C06", title, "MCP_det")
    if not ch:
        return
    bat = chg_net(nl, ch, "BAT")
    rails = {n for n in nl.power_nets() if n not in (bat, nl.batp)}
    z, used = nl.resistance_to_rails(bat, rails)
    d = ["cell disconnected (connector empty, or power switch open while on USB): VBAT = %s" % nl.label(bat)]
    others = []
    for r, p in nl.mems(bat):
        k = nl.kind[r]
        if r == ch or k in ("cap", "res", "conn", "slide", "jumper", "tp"):
            continue
        others.append((r, p, k))
    for r, p, k in others:
        if k == "pmos":
            d.append("%s drain on VBAT: off while USB is present; its body diode (VBAT -> VIN) stays reverse "
                     "biased as long as VIN (VBUS - Schottky, ~4.6 V) is above the 4.3 V no-battery level" % r)
        else:
            d.append("%s.%s (%s) also on VBAT: not counted (non-linear / high impedance)" % (r, p, k))
    vreg = mcp_vreg(nl.parts[ch]) or 4.20
    vnobat = vreg + 0.1
    if z is None:
        d.append("no resistive path from VBAT to any rail: impedance >> 7 MOhm -> 'No Battery Present' is "
                 "detected, STAT Hi-Z, LED off (p.13 4.2, Table 5-1)")
        rep.add("C06", title, PASS, "MCP_det", d)
        return
    d.append("resistive load on VBAT: %s through %s" % (fmt_r(z), used))
    if z >= MCP_ZNOBAT:
        d.append(">= 7 MOhm: even the minimum detection current (0.6 uA) lifts VBAT above VREG + 100 mV -> "
                 "no battery detected, STAT Hi-Z (p.13 4.2)")
        rep.add("C06", title, PASS, "MCP_det", d)
        return
    v_min = MCP_IDET_MIN * z
    i_need = vnobat / z
    cvbat = nl.cap_total(bat)
    tau = z * cvbat if cvbat else None
    vrth = MCP_OPT_AC["vrth"] * vreg
    d.append("p.13 4.2: 'the impedance seen by the VBAT pin before the battery is connected must be greater than "
             "7 MOhm'; here %s: the minimum detection current gives 0.6 uA x %s = %.2f V, below VNO_BAT = VREG + "
             "100 mV = %.2f V, so any part whose detection current is below %.2f uA (datasheet: 0.6 min, 6 typ) "
             "takes the empty VBAT for a discharged cell" % (fmt_r(z), fmt_r(z), v_min, vnobat, i_need * 1e6))
    if tau:
        t_lo = tau * math.log(vreg / vrth)
        t_hi = tau * math.log((vreg - v_min) / (vrth - v_min)) if vrth > v_min else t_lo
        d.append("then, instead of 'No Battery Present' (STAT Hi-Z, Table 5-1), it charges the %s on VBAT (STAT L: "
                 "LED on for ~tTERM 0.4-3.2 ms), terminates (STAT H), the %s load pulls VBAT below VRTH = %.1f %% x "
                 "%.2f V = %.2f V in ~%.1f-%.1f s (tau %s x %s = %.0f s) and starts again: the charge LED can flicker "
                 "periodically on a board without battery or with the power switch off on USB"
                 % (fmt_c(cvbat), fmt_r(z), MCP_OPT_AC["vrth"] * 100, vreg, vrth, t_lo, t_hi, fmt_r(z), fmt_c(cvbat), tau))
    d.append("harmless for the parts and for charging a connected cell; but the 'STAT and LED stay off without a "
             "battery' behaviour is not guaranteed. Options: switch the divider (MOSFET from a GPIO), move it to BAT+ "
             "(drains the cell when off) or raise it above 7 MOhm (conflicts with P06's 800 kOhm SAADC source limit)")
    rep.add("C06", title, FAIL, "MCP_det", d)


# -------------------------------------------------------------------- LDO ---
def fmt_ohm(v):
    return fmt_r(v) if v >= 1000 else "%s ohm" % fmt_r(v)


def damped_caps(nl, net, max_ohm=2.2):
    """[(resistor, ohm, capacitor, farad)]: capacitors to GND reached from `net` through one low-value resistor
    (an RC damping branch: the resistor is the capacitor's only other connection)."""
    out = []
    for r, pin, mid in nl.two_pin_parts_on(net, ("res",)):
        rv = parse_number(nl.value(r), "R")
        if rv is None or rv > max_ohm or mid is None or mid in nl.power_nets():
            continue
        others = nl.mems(mid, exclude=r)
        caps = [(c, parse_number(nl.value(c), "F")) for c, _, o in nl.two_pin_parts_on(mid, ("cap",)) if o == nl.gnd]
        if caps and len(others) == len(caps):
            out += [(r, rv, c, cv) for c, cv in caps]
    return out


def tvs_on(nl, ref):
    """(cathode net, anode net) of a unidirectional TVS."""
    a, k, _ = nl.diode_ak(ref)
    return nl.net(ref, k), nl.net(ref, a)


def hub_ldo(nl, net):
    """The regulator whose output is `net` and whose input and enable are VBUS, or None."""
    for r in nl.fitted("ldo"):
        if nl.net(r, "5") == net and nl.net(r, "1") == nl.vbus and nl.net(r, "3") == nl.vbus:
            return r
    return None


def charger_rprog_min(nl):
    """Smallest PROG resistance (jumpers closed): the highest charge current the board can be set to."""
    if not nl.charger:
        return None
    prog = chg_net(nl, nl.charger, "PROG")
    rs = [v for _, v in nl.resistors_between(prog, nl.gnd) if v]
    for jp in nl.fitted("jumper"):
        nets = [nl.net(jp, p) for p in nl.pins_of(jp)]
        if prog in nets:
            other = [n for n in nets if n != prog][0]
            rs += [v for _, v in nl.resistors_between(other, nl.gnd) if v]
    return 1.0 / sum(1.0 / v for v in rs) if rs else None


def check_reverse_battery(nl, rep):
    """P07: a reversed cell must not reach the board: series P-MOSFET, drain on the connector, gate on GND."""
    title = "reverse-battery P-MOSFET: drain on the connector, gate on GND, source towards the board; on for a cell, off reversed"
    if nl.batconn is None:
        rep.add("P07", title, SKIP, "REV_fet", ["no battery connector"])
        return
    q = nl.revfet
    if q is None:
        rep.add("P07", title, WARN, "REV_fet", [
            "the connector's + (%s) reaches the board with no series protection: a reversed cell drives the "
            "charger's VBAT pin negative (abs max -0.3 V, MCP73831 p.3)" % nl.label(nl.batp)])
        return
    g, s, dr = nl.net(q, "1"), nl.net(q, "2"), nl.net(q, "3")
    d = ["%s: G(1) -> %s ; S(2) -> %s ; D(3) -> %s" % (nl.desc(q), nl.label(g), nl.label(s), nl.label(dr))]
    status = PASS
    if nl.revfet_swapped:
        rep.add("P07", title, FAIL, "REV_fet", d + [
            "SOURCE/DRAIN SWAPPED: the source is on the connector, so the body diode (D->S) points from the board to "
            "the connector and conducts a reversed cell straight into %s: no protection" % nl.label(nl.batp)])
        return
    other = [(r, p) for r, p in nl.mems(nl.batin) if r not in (nl.batconn, q) and nl.kind[r] != "tp"]
    if other:
        status = FAIL
        d.append("%s also reaches %s: it would bypass the protection" % (other, nl.label(nl.batin)))
    d.append("cell the right way round: the body diode (D->S) conducts first, then VGS = -(cell) = -3.0..-4.2 V "
             "(|VGS| <= 8 V abs max, beyond the -1 V threshold) turns the channel on: RDS(on) <= 0.142 Ohm at -2.5 V "
             "-> <= 28 mV at the 200 mA charge current, <= 7 mV at the board's ~50 mA; charging flows S->D through "
             "the on channel")
    d.append("cell reversed: the drain sits at -(cell); the body diode is reverse-biased (VDS rating -20 V) and with "
             "the gate at 0 V and the source at 0 V the channel is off: nothing reaches %s or the charger's VBAT pin"
             % nl.label(nl.batp))
    rprog = charger_rprog_min(nl)
    pre = 0.10 * mcp_ireg_mA(rprog) if rprog and nl.chg_model and nl.chg_model.startswith("MCP") else None
    if pre:
        d.append("reversed with USB in and the switch on: the charger raises VBAT, the channel opens only while the "
                 "source is a threshold (0.4-1 V) above the gate, so VBAT settles there instead of at -(cell): the "
                 "charger's pin stays >= 0 V (-0.3 V abs max) and it preconditions at 10 %% = %.0f mA (VBAT < VPTH, "
                 "p.4, p.26): %.2f W in the FET (0.86 W rating)" % (pre, pre * 1e-3 * (V_VBAT_MAX + 1.0)))
    if g != nl.gnd:
        status = FAIL
        d.append("gate must be on GND")
    rep.add("P07", title, status, "REV_fet", d)


def check_vbus_protection(nl, rep):
    """U04: the hot-pluggable VBUS: TVS at the receptacle, RC damping of the cable's inductance, capacitance."""
    title = "VBUS: 5 V TVS to GND, damped bulk capacitor (R <= 2.2 ohm), at most 10 uF at attach"
    if nl.vbus is None:
        rep.add("U04", title, SKIP, "VBUS_prot", [])
        return
    status = PASS
    d = []
    tvs = [r for r in nl.fitted("tvs") if tvs_on(nl, r) == (nl.vbus, nl.gnd)]
    rev = [r for r in nl.fitted("tvs") if tvs_on(nl, r) == (nl.gnd, nl.vbus)]
    if rev:
        status = FAIL
        d.append("%s reversed: a unidirectional TVS with its anode on VBUS conducts at 0.7 V" % rev)
    if tvs:
        d.append("%s (%s): cathode on VBUS, anode on GND; breakdown >= 6.4 V, above USB's 5.25 V (5.5 V for USB-C), "
                 "so it only conducts on surges, ESD and what is left of the hot-plug ring; standoff 5.0 V like the "
                 "SMAJ5.0A of the charger's datasheet (leakage at 5 V: 0.4 mA max, typically far less)"
                 % (tvs, ", ".join(nl.value(r) for r in tvs)))
    elif not rev:
        status = WARN
        d.append("no TVS on VBUS: only the ESD array's VBUS pin clamps it")
    direct = nl.cap_list(nl.vbus)
    damped = damped_caps(nl, nl.vbus)
    c_dir = sum(c for _, c in direct if c)
    c_dmp = sum(c for _, _, _, c in damped if c)
    d.append("VBUS capacitors: %s = %s directly%s" % ([r for r, _ in direct], fmt_c(c_dir), "; %s through %s" % (
        fmt_c(c_dmp), sorted({"%s %s" % (r, fmt_ohm(v)) for r, v, _, _ in damped})) if damped else ""))
    if damped:
        d.append("the damped branch (series resistance comparable to sqrt(L/C) of a 0.5-1 uH cable with the board's "
                 "capacitance, 0.3-0.7 ohm) takes the energy out of the hot-plug ring: simulated peak 6.0-8.3 V "
                 "undamped, 5.0-6.6 V damped; the TVS then clamps what remains")
    else:
        status = WARN if status == PASS else status
        d.append("ceramic only: the cable's inductance rings the capacitance up to ~1.5x the step on hot plug")
    if c_dir + c_dmp > 10e-6 * 1.001:
        status = WARN if status == PASS else status
        d.append("%s on VBUS: more than USB 2.0's 10 uF at attach" % fmt_c(c_dir + c_dmp))
    else:
        d.append("%s on VBUS at attach (USB 2.0: at most 10 uF)" % fmt_c(c_dir + c_dmp))
    hubs = [h for h in nl.fitted("hub") if ic_net(nl, h, CH334P_PINS, "V5") == nl.vbus]
    if hubs:
        status = WARN if status == PASS else status
        d.append("the hub's V5 (abs max 5.5 V) is on VBUS: a damped ring can still pass it - power it at 3.3 V (H01)")
    rep.add("U04", title, status, "VBUS_prot", d)


def check_amp_suspend(nl, rep):
    """A15: the amplifier off while the codec is suspended: PDSW (open drain) drives an N-MOSFET that pulls EN low."""
    title = "headphone amplifier off in USB suspend: codec PDSW -> pull-up -> N-MOSFET holding the amplifier's EN low"
    amps, codecs = nl.fitted("hpamp"), nl.fitted("codec")
    if not (amps and codecs):
        rep.add("A15", title, SKIP, "CM_pdsw", ["no amplifier / codec"])
        return
    c = codecs[0]
    pd = nl.net(c, "40")
    if pd is None:
        rep.add("A15", title, WARN, "CM_pdsw", ["PDSW (pin 40) unused: the amplifier stays on (2.1 mA) while the "
                                                "host sleeps; USB suspend allows 2.5 mA for the whole device"])
        return
    d = ["%s PDSW (pin 40) -> %s" % (c, nl.label(pd))]
    status = PASS
    ups = [(r, v, o) for r, p, o in nl.two_pin_parts_on(pd, ("res",))
           for v in [parse_number(nl.value(r), "R")] if o in nl.power_nets()]
    if not ups:
        status = FAIL
        d.append("no pull-up: PDSW is open drain, the gate would float in suspend")
    else:
        r, v, o = ups[0]
        vu = nl.net_voltage_nom(o)
        d.append("pull-up %s %s to %s (%.1f V): PDSW supports 1.8-5 V (app note p.8); %.0f uA while it drives low"
                 % (r, fmt_r(v), nl.label(o), vu or 0, (vu or 0) / v * 1e6))
        if vu is None or not 1.8 <= vu <= 5.5:
            status = FAIL
    fets = [q for q in nl.fitted("nmos") if nl.net(q, "1") == pd]
    if not fets:
        status = FAIL
        d.append("no N-MOSFET gate on PDSW")
    a = amps[0]
    en_pin = amp_net(nl, a, "EN")
    for q in fets:
        s, dr = nl.net(q, "2"), nl.net(q, "3")
        d.append("%s: G(1) -> %s ; S(2) -> %s ; D(3) -> %s" % (nl.desc(q), nl.label(pd), nl.label(s), nl.label(dr)))
        reach = {en_pin} | {o for r, p, o in nl.two_pin_parts_on(en_pin, ("res",))}
        if s != nl.gnd or dr not in reach:
            status = FAIL
            d.append("must pull the amplifier's EN (or its RC node) to GND")
        else:
            d.append("operation: PDSW low -> VGS 0 V -> off, EN follows its control; suspend: PDSW open -> gate at the "
                     "pull-up (>= 2.5 V threshold) -> on, EN below VIL 0.6 V -> amplifier shut down (< 1 uA instead "
                     "of 2.1 mA), the codec stays enumerated (no re-enumeration when the host wakes)")
    rep.add("A15", title, status, "CM_pdsw", d)


def check_ldo(nl, rep):
    ldos = nl.refs("ldo")
    if not ldos:
        rep.add("L01", "3.3 V regulator pin wiring", SKIP, "AP_pins", [])
        rep.add("L02", "3.3 V regulator input/output capacitors", SKIP, "AP_pins", [])
        rep.add("L03", "3.3 V regulator input voltage / enable level", SKIP, "AP_limits", [])
        return
    s1 = s2 = s3 = PASS
    d1, d2, d3 = [], [], []
    models = sorted({ldo_model(nl, r) for r in ldos})
    for ldo in ldos:
        m = LDO_MODELS[ldo_model(nl, ldo)]
        vin, gnd, en, nc, vout = (nl.net(ldo, p) for p in ("1", "2", "3", "4", "5"))
        d1.append("%s: IN(1) %s | GND(2) %s | EN(3) %s | NC(4) %s | OUT(5) %s"
                  % (nl.desc(ldo), nl.label(vin), nl.label(gnd), nl.label(en), nl.label(nc), nl.label(vout)))
        for pin, role in m["names"].items():
            nm = nl.pin_name(ldo, pin).upper()
            if nm and nm != role:
                s1 = FAIL
                d1.append("%s pin %s named '%s' but SOT-23-5 pin %s is %s" % (ldo, pin, nm, pin, role))
        if gnd != nl.gnd:
            s1 = FAIL
            d1.append("%s GND not on ground" % ldo)
        if vin is None or vout is None or vin == vout or vin == nl.gnd or vout == nl.gnd:
            s1 = FAIL
            d1.append("%s VIN/VOUT wiring wrong" % ldo)
        if nc is not None and nl.mems(nc, exclude=ldo):
            s1 = WARN if s1 == PASS else s1
            d1.append("%s NC pin connected to %s (datasheet: No Connection)" % (ldo, nl.label(nc)))
        if en is None:
            s1 = FAIL
            d1.append("%s EN floating: the internal pull-down keeps the regulator OFF" % ldo)
        elif en == vin:
            d1.append("%s EN tied to IN: on whenever %s is up (VEN(HI) >= %.1f V)" % (ldo, nl.label(vin), m["en_hi"]))
        elif en == nl.gnd:
            s1 = FAIL
            d1.append("%s EN tied to GND: regulator permanently off" % ldo)
        elif nl.module and nl.module in [r for r, _ in nl.mems(en)]:
            d1.append("%s EN driven by module pin %s (GPIO high >= %.1f V enables)"
                      % (ldo, [p for r, p in nl.mems(en) if r == nl.module], m["en_hi"]))
        else:
            s1 = WARN if s1 == PASS else s1
            d1.append("%s EN on %s" % (ldo, nl.label(en)))
        # capacitors
        cin = nl.caps_between(vin, nl.gnd) if vin else []
        cout = nl.caps_between(vout, nl.gnd) if vout else []
        tin = sum(c for _, c in cin if c)
        tout = sum(c for _, c in cout if c)
        inside = E73_INTERNAL_VDD_CAP if (vout == nl.vdd and nl.module) else 0.0
        d2.append("%s: CIN %s = %s ; COUT %s = %s%s" % (
            ldo, [r for r, _ in cin] or "-", fmt_c(tin) if cin else "none", [r for r, _ in cout] or "-",
            fmt_c(tout) if cout else "none", " (+ %s inside the module = %s)" % (fmt_c(inside), fmt_c(tout + inside))
            if inside else ""))
        if tin < 1e-6:
            s2 = FAIL
            d2.append("%s: input capacitor >= 1 uF required" % ldo)
        if tout < 1e-6:
            s2 = FAIL
            d2.append("%s: output capacitor >= 1 uF required for stability%s"
                      % (ldo, " - the BlueMicro840 reference leaves its second LDO output (Vout header pin) without a capacitor"
                         if vout != nl.vdd else ""))
        if m["cout_max"] and tout + inside > m["cout_max"] * 1.001:
            s2 = FAIL
            d2.append("%s: %s on the output exceeds the %s the datasheet allows (stability)"
                      % (ldo, fmt_c(tout + inside), fmt_c(m["cout_max"])))
        elif m["cout_max"]:
            d2.append("%s: within the 1-%s output range (nominal values; X5R parts lose some under bias, which "
                      "only adds margin to the maximum)" % (ldo, fmt_c(m["cout_max"])))
        # input voltage: from USB (directly, or through the Schottky), or from the battery
        if vin == nl.vin or vin == nl.vbus:
            hi = V_VBUS_MAX - (0.3 if vin == nl.vin else 0.0)
            lo = 3.0 if vin == nl.vin else 4.35
            d3.append("%s (%s): IN max ~%.1f V (USB 5.5 V%s) <= %.1f V recommended / %.1f V abs max; min ~%.1f V "
                      "(%s) >= %.1f V" % (ldo, ldo_model(nl, ldo), hi, " minus Schottky" if vin == nl.vin else "",
                                          m["vin"][1], m["abs_max"], lo,
                                          "from the battery: below ~3.4 V the output follows the cell"
                                          if vin == nl.vin else "USB low limit", m["vin"][0]))
            if hi > m["vin"][1]:
                s3 = FAIL
        elif vin == nl.vbat:
            d3.append("%s: VIN = VBAT (<= 4.2 V)" % ldo)
        else:
            s3 = WARN if s3 == PASS else s3
            d3.append("%s: VIN net %s not a known rail; voltage not verified" % (ldo, nl.label(vin)))
        feeds = sorted({nl.kind[r] for r, _ in nl.mems(vout, exclude=ldo) if nl.kind[r] not in ("cap", "tp")})
        d3.append("%s: output %s feeds %s; quiescent current %s" % (ldo, nl.label(vout), feeds or "nothing",
                                                                   m["iq"]))
    src = LDO_MODELS[models[-1]]["src"]
    rep.add("L01", "3.3 V regulators (%s): IN/GND/EN/NC/OUT wiring, EN level" % "/".join(models), s1, src, d1)
    rep.add("L02", "3.3 V regulators: input and output capacitors within the datasheet range", s2, src, d2)
    rep.add("L03", "3.3 V regulators: input voltage within the operating range, what each output feeds", s3,
            src if models == ["TPS7A02"] else "AP_limits", d3)


# ------------------------------------------------------------- power path ---
def check_schottky(nl, rep):
    ds = [r for r in nl.refs("schottky") if not nl.dnp(r)]
    if not ds:
        rep.add("P01", "Schottky VBUS -> VIN", SKIP, "B58_pins", ["no B5819W / 1N5819 found"])
        return
    status = PASS
    d = []
    found = False
    for ref in ds:
        a, k, assumed = nl.diode_ak(ref)
        an, kn = nl.net(ref, a), nl.net(ref, k)
        d.append("%s: anode(%s) -> %s ; cathode(%s) -> %s%s" % (nl.desc(ref), a, nl.label(an), k, nl.label(kn),
                                                             " [pin polarity assumed: SOD-123 pin1 = cathode]" if assumed else ""))
        if an == nl.vbus and kn == nl.vin:
            found = True
            d.append("correct: USB feeds VIN through the diode; the battery (on VIN when on battery) cannot push "
                     "current back into VBUS (VRRM 40 V >> 4.2 V); IO 1 A >> board current")
        elif an == nl.vin and kn == nl.vbus:
            status = FAIL
            d.append("REVERSED: the diode would let the battery feed VBUS and block USB power")
        elif not ({an, kn} & set(nl.power_nets())):
            # a Schottky used as a small-signal diode (e.g. the amplifier-enable discharge diode): not part of
            # the power path; its own function is checked where it is used (A14)
            d.append("signal use: neither pin on a power rail (not in the power path; see A14)")
        else:
            status = WARN if status == PASS else status
            d.append("on a power rail but not in the VBUS->VIN position")
    if not found:
        status = FAIL
        d.append("no Schottky from VBUS (anode) to VIN (cathode)")
    rep.add("P01", "B5819W Schottky: anode on VBUS, cathode on VIN (USB feeds VIN, no back-feed into VBUS)", status, "B58_pins", d)


def check_pmos(nl, rep):
    qs = [r for r in nl.refs("pmos") if not nl.dnp(r)]
    if not qs:
        rep.add("P02", "P-MOSFET battery switch", SKIP, "SI_pins", ["no SI2301 found"])
        return
    status = PASS
    d = []
    found = False
    for ref in qs:
        roles = {}
        for p, role in SOT23_PMOS_ROLE.items():
            nm = nl.pin_name(ref, p).upper()
            if nm and nm != role:
                status = FAIL
                d.append("%s pin %s named '%s' but SOT-23 pin %s is the %s" % (ref, p, nm, p, role))
            roles[role] = nl.net(ref, p)
        g, s, dr = roles["G"], roles["S"], roles["D"]
        vu = nl.value(ref).upper()
        if "SI2301" not in vu and (nl.parts[ref].get("lcsc") or "").upper() != "C10487":
            d.append("%s: pinout G/S/D = 1/2/3 assumed from the Si2301 datasheet (same SOT-23 convention)" % ref)
        d.append("%s: G(1) -> %s ; S(2) -> %s ; D(3) -> %s" % (nl.desc(ref), nl.label(g), nl.label(s), nl.label(dr)))
        if g == nl.vbus and s == nl.vin and dr == nl.vbat:
            found = True
            d.append("correct: USB present -> VGS = VBUS - VIN ~ +0.4 V -> channel off, body diode (D->S) reverse "
                     "biased since VIN (~4.6 V) > VBAT (<= 4.2 V): USB cannot reach the battery except through the charger")
            d.append("USB absent -> gate pulled to 0 V, VGS = -VBAT (-3.0..-4.2 V, |VGS| <= 8 V) -> channel on, "
                     "RDS(on) 0.11-0.14 Ohm; body diode D->S also conducts battery -> VIN at start-up")
            pulls = nl.resistors_between(g, nl.gnd)
            if not pulls:
                status = FAIL
                d.append("gate net has no pull-down resistor to GND: with USB unplugged the gate would float "
                         "(the BlueMicro840 uses 100k)")
            else:
                d.append("gate pull-down: %s" % [(r, fmt_r(v)) for r, v in pulls])
        elif g == nl.vbus and s == nl.vbat and dr == nl.vin:
            status = FAIL
            d.append("SOURCE/DRAIN SWAPPED: the body diode (D->S) would conduct from VIN into the battery whenever "
                     "USB is present (unregulated charging) and the channel could not block it")
        elif ref == nl.revfet:
            d.append("the reverse-battery FET between the connector and BAT+ (checked in P07)")
        else:
            status = WARN if status == PASS else status
            d.append("not in the VBUS-gate / VIN-source / VBAT-drain position")
    if not found:
        status = FAIL
    rep.add("P02", "SI2301 P-MOSFET: gate on VBUS, source on VIN, drain on VBAT, gate pull-down", status, "SI_pins", d)


def check_power_nets_distinct(nl, rep):
    pn = nl.power_nets()
    d = ["%s = %s" % (role, net) for net, role in pn.items()]
    status = PASS
    roles = list(pn.values())
    if len(set(roles)) != len(roles):
        status = FAIL
    # two different roles on the same net?
    byrole = defaultdict(list)
    for net, role in ((nl.gnd, "GND"), (nl.vbus, "VBUS"), (nl.vdd, "VDD"), (nl.vin, "VIN"), (nl.vbat, "VBAT"), (nl.batp, "BAT+")):
        if net:
            byrole[net].append(role)
    for net, rs in byrole.items():
        if len(rs) > 1 and set(rs) != {"VBAT", "BAT+"}:
            status = FAIL
            d.append("net %s carries %s - power rails shorted" % (net, rs))
        elif set(rs) == {"VBAT", "BAT+"}:
            d.append("BAT+ = VBAT: no power switch between the cell and the board")
    # hard bridges between rails (low-value resistors, inductors, closed jumpers)
    nets = list(pn)
    for i, a in enumerate(nets):
        for b in nets[i + 1:]:
            for ref, pin, onet in nl.two_pin_parts_on(a, ("res", "ind", "jumper", "tp")):
                if onet == b:
                    k = nl.kind[ref]
                    v = parse_number(nl.value(ref), "R") if k == "res" else None
                    if k == "jumper":
                        d.append("solder jumper %s between %s and %s (open by default)" % (ref, pn[a], pn[b]))
                        if {pn[a], pn[b]} != {"VBAT", "BAT+"}:
                            status = FAIL
                    elif k == "res" and v is not None and v >= 1000:
                        d.append("%s %s between %s and %s (bleeder / divider, fine)" % (ref, fmt_r(v), pn[a], pn[b]))
                    else:
                        status = FAIL
                        d.append("%s bridges %s and %s" % (nl.desc(ref), pn[a], pn[b]))
    rep.add("P03", "power rails GND/VBUS/VIN/VBAT/VDD are distinct nets, no hard bridge between them", status, "NETLIST", d)
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
