AndreaGiulianini/lira/(commit log)

2026-10-17 Lira: wireless keyboard (PCB, sound card, case, plate, firmware)
2026-10-17 Right-size the ground stitching: 916 -> 318 vias (5mm strip / 12mm key field), drop single-layer vias; no electrical change (DRC 0, ERC 0, netlist match, 51 checks pass)
2026-10-17 Case: fewer screws (24 -> 17): 8 M3 case screws and 6 plate ears, 3 back bolts; regenerate case, plates and fab files
2026-10-17 README: warn that the board has never been built or tested
    A prominent warning at the top of README.md and production/README.md (via publish.py): no prototype
    of either version exists, nothing has been tested on real hardware, do not put it into production.
2026-10-17 Fix placement data, silkscreen, firmware and docs
    Supply and placement (blocking before an order):
    - Hot-swap socket C2803348 is discontinued (0 stock): replaced by C41430893
    in the BOM, schematic, netlist and checks
    - cpl.csv: rotations converted to JLCPCB's convention (per-part LCSC
    footprint angle, bottom side 180 - angle) and origin offsets for J1, J3
    and SW101
    Board (silkscreen only; tracks, vias and placement unchanged, DRC 0 errors):
    - every label >= 1.0 mm; SW BYP, -6dB, VBAT, CHG and CAPS moved off pads
    and apart, in the generator and in the published board
    Firmware:
    - random Vial keyboard UID; fn+T (forget the paired host) removed from
    the default keymap; memory.x stops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
2026-10-17 Rework and re-route the board
    Circuit and board:
    - MAJ-1: reverse-battery P-MOSFET Q2 (SI2301) between the battery connector
    and the switch, gate to GND: a reversed cell finds it off
    - the hub (V5 abs max 5.5 V) on its own 3.3 V regulator U9 from VBUS
    (CH334 datasheet 6.4); SMF5.0A TVS at the receptacle; C107 through 1 ohm
    (R126) damps the hot-plug ring without adding capacitance
    - MIN-8: TPS7A0233 (25 nA) instead of the AP2112K (55 uA); C103 4.7 uF
    to stay inside its 1-22 uF output range
    - MIN-1/2: C137 470 -> 100 nF, R124 33k in series with the amplifier's EN
    - MIN-5: the codec's PDSW switches the amplifier off in USB suspend (Q3)
    - MIN-9/10: ground vias ringed around the module an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
